JNCox55/PLED/Documentation/Poster/GUI_EX.PNG

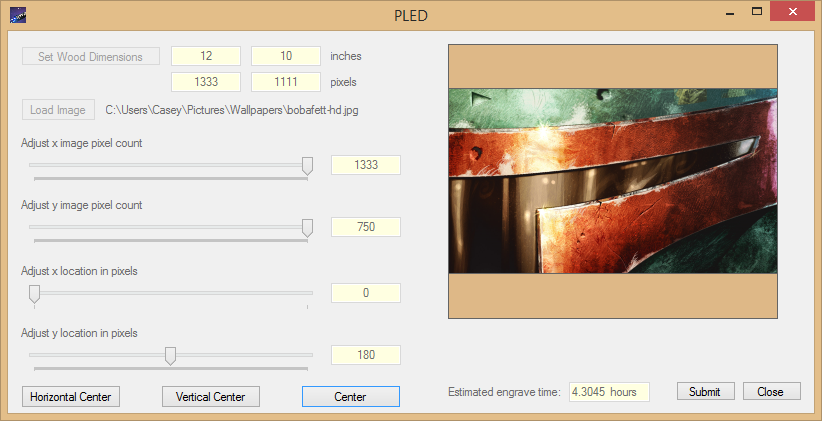
Documentation/Poster/GUI_EX.PNG
