JNCox55/PLED/Microcontroller Files./examples/boards/dk-tm4c123g/interrupts/readme.txt

Interrupts

This example application demonstrates the interrupt preemption and
tail-chaining capabilities of Cortex-M4 microprocessor and NVIC.  Nested
interrupts are synthesized when the interrupts have the same priority,
increasing priorities, and decreasing priorities.  With increasing
priorities, preemption will occur; in the other two cases tail-chaining
will occur.  The currently pending interrupts and the currently executing
interrupt will be displayed on the display; GPIO pins D0, D1 and D2 will
be asserted upon interrupt handler entry and de-asserted before interrupt
handler exit so that the off-to-on time can be observed with a scope or
logic analyzer to see the speed of tail-chaining (for the two cases where
tail-chaining is occurring).

-------------------------------------------------------------------------------

Copyright (c) 2011-2015 Texas Instruments Incorporated.  All rights reserved.
Software License Agreement

Texas Instruments (TI) is supplying this software for use solely and
exclusively on TI's microcontroller products. The software is owned by
TI and/or its suppliers, and is protected under applicable copyright
laws. You may not combine this software with "viral" open-source
software in order to form a larger program.

THIS SOFTWARE IS PROVIDED "AS IS" AND WITH ALL FAULTS.
NO WARRANTIES, WHETHER EXPRESS, IMPLIED OR STATUTORY, INCLUDING, BUT
NOT LIMITED TO, IMPLIED WARRANTIES OF MERCHANTABILITY AND FITNESS FOR
A PARTICULAR PURPOSE APPLY TO THIS SOFTWARE. TI SHALL NOT, UNDER ANY
CIRCUMSTANCES, BE LIABLE FOR SPECIAL, INCIDENTAL, OR CONSEQUENTIAL
DAMAGES, FOR ANY REASON WHATSOEVER.

This is part of revision 2.1.1.71 of the DK-TM4C123G Firmware Package.
