JNCox55/PLED/Microcontroller Files./examples/boards/dk-tm4c129x-boostxl-senshub/light_isl29023/readme.txt

Light Measurement with the ISL29023

This example demonstrates the basic use of the Sensor Library, DK-TM4C129X
and the SensHub BoosterPack to obtain ambient and infrared light
measurements with the ISL29023 sensor.

Note that the jumper on J36 for PQ7 must be disconnect to GREEN led as PQ7
is also used as INT signal by ISL29023.

The raw sensor measurements are printed to LCD and terminal. Connect a
serial terminal program to the DK-TM4C129X's ICDI virtual serial port at
115,200 baud.  Use eight bits per byte, no parity and one stop bit.  The
blue LED blinks to indicate the code is running.

-------------------------------------------------------------------------------

Copyright (c) 2013-2015 Texas Instruments Incorporated.  All rights reserved.
Software License Agreement

Texas Instruments (TI) is supplying this software for use solely and
exclusively on TI's microcontroller products. The software is owned by
TI and/or its suppliers, and is protected under applicable copyright
laws. You may not combine this software with "viral" open-source
software in order to form a larger program.

THIS SOFTWARE IS PROVIDED "AS IS" AND WITH ALL FAULTS.
NO WARRANTIES, WHETHER EXPRESS, IMPLIED OR STATUTORY, INCLUDING, BUT
NOT LIMITED TO, IMPLIED WARRANTIES OF MERCHANTABILITY AND FITNESS FOR
A PARTICULAR PURPOSE APPLY TO THIS SOFTWARE. TI SHALL NOT, UNDER ANY
CIRCUMSTANCES, BE LIABLE FOR SPECIAL, INCIDENTAL, OR CONSEQUENTIAL
DAMAGES, FOR ANY REASON WHATSOEVER.

This is part of revision 2.1.1.71 of the DK-TM4C129X Firmware Package.
