JNCox55/PLED/Microcontroller Files./examples/boards/dk-tm4c129x-em-trf7970atb/nfc_p2p_demo/readme.txt

NFC P2P Demo

This example application demonstrates the operation of the Tiva C Series
evaluation kit with the
TRF7970ATB Evaluation Module
as a NFC P2P device.

The application supports reading and writing Text, URI, and SmartPoster Tags.
The application gets a raw message buffer from the TRF79x0 stack, decodes
the information to recognized tag types, then re-encodes the data to a
buffer to be sent back out. The received tag information is displayed on the
lcd in both a summary screen and a detailed header information screen.
There is also a pulldown screen with buttons to echo the tag back and to
send a webpage link for the evaluation kit. In addition full debug
information is given across the UART0 channel to aid in NFC P2P development.

Please make sure to set the jumpers for the DK-TM4C129x board correctly.
J12, J13 set to EM_UART,
J16, J17 set to SPI

For more information on NFC please see the full NFC specification list at
http://www.nfc-forum.org/specs/spec_list/ .

-------------------------------------------------------------------------------

Copyright (c) 2014-2015 Texas Instruments Incorporated.  All rights reserved.
Software License Agreement

Texas Instruments (TI) is supplying this software for use solely and
exclusively on TI's microcontroller products. The software is owned by
TI and/or its suppliers, and is protected under applicable copyright
laws. You may not combine this software with "viral" open-source
software in order to form a larger program.

THIS SOFTWARE IS PROVIDED "AS IS" AND WITH ALL FAULTS.
NO WARRANTIES, WHETHER EXPRESS, IMPLIED OR STATUTORY, INCLUDING, BUT
NOT LIMITED TO, IMPLIED WARRANTIES OF MERCHANTABILITY AND FITNESS FOR
A PARTICULAR PURPOSE APPLY TO THIS SOFTWARE. TI SHALL NOT, UNDER ANY
CIRCUMSTANCES, BE LIABLE FOR SPECIAL, INCIDENTAL, OR CONSEQUENTIAL
DAMAGES, FOR ANY REASON WHATSOEVER.

This is part of revision 2.1.1.71 of the DK-TM4C129X Firmware Package.
