JNCox55/PLED/Microcontroller Files./examples/boards/dk-tm4c129x/sd_card/readme.txt

SD card using FAT file system

This example application demonstrates reading a file system from
an SD card.  It makes use of FatFs, a FAT file system driver.  It
provides a simple widget-based console on the display and also a
UART-based command line for viewing and navigating the file system
on the SD card.

For additional details about FatFs, see the following site:
http://elm-chan.org/fsw/ff/00index_e.html

The application may also be operated via a serial terminal attached to
UART0. The RS232 communication parameters should be set to 115,200 bits
per second, and 8-n-1 mode.  When the program is started a message will
be printed to the terminal.  Type ``help'' for command help.

-------------------------------------------------------------------------------

Copyright (c) 2013-2015 Texas Instruments Incorporated.  All rights reserved.
Software License Agreement

Texas Instruments (TI) is supplying this software for use solely and
exclusively on TI's microcontroller products. The software is owned by
TI and/or its suppliers, and is protected under applicable copyright
laws. You may not combine this software with "viral" open-source
software in order to form a larger program.

THIS SOFTWARE IS PROVIDED "AS IS" AND WITH ALL FAULTS.
NO WARRANTIES, WHETHER EXPRESS, IMPLIED OR STATUTORY, INCLUDING, BUT
NOT LIMITED TO, IMPLIED WARRANTIES OF MERCHANTABILITY AND FITNESS FOR
A PARTICULAR PURPOSE APPLY TO THIS SOFTWARE. TI SHALL NOT, UNDER ANY
CIRCUMSTANCES, BE LIABLE FOR SPECIAL, INCIDENTAL, OR CONSEQUENTIAL
DAMAGES, FOR ANY REASON WHATSOEVER.

This is part of revision 2.1.1.71 of the DK-TM4C129X Firmware Package.
