JNCox55/PLED/Microcontroller Files./examples/boards/dk-tm4c129x/usb_dev_gamepad/readme.txt

USB HID Gamepad Device

This example application turns the evaluation board into USB game pad
device using the Human Interface Device gamepad class.  The buttons on the
board are reported as buttons 1, 2, and 3.  The X and Y coordinates are
reported using the touch screen input.  This example also demonstrates how
to use a custom HID report descriptor which is specified in the
usb_game_structs.c in the g_pui8GameReportDescriptor structure.

-------------------------------------------------------------------------------

Copyright (c) 2013-2015 Texas Instruments Incorporated.  All rights reserved.
Software License Agreement

Texas Instruments (TI) is supplying this software for use solely and
exclusively on TI's microcontroller products. The software is owned by
TI and/or its suppliers, and is protected under applicable copyright
laws. You may not combine this software with "viral" open-source
software in order to form a larger program.

THIS SOFTWARE IS PROVIDED "AS IS" AND WITH ALL FAULTS.
NO WARRANTIES, WHETHER EXPRESS, IMPLIED OR STATUTORY, INCLUDING, BUT
NOT LIMITED TO, IMPLIED WARRANTIES OF MERCHANTABILITY AND FITNESS FOR
A PARTICULAR PURPOSE APPLY TO THIS SOFTWARE. TI SHALL NOT, UNDER ANY
CIRCUMSTANCES, BE LIABLE FOR SPECIAL, INCIDENTAL, OR CONSEQUENTIAL
DAMAGES, FOR ANY REASON WHATSOEVER.

This is part of revision 2.1.1.71 of the DK-TM4C129X Firmware Package.
