JNCox55/PLED/Documentation/Schematic/Senior Project Schematic.pptx

UART
TO
PC

LEVEL SHIFTER

HV1
+5V
GND

LV1
+3.3V

TB6560 DRIVER

CLK+
DIR+
+24V
GND

A
Ā
B
Ḇ

24V

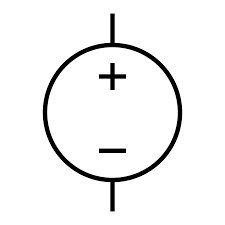
[picture p18: figure]
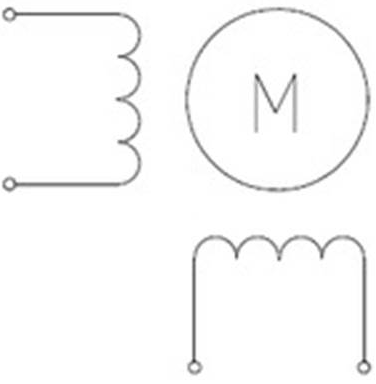
[picture p19: figure]

ROT. ENCODER

PhaA
PhaB
+5V
GND

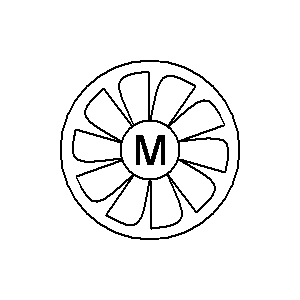
[picture p20: figure]

+12V
GND

TM4C123GXL

UART1 CTS (PF1)
UART1 RTS (PC4)
UART1 RX (PB0)
UART1 TX (PB1)
QEI0 PhaA (PD6)
QEI0 PhaB (PD7)
QEI1 PhaA (PC5)
QEI1 PhaB (PC6)

PWM0 (PB6)
GPIO0 (PE1)
GPIO1 (PD1)
GPIO2 (PD2)
GPIO3 (PD3)
+5V
+3.3V
GND

LDA+
LDK-
INT

FLEXMOD P3

MOD+
GND
+12V

ROT. ENCODER

PhaA
PhaB
+5V
GND

TB6560 DRIVER

CLK+
DIR+
+24V
GND

A
Ā
B
Ḇ

12V

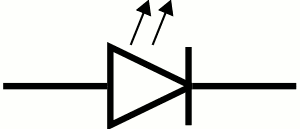
[picture p21: figure]

2W M140 445 NM

2A
