JNCox55/PLED/Documentation/Poster/PLED Poster.pdf

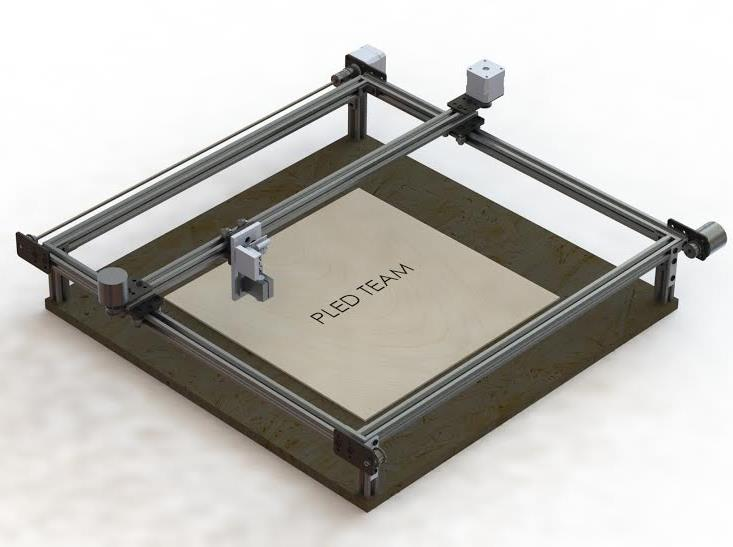
[picture p22: figure]
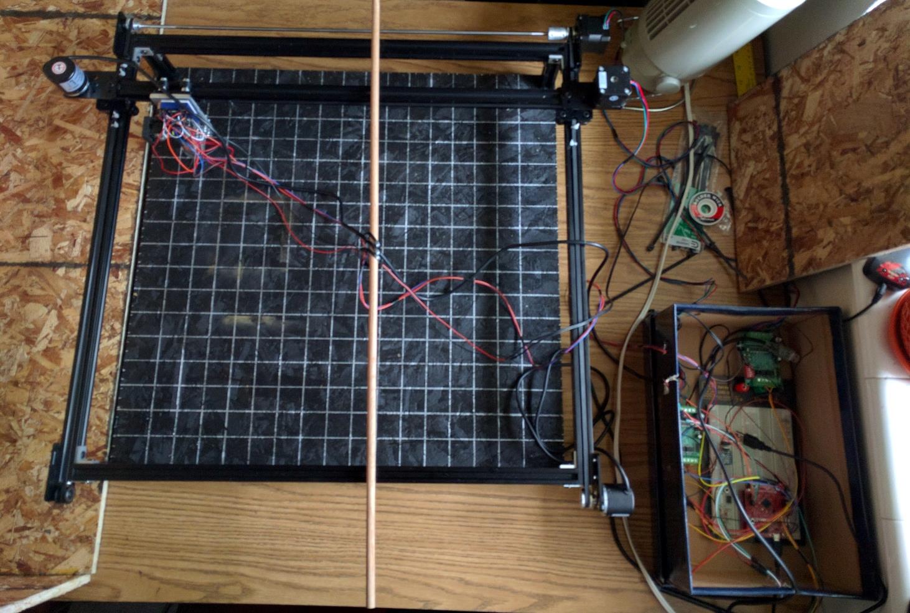
[picture p23: figure]
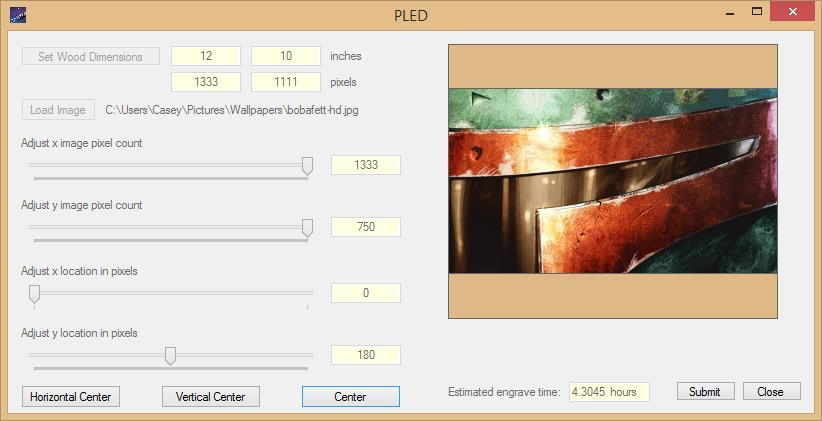
[picture p24: figure]
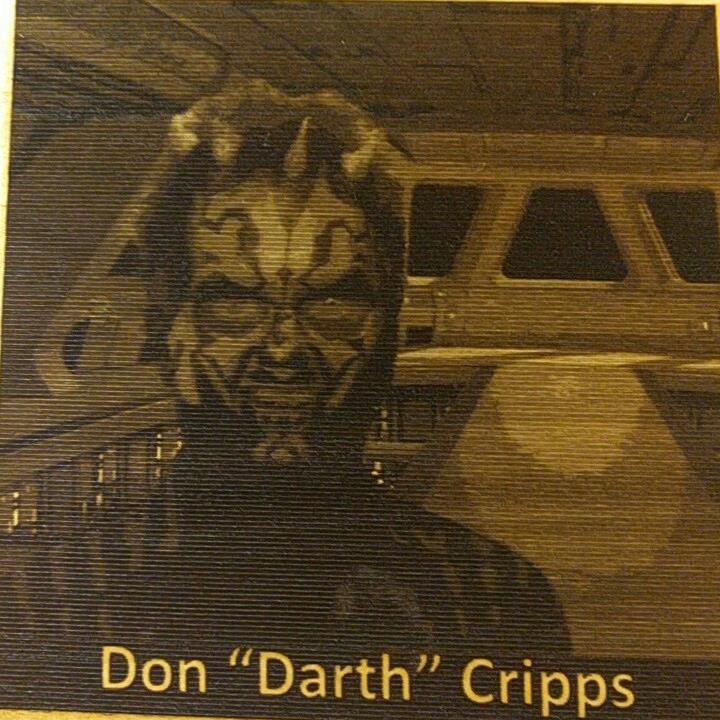
[picture p25: figure]
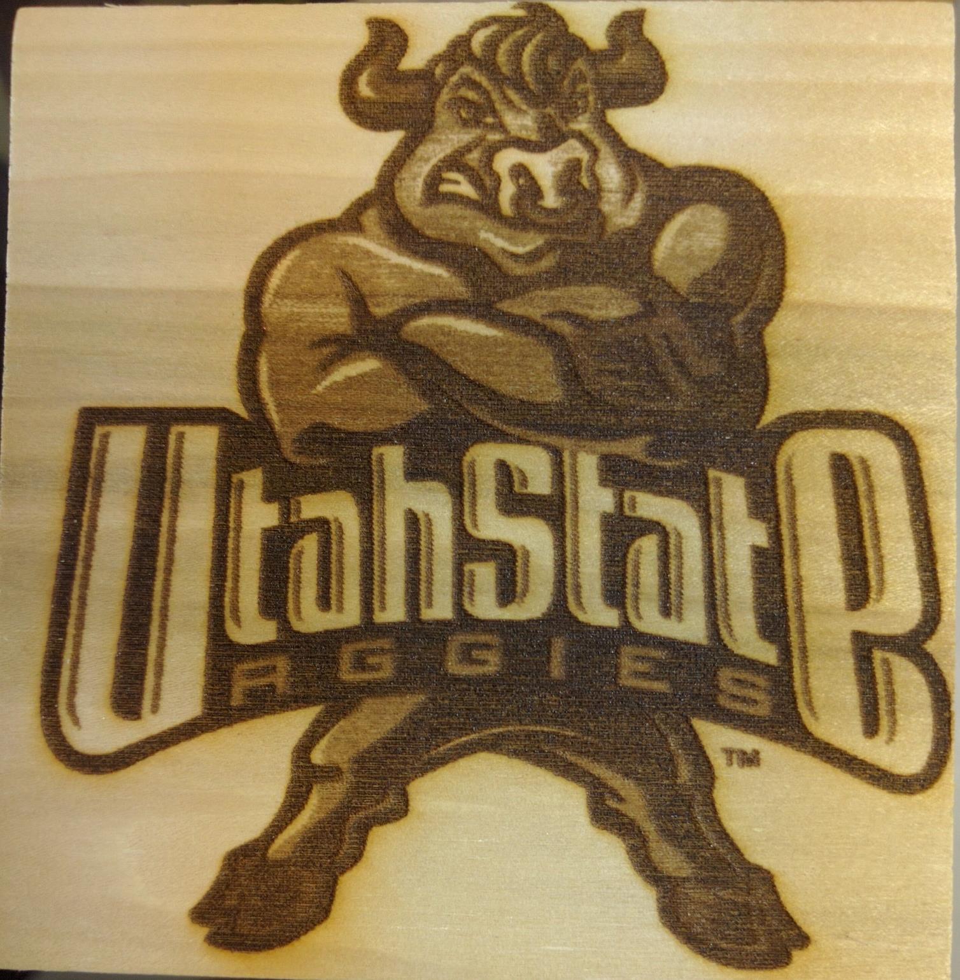
[picture p26: figure]
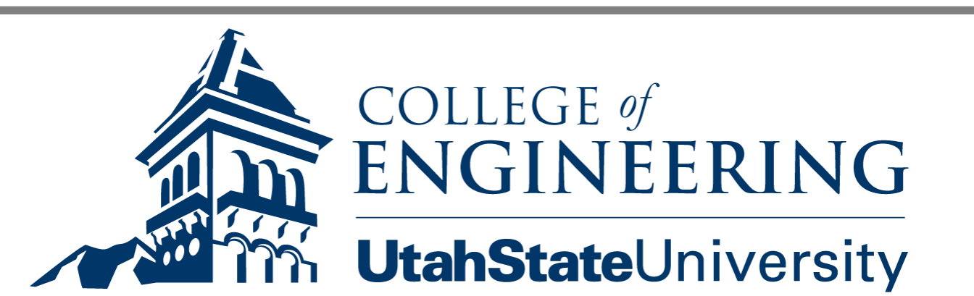
[picture p27: figure]

Team: Casey Wood, Justin Cox, | Special Thanks: Don Cripps
Tate Shorthill, Zachary Garrard | Jolynne Berrett, Doran Baker

# PLED

## Plaque Laser Engraving Device

### Introduction

### User Interface

### Results

### Machine Structure

The Plaque Laser Engraver Device (PLED) is a multidisciplinary project. It was designed with the following purposes and goals in mind:

- control laser head using CNC standards
- engrave 8 shade grayscale images
- provide an affordable hobbyist design
- generate a competent and user friendly software package
- provide engineering, design, and management experience to our team

Our mechanical structure utilized mostly affordable and commercially available components. We tried to avoid necessity for custom machined parts. It is also designed to be very structurally sound and reliable, while being lightweight and easy to work with. Any machining that occurred was done using university resources by the PLED team.

Laser shield

The user interface, written in C#, performs a number of key functions:

- laser head location specification
- image sizing on plaque
- image pixel conversion into 8 shades of grayscale
- host software on PC to control and communicate with PLED
- time estimation for engraving
