JNCox55/PLED/Documentation/Final Report/TableofContents_Wood-Garrard-Cox.pdf

## P.L.E.D

PLAQUE LASER ENGRAVER DEVICE

CASEY WOOD
ZACHARY GARRARD
JUSTIN COX
TATE SHORTHILL
INCASEYWOOD@GMAIL.COM
DDCBANZ@GMAIL.COM
JUSTIN.N.COX@GMAIL.COM
SHORTHILLT@GMAIL.COM

03/29/2016

1

TABLE OF CONTENTS

1. EXECUTIVE SUMMARY | 2
2. INTRODUCTION | 3
3. METHODS | 3
4. RESULTS | 3
5. DISCUSSION | 4
6. CONCLUSION | 4
7. APPENDICES | 5
7.1. APPENDIX 1 – BUDGET | 5
7.2. APPENDIX 2 – SCHEMATICS | 5
7.3. APPENDIX 3 – CODE | 5

2

### 1. EXECUTIVE SUMMARY

The executive summary provides an overview of the content contained in the report. Many people write this section after the rest of the document is completed. This section is important in that it provides a high-level summary of the detail contained within the rest of the document.
