JNCox55/PLED/reciepts/Casey/2016-05-04_PosterBoard (Michaels).pdf

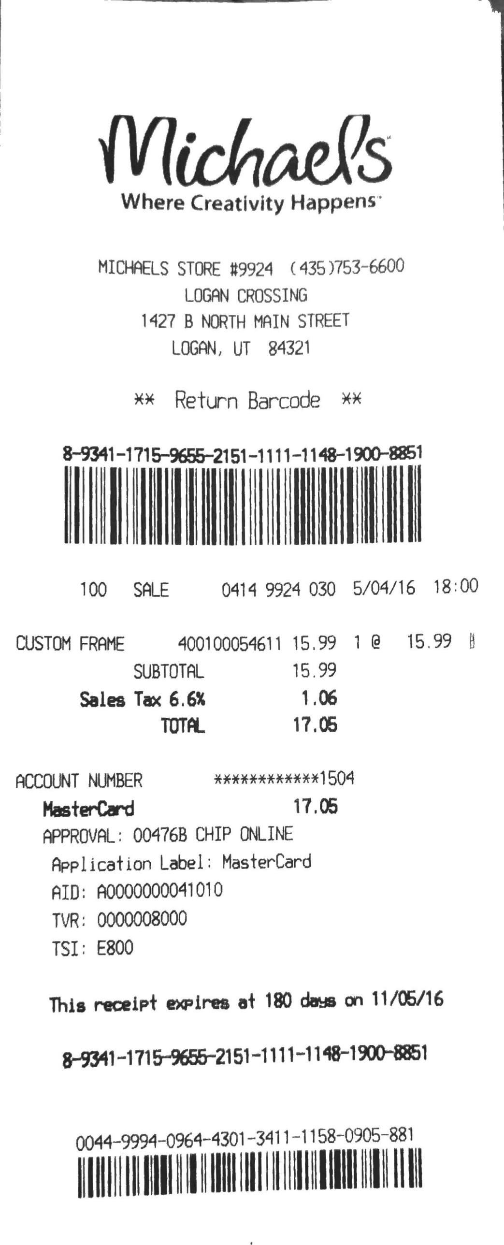
[picture p78: page 1]
