JNCox55/PLED/Documentation/Other/Images/Aggies.jpg

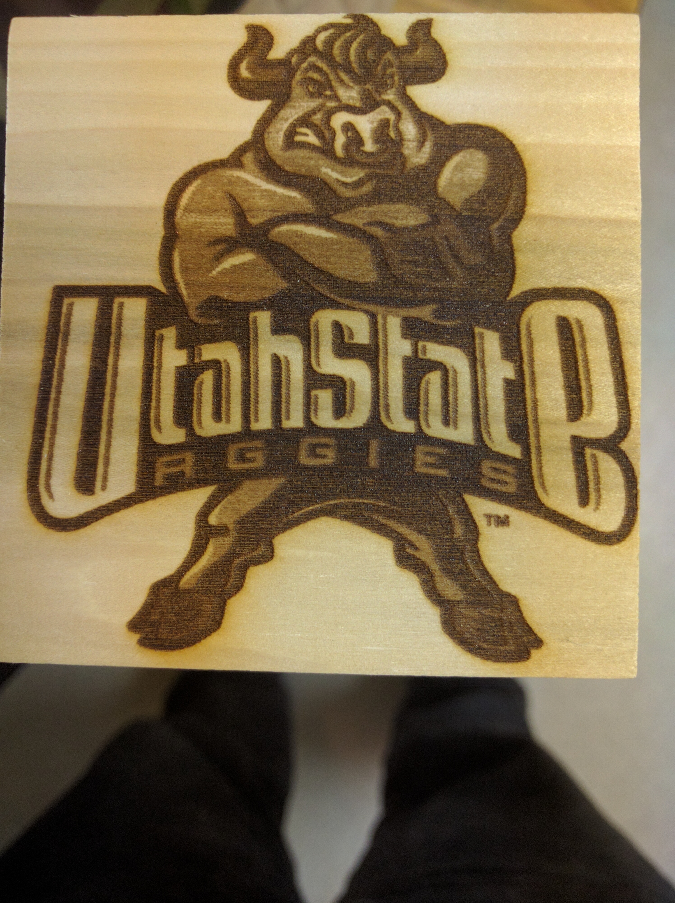
Documentation/Other/Images/Aggies.jpg
