JNCox55/PLED/Documentation/Other/Images/Cripps.jpg

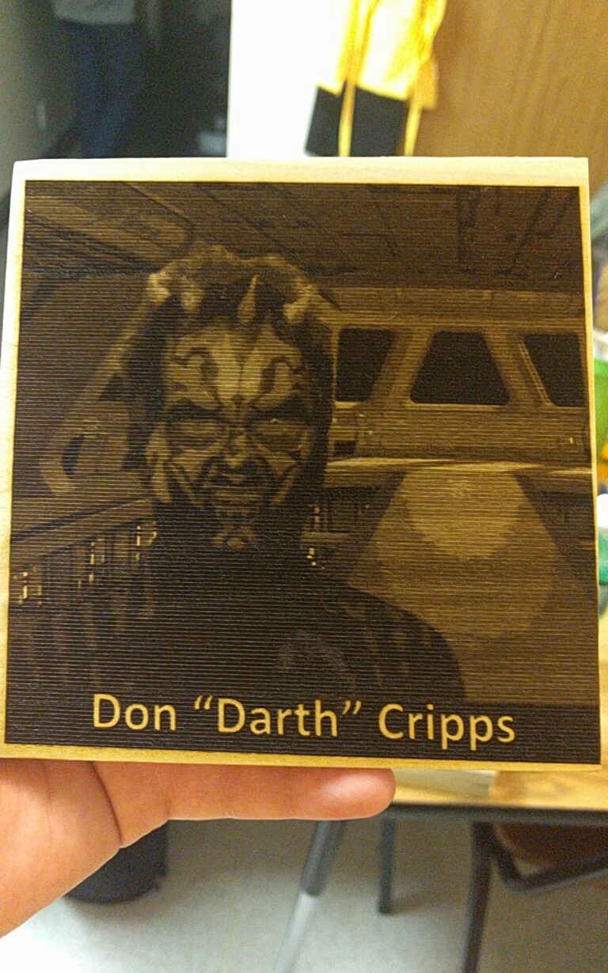
Documentation/Other/Images/Cripps.jpg
