JNCox55/PLED/Documentation/Other/Images/hackUSU.jpg

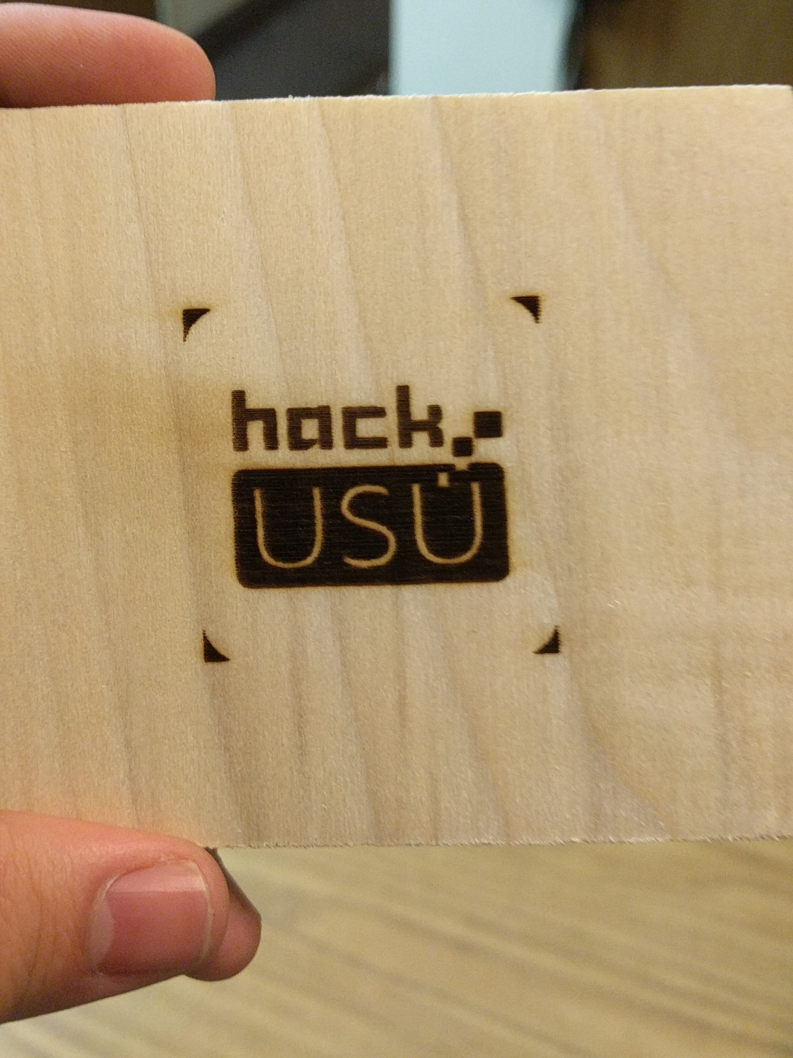
Documentation/Other/Images/hackUSU.jpg
