JNCox55/PLED/Documentation/Other/Images/LaserShield.jpg

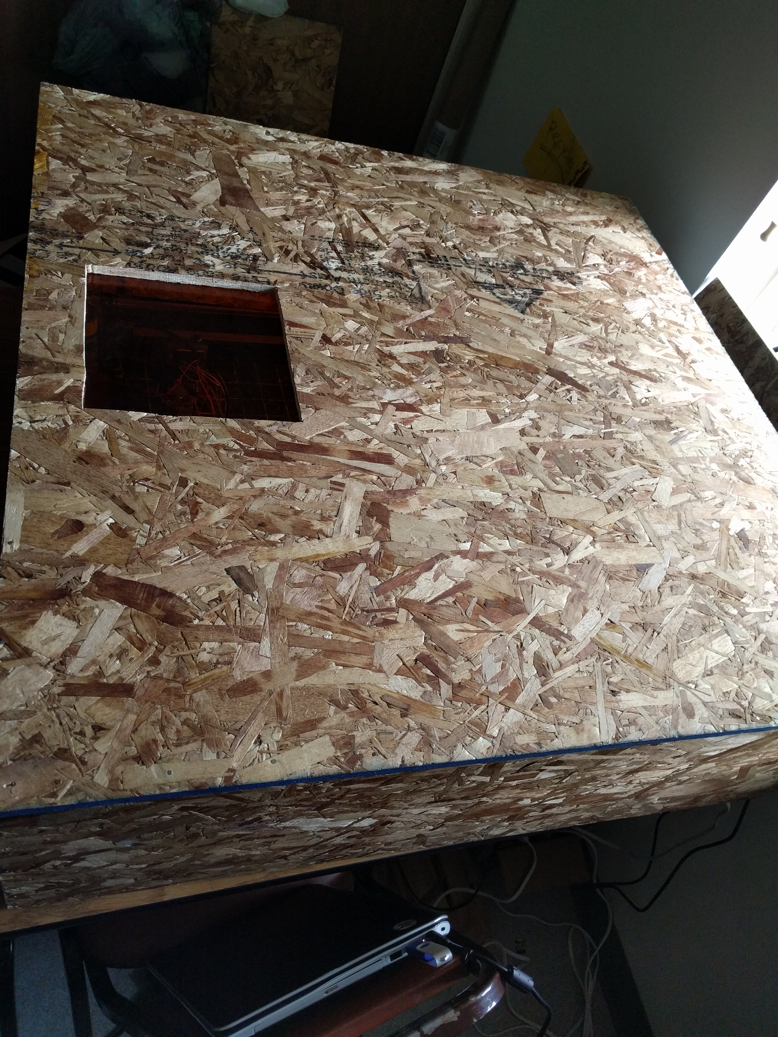
Documentation/Other/Images/LaserShield.jpg
