JNCox55/PLED/Documentation/Other/Images/LoganTemple.jpg

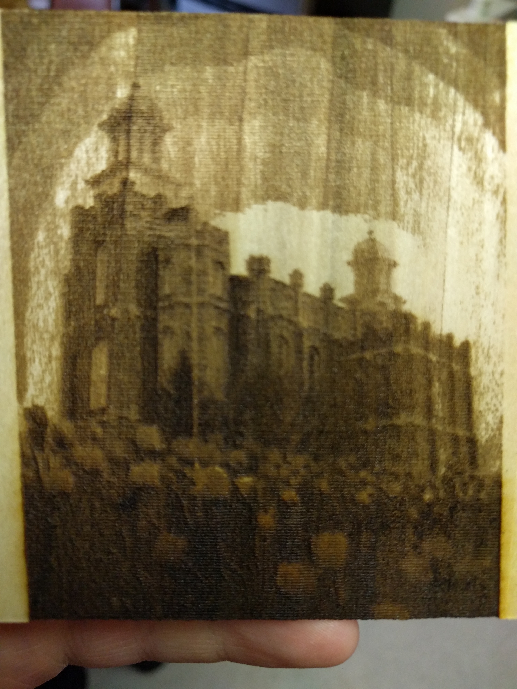
Documentation/Other/Images/LoganTemple.jpg
