JNCox55/PLED/Documentation/Other/Images/PLED Machine.jpg

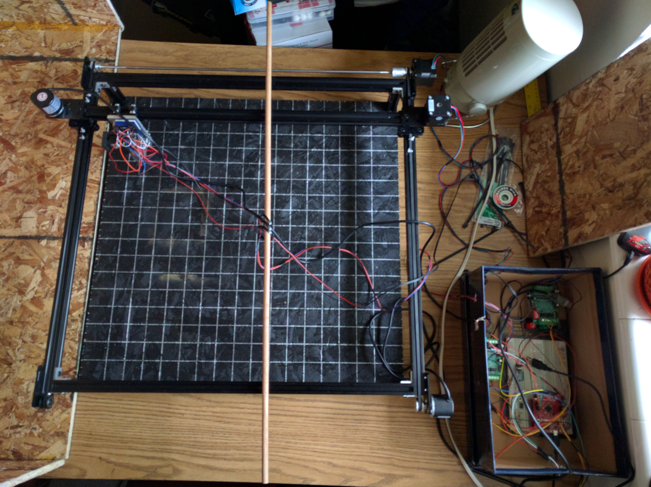
Documentation/Other/Images/PLED Machine.jpg
