JNCox55/PLED/Documentation/Other/Images/U-State.jpg

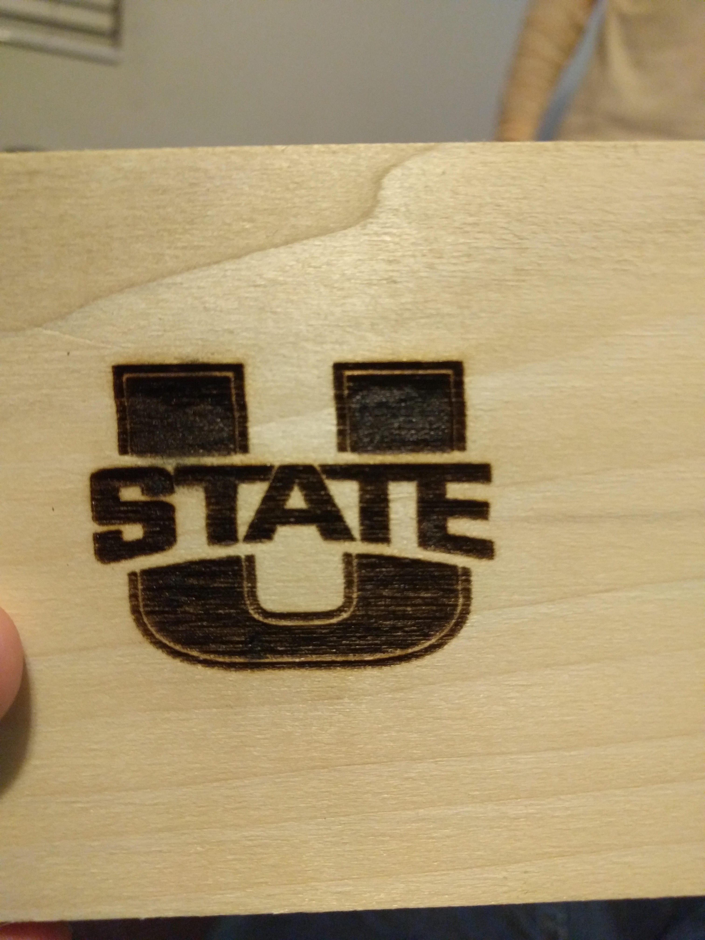
Documentation/Other/Images/U-State.jpg
