JNCox55/PLED/Mechanical/PLED_TEAM-4-28/PLED_TEAM-4-28/BRAINSTROMING_PROCESS_IDEAS/2.PNG

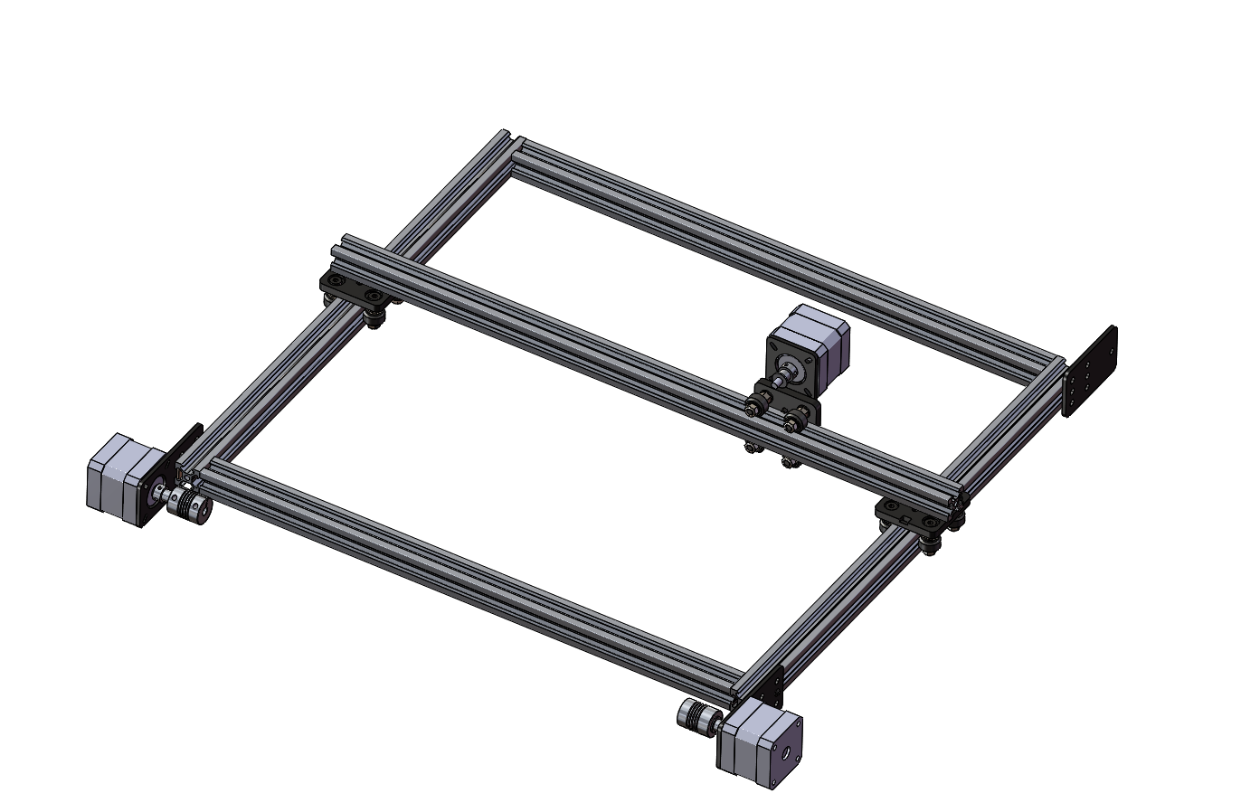
Mechanical/PLED_TEAM-4-28/PLED_TEAM-4-28/BRAINSTROMING_PROCESS_IDEAS/2.PNG
