JNCox55/PLED/Mechanical/PLED_TEAM-4-28/PLED_TEAM-4-28/BRAINSTROMING_PROCESS_IDEAS/gantry.PNG

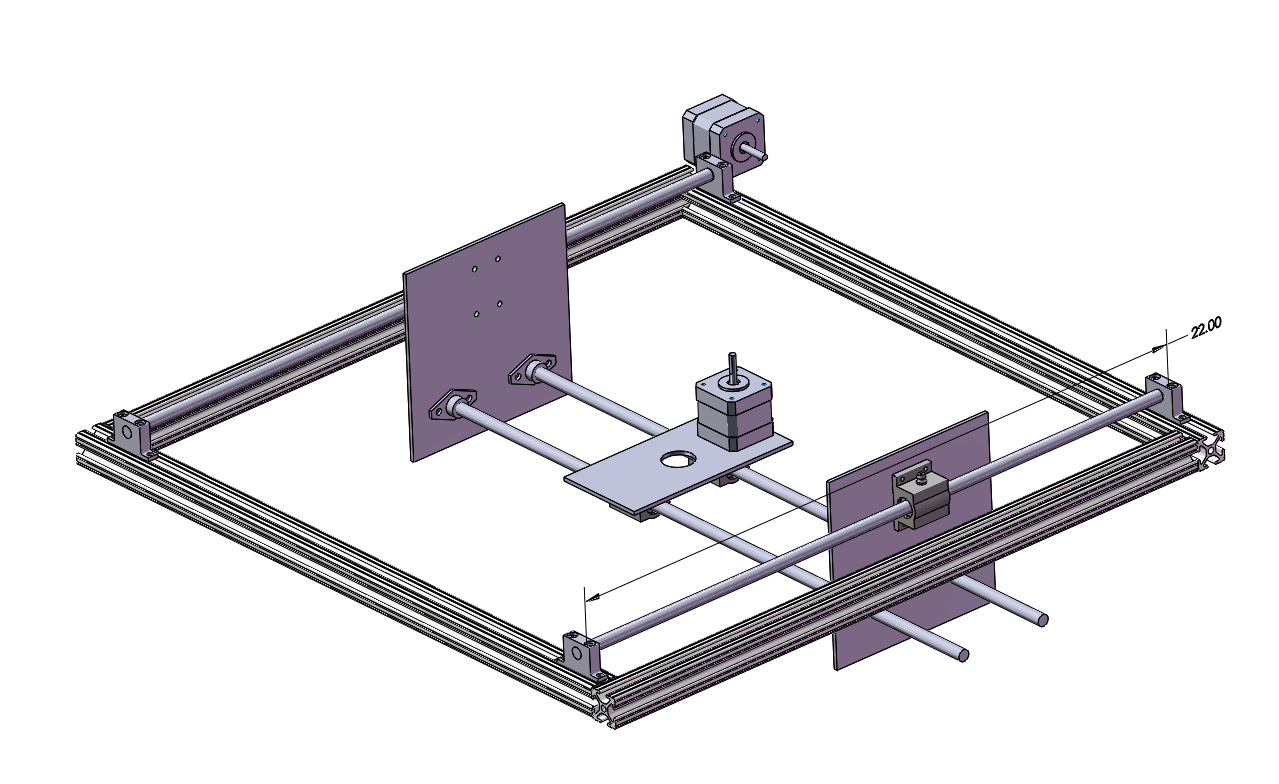
Mechanical/PLED_TEAM-4-28/PLED_TEAM-4-28/BRAINSTROMING_PROCESS_IDEAS/gantry.PNG
