JNCox55/PLED/Mechanical/PLED_TEAM-4-28/PLED_TEAM-4-28/BRAINSTROMING_PROCESS_IDEAS/newest pictures/VSLOT_Plates_32_FINAL_Motor17__18177.1388462172.1280.1280.jpg

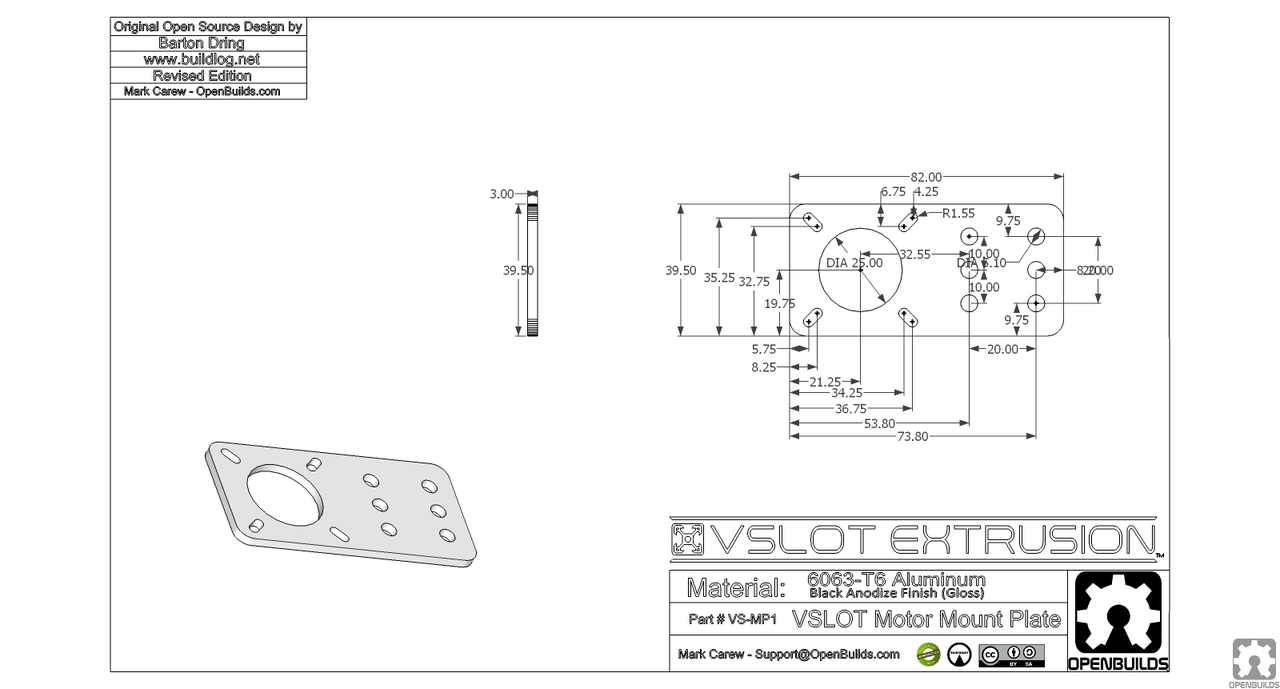
Mechanical/PLED_TEAM-4-28/PLED_TEAM-4-28/BRAINSTROMING_PROCESS_IDEAS/newest pictures/VSLOT_Plates_32_FINAL_Motor17__18177.1388462172.1280.1280.jpg
