JNCox55/PLED/Mechanical/PLED_TEAM-4-28/PLED_TEAM-4-28/PLED_FINAL_MECHANICAL_FILES/FINAL PICS/PLED_TEAM_GANTRY.JPG

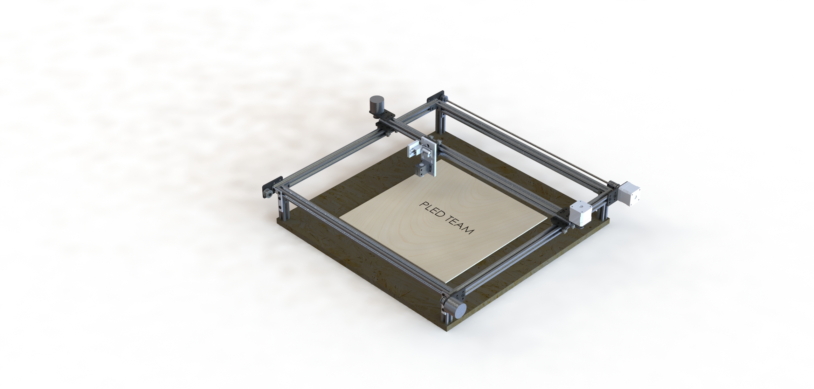
Mechanical/PLED_TEAM-4-28/PLED_TEAM-4-28/PLED_FINAL_MECHANICAL_FILES/FINAL PICS/PLED_TEAM_GANTRY.JPG
