JNCox55/PLED/Mechanical/PLED_TEAM-4-28/PLED_TEAM-4-28/PLED_FINAL_MECHANICAL_FILES/FINAL PICS/snip2.PNG

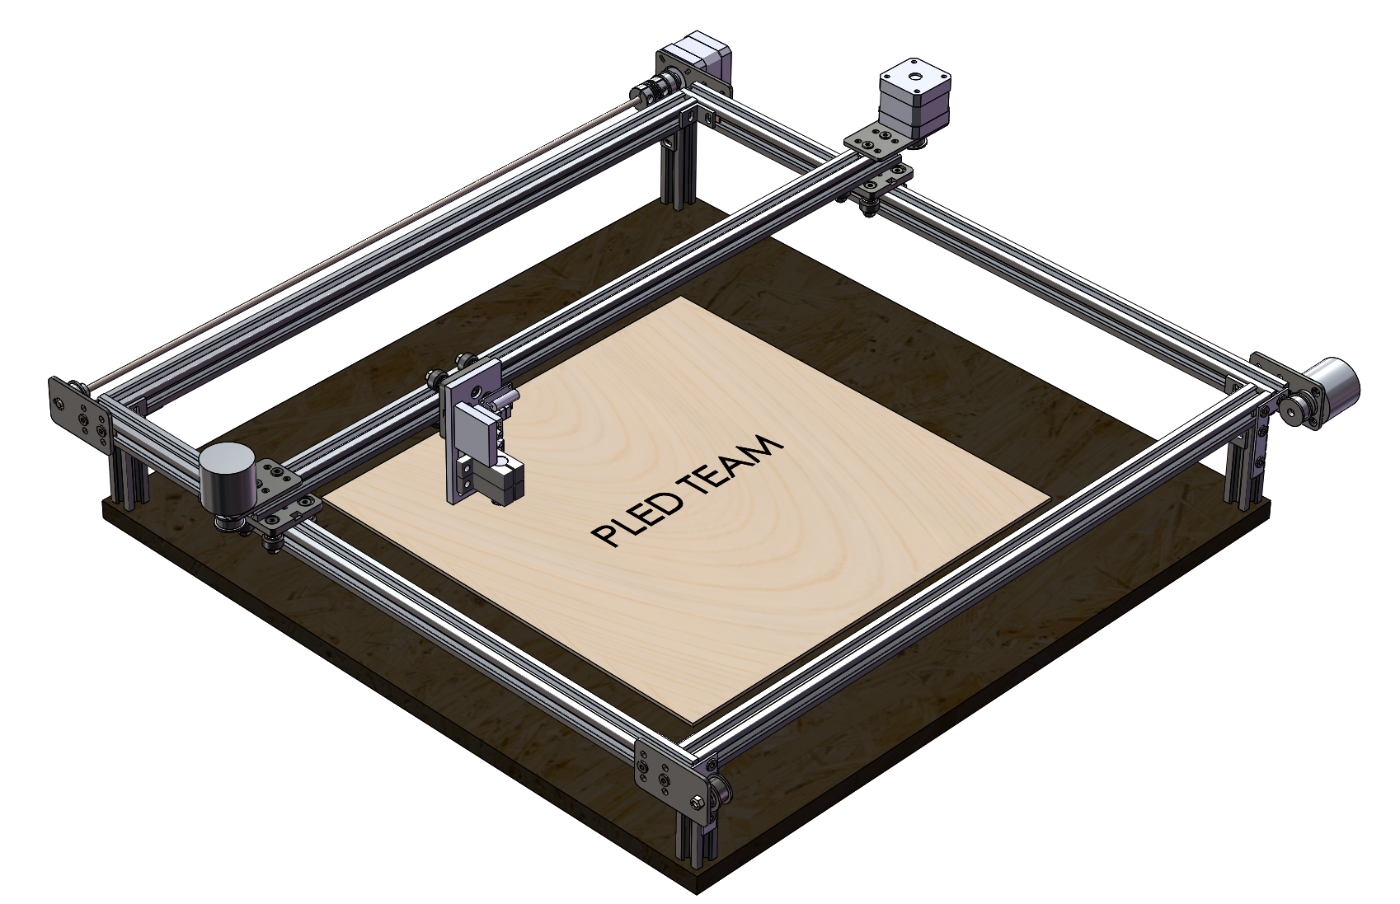
Mechanical/PLED_TEAM-4-28/PLED_TEAM-4-28/PLED_FINAL_MECHANICAL_FILES/FINAL PICS/snip2.PNG
