JNCox55/PLED/PLED_GUI/PLED_GUI/Dimension.png

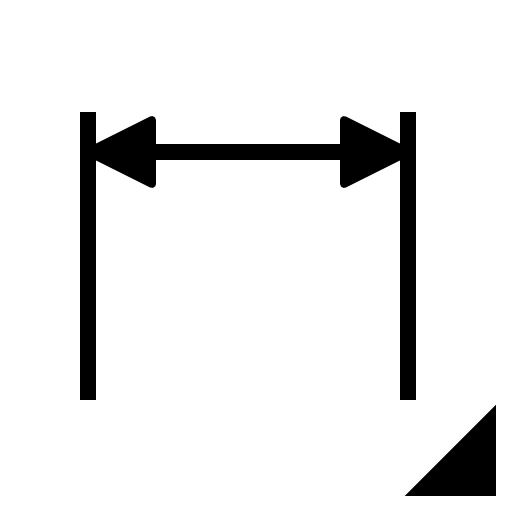
PLED_GUI/PLED_GUI/Dimension.png
