JNCox55/PLED/Mechanical/PLED_TEAM-4-28/PLED_TEAM-4-28/BRAINSTROMING_PROCESS_IDEAS/newest pictures/Amazon parts to buy.docx

Amazon parts to buy:

Option 1 5mm rod long

http://www.amazon.com/Polished-Finish-Precision-Annealed-Diameter/dp/B00CNM6RFA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

5mm X 5mm coupler

http://www.amazon.com/uxcell-Motor-Coupler-Flexible-Coupling/dp/B00DCAISM2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

option 2

http://www.amazon.com/Helicopter-100mm-Ground-Shaft-Round/dp/B00NQ9NBWQ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

Machining:

1. Encoder plate (2x)
2. Bearing plate (1x)
3. Pulley ID enlarged to 6mm (2x)
4. Pulley enlarged to 8mm (maybe if we chose to do that)
