JNCox55/PLED/Mechanical/PLED_TEAM-4-28/PLED_TEAM-4-28/PLED_FINAL_MECHANICAL_FILES/MANUFACTURE/ASSEMBLY_FILES/PARTS_LIST_FINAL.pdf

ITEM NO. | PART NUMBER | Q T Y
1 | V-SLOT_600 | 4
2 | Motor Mount Plate Nema 17 | 1
3 | Double Tee Nut | 8
4 | Flexible Coupling 5mm x 6mm | 1
5 | GT2 Timing Pulley 30 Tooth | 3
6 | MOD_NEMA_17_MOUNT_PLATE | 1
7 | NEMA_17_MOTOR | 2
8 | V-SLOT_670 | 1
9 | PRINT_AREA | 1
10 | Idler Pulley Plate | 1
11 | Slot Washer 15 x 5 x 2 | 2
12 | Ball Bearing 5 x 16 x 5 | 3
13 | Smooth Idler Pulley Wheel | 1
14 | Nylon Spacer 0.125in | 1
15 | Precision Shim 8 x 5 x 1 | 25
16 | Nylon Insert Lock Nut M5 | 13
17 | M5 x 8 | 24
18 | BEARING_PLATE | 1
19 | Encoder_Plate | 2
20 | ENCODER | 2
21 | PULLEY_6MM | 2
22 | M5 x 10 | 8
23 | SHAFT_5mm | 1
24 | V-SLOT_LEGS | 4
25 | L Bracket Single | 8
26 | Tee Nut | 28
27 | M5 x 25 | 13
28 | Delrin Mini V Wheel | 12
29 | Ball Bearing 5 x 10 x 4.2 | 24
30 | Mini Eccentric Spacer 6mm | 6
31 | Aluminum Spacer 6mm | 6
32 | MOD_MINI_V_PLATE | 2
33 | ZINC PLATED STEEL 2.5 INCH L- BRACKET | 4
34 | Self Tapping Screw | 4
35 | BASE | 1
36 | LASER_PLATE | 1
37 | LASER_MOUNT | 2
38 | FREAKIN_LASER | 1
39 | LASER_DRIVER_APPROXIMATE_MODEL | 1
40 | 6-32_2IN_FH_SCREW | 2
41 | Mini V Wheel Plate | 1
42 | M3 FLAT HEAD SCREWS (ENCODERS) | 6
43 | M3 SHC SCREW (MOTORS) | 8
44 | 10-32 SCREWS (LASER MOUNT) | 4
45 | 10-32 NUTS/ WASHERS | 4
46 | 10-32 SELF TAPPING SCREWS 1 INCH LONG | 4

THIS SHEET INCLUDES THE TOTAL PARTS LIST. (PARTS ORDERED INCLUDE SUB-PARTS WHICH ARE ALSO INCLUDED IN THIS LIST. EXAMPLE: WE ORDERED A WHEEL BUT EACH WHEEL INCLUDED BEARINGS, SHIMS AND WASHERS.)
