JNCox55/PLED/Mechanical/PLED_TEAM-4-28/PLED_TEAM-4-28/PLED_FINAL_MECHANICAL_FILES/MANUFACTURE/ASSEMBLY_FILES/PARTS_LIST_FINAL_2.pdf

ITEM NO. | PART NAME | QTY
1 V-SLOT_600 | 4
2 MOTOR_MOUNT | 1
MOD_NEMA_17_MOUNT_PLATE | 1
Double Tee Nut | 1
Flexible Coupling 5mm x 6mm | 1
GT2 Timing Pulley 30 Tooth | 1
M5 x 8 | 2
NEMA_17_MOTOR | 1
3 V-SLOT_670 | 1
4 PRINT_AREA | 1
5 FREE_IDLER_PULLEY | 1
Idler Pulley Plate | 1
Double Tee Nut | 1
Slot Washer 15 x 5 x 2 | 2
Ball Bearing 5 x 16 x 5 | 2
Smooth Idler Pulley Wheel | 1
Nylon Spacer 0.125in | 1
Precision Shim 8 x 5 x 1 | 1
Nylon Insert Lock Nut M5 | 1
M5 x 25 | 1
M5 x 8 | 2
6 MOTOR_MOUNT_2 | 1
Motor Mount Plate Nema 17 | 1
Double Tee Nut | 1
GT2 Timing Pulley 30 Tooth | 1
M5 x 8 | 2
NEMA_17_MOTOR | 1
7 BEARING_MOUNT | 1
BEARING_PLATE | 1
Double Tee Nut | 1
Ball Bearing 5 x 16 x 5 | 1
M5 x 8 | 2
8 ENCODER_MOUNT | 2
Encoder_Plate | 1
ENCODER | 1
Double Tee Nut | 1
PULLEY_6MM | 1
M5 x 8 | 2
9 SHAFT_5mm | 1
10 GT2 Timing Pulley 30 Tooth | 1
11 V-SLOT_LEGS | 4
12 CORNER_BRACKETS | 8
L Bracket Single | 1
Tee Nut | 2
13 MOD_MINI_V_GANTRY_ASSEMBLY | 2
MOD_MINI_V_GANTRY | 1
M5 x 25 | 4
Delrin Mini V Wheel | 2
Delrin Mini V Wheel | 1
Ball Bearing 5 x 10 x 4.2 | 2
Precision Shim 8 x 5 x 1 | 2

THIS SHEET SHOWS ALL THE PARTS WITHIN EACH ITEM OR SUB-ASSEMBLY

Nylon Insert Lock Nut M5

1
Aluminum Spacer 6mm

1
Delrin Mini V Wheel

2
Delrin Mini V Wheel

1
Ball Bearing 5 x 10 x 4.2

2
Precision Shim 8 x 5 x 1

2
Nylon Insert Lock Nut M5

1
Mini Eccentric Spacer 6mm

1
MOD_MINI_V_PLATE

1
Double Tee Nut

1
M5 x 10

2
14 L_BRACKET_ASSEMBLY

2
ZINC PLATED STEEL 2.5 INCH L- BRACKET

1
Self Tapping Screw

1
Tee Nut

3
M5 x 8

3
15 L_BRACKET_ASSEMBLY_REVERSE

2
ZINC PLATED STEEL 2.5 INCH L- BRACKET

1
Self Tapping Screw

1
Tee Nut

3
M5 x 8

3
16 BASE

1
17 LASER_ASSEMBLY

1
LASER_PLATE

1
FREAKIN_LASER_MOUNT

1
LASER_MOUNT

2
FREAKIN_LASER

1
LASER_DRIVER_APPROXIMATE_MODEL

1
6-32_2IN_FH_SCREW

2
MINI_V_GANTRY

1
M5 x 25

4
Mini V Wheel Plate

1
Delrin Mini V Wheel

2
Delrin Mini V Wheel

1
Ball Bearing 5 x 10 x 4.2

2
Precision Shim 8 x 5 x 1

2
Nylon Insert Lock Nut M5

1
Aluminum Spacer 6mm

1
Delrin Mini V Wheel

2
Delrin Mini V Wheel

1
Ball Bearing 5 x 10 x 4.2

2
Precision Shim 8 x 5 x 1

2
Nylon Insert Lock Nut M5

1
Mini Eccentric Spacer 6mm

1
M5 x 10

4
