JNCox55/PLED/reciepts/Casey/Casey Costs.xlsx

 | P/N | Description | Vendor | $ Item | QTY | $ Subtotal | $ Shipping
 | 1185 | Mini V Gantry Set | OpenBuilds.org | $28.95 | 3 | $86.85 | $24.68
 | 470 | GT2 Timing Belt | OpenBuilds.org | $2.50 | 14 | $35.00
 | 200 | GT2 30-Tooth Pulley | OpenBuilds.org | $6.95 | 5 | $34.75
 | 230-LP | V-Slot Linear Rail (1500 mm) | OpenBuilds.org | $16.50 | 2 | $33.00
 | 570 | Idler pulley Plate | OpenBuilds.org | $6.95 | 4 | $27.80
 | 575 | Motor mount Plate | OpenBuilds.org | $6.95 | 2 | $13.90
 | 170-LP | V-Slot Linear Rail (1000 mm) | OpenBuilds.org | $11.00 | 1 | $11.00
 | 60 | Double Tee Nut | OpenBuilds.org | $0.85 | 10 | $8.50
 | 545 | L Bracket | OpenBuilds.org | $1.00 | 8 | $8.00
 | 550 | Smooth Idler Pulley | OpenBuilds.org | $5.45 | 1 | $5.45
 | 115 | Low Profile M5 Screws | OpenBuilds.org | $0.15 | 36 | $5.40
 | 50 | Tee Nuts (25 Pack) | OpenBuilds.org | $4.95 | 1 | $4.95
 | 730 | Belt Clamp | OpenBuilds.org | $0.60 | 6 | $3.60
 | 30 | Ball Bearing | OpenBuilds.org | $1.00 | 1 | $1.00
 | DC5-24V | 600P/R Rotary Encoder | Amazon.com | $17.45 | 2 | $34.90 | $0.00
 | TB6560 | Motor Driver | Amazon.com | $14.99 | 2 | $29.98 | $0.00
 | Nema 17 | Stepper Motors | Amazon.com | $13.99 | 2 | $27.98
 | S1933X - 3 | Safety Eyewear (3 Pack) | Amazon.com | $26.99 | 1 | $26.99 | $0.00
 | RibbonCable | 10 Wire, 15ft Ribbon Cable | Amazon.com | $10.95 | 1 | $10.95 | $0.00
 | O1 rod | 36", 5mm Rod | Amazon.com | $10.78 | 1 | $10.78 | $0.00
 | Coupler | 5x5mm Coupler | Amazon.com | $5.09 | 1 | $5.09
 | S1933X | Safety Eyewear | Amazon.com | $7.92 | 1 | $7.92 | $0.00
 | WYPH IIC I2C | Level Converter 3.3 to TTL | Amazon.com | $5.87 | 1 | $5.87 | $0.00
 | Amber Plexi | 12" x 12" x 0.118" Amber PG | Amazon.com | $5.25 | 1 | $5.25 | $7.48
 | Wood | Wood for Testing | Home Depot | $21.66 | 1 | $21.66 | $0.00
 | Wood | Wood for Testing | Home Depot | $19.63 | 1 | $19.63 | $0.00
 | Wood | Wood for Enclosure | Home Depot | $11.04 | 1 | $11.04 | $0.00
 | Wood/Ties | Test wood and cable ties | Home Depot | $7.46 | 1 | $7.46 | $0.00
 | Spacers | Washers and spacers | Home Depot | $7.35 | 1 | $7.35 | $0.00
 | Box Materials | ZipTies, nails, dowell, rings | Home Depot | $6.90 | 1 | $6.90 | $0.00
 | m3-wash | Motor/Encoder Spacers | Home Depot | $0.48 | 6 | $2.88 | $0.00
 | Corner Brace | L-Beam for Frame | Home Depot | $2.84 | 1 | $2.84 | $0.00
 | m3-0.5x10mm | Motor Fasteners | Home Depot | $0.48 | 3 | $1.44 | $0.00
 | Wood Glue | To build enclosure | Lowes | $4.25 | 1 | $4.25 | $0.00
 | Yard Stick | Straight edge for grid | Lowes | $3.18 | 1 | $3.18 | $0.00
 | Sharpie | Silver sharpie for grid | Lowes | $1.58 | 1 | $1.58 | $0.00
 | Spray Paint | Black Paint for Base | Lowes | $1.05 | 1 | $1.05 | $0.00
 | Frame mat | Frame mat for poster | Michael's | $17.06 | 1 | $17.06 | $0.00
 | Subtotal |  |  |  |  | $553.23
Shipping |  |  |  |  |  | $32.16
Total |  |  |  |  |  | $585.39
