JNCox55/PLED/reciepts/Zach/Zach Costs.xlsx

 | P/N | Description | Vendor | $ Item | QTY | $ Subtotal | $ Shipping
 | 445 M140 Module | Laser Module #1 | DTR's Laser Shop | $72.00 | 1 | $72.00 | $0.00
 | 445 M140 Module | Laser module #2 | DTR's Laser Shop | $72.00 | 1 | $72.00 | $0.00
 | Gdstime 3007 | Cooling Fan | Amazon.com | $8.59 | 1 | $8.59 | $0.00
 | VIO 1.5G | Thermal Grease | Amazon.com | $4.95 | 1 | $4.95
 | FlexMod P3 | Laser Driver | Innolasers | $35.99 | 1 | $35.99 | $7.54
 | TO-220/TO-202 | Heat Sink | Amazon.com | $5.00 | 1 | $5.00 | $0.00
 | 381531274978 | LASORB | eBay.com | $11.00 | 1 | $11.00 | $2.50
 | SK12 | Laser Heat Sink | Amazon.com | $5.15 | 1 | $5.15 | $0.00
 | TTL-232R-3V3 | USB UART Adapter | Amazon.com | $19.95 | 1 | $19.95
 | Fasteners | Fasteners/washers/bolts | Fastenal | $10.67 | 1 | $10.67 | $0.00
 | Poster Print | Final Poster Print | ENGR Computer Lab | $19.97 | 1 | $19.97 | $0.00
 | Transistor | Transistor laser driver | ECE Store | $4.64 | 1 | $4.64 | $0.00
 | Flexmod P3 | Backup Laser Driver | Innolasers | $35.99 | 1 | $35.99 | $35.30
 | Subtotal |  |  |  |  | $305.90
Shipping |  |  |  |  |  | $45.34
Total |  |  |  |  |  | $351.24
