JNCox55/PLED/reciepts/Reimbursement/Reimbursement request.xlsx

Sheet: Budget
PLED Budget
Subsystem | Price
Laser System | $150
Motors System | $60
Feedback System | $35
Microcontroller | $15
Mechanical Structure | $400
Cabling | $35
Safety | $35
Testing Materials | $40
Total | $770

Sheet: BOM
PLED Purchases
Date | P/N | Description | Vendor | $ Item | QTY | $ Subtotal | $ Shipping
2015-10-04 | S1933X | Safety Eyewear | Amazon.com | $7.92 | 1 | $7.92 | $0.00
2015-12-16 | 445 M140 Module | Laser Module #1 | DTR's Laser Shop | $72.00 | 1 | $72.00 | $0.00
2016-01-02 | TTL-232R-3V3 | USB UART Adapter | Amazon.com | $19.95 | 1 | $19.95 | $0.00
 | SK12 | Laser Heat Sink |  | $5.15 | 1 | $5.15
2016-01-02 | FlexMod P3 | Laser Driver | Innolasers | $35.99 | 1 | $35.99 | $7.54
2016-01-09 | TB6560 | Motor Driver | Amazon.com | $14.99 | 2 | $29.98 | $0.00
 | Nema 17 | Stepper Motors |  | $13.99 | 2 | $27.98
2016-01-15 | TO-220/TO-202 | Heat Sink | Amazon.com | $5.00 | 1 | $5.00 | $0.00
2016-01-16 | WYPH IIC I2C | Level Converter 3.3 to TTL | Amazon.com | $5.87 | 1 | $5.87 | $0.00
2016-01-21 | Gdstime 3007 | Cooling Fan | Amazon.com | $8.59 | 1 | $8.59 | $0.00
 | VIO 1.5G | Thermal Grease |  | $4.95 | 1 | $4.95
2016-01-26 | 445 M140 Module | Laser module #2 | DTR's Laser Shop | $72.00 | 1 | $72.00 | $0.00
2016-01-26 | 381531274978 | LASORB | eBay.com | $11.00 | 1 | $11.00 | $2.50
2016-01-31 | S1933X - 3 | Safety Eyewear (3 Pack) | Amazon.com | $26.99 | 1 | $26.99 | $0.00
2016-02-07 | DC5-24V | 600P/R Rotary Encoder | Amazon.com | $17.45 | 2 | $34.90 | $0.00
2016-02-16 | Wood | Wood for Testing | Home Depot | $19.63 | 1 | $19.63 | $0.00
2016-03-05 | 1185 | Mini V Gantry Set | OpenBuilds.org | $28.95 | 3 | $86.85 | $24.68
 | 470 | GT2 Timing Belt |  | $2.50 | 14 | $35.00
 | 200 | GT2 30-Tooth Pulley |  | $6.95 | 5 | $34.75
 | 230-LP | V-Slot Linear Rail (1500 mm) |  | $16.50 | 2 | $33.00
 | 570 | Idler pulley Plate |  | $6.95 | 4 | $27.80
 | 575 | Motor mount Plate |  | $6.95 | 2 | $13.90
 | 170-LP | V-Slot Linear Rail (1000 mm) |  | $11.00 | 1 | $11.00
 | 60 | Double Tee Nut |  | $0.85 | 10 | $8.50
 | 545 | L Bracket |  | $1.00 | 8 | $8.00
 | 550 | Smooth Idler Pulley |  | $5.45 | 1 | $5.45
 | 115 | Low Profile M5 Screws |  | $0.15 | 36 | $5.40
 | 50 | Tee Nuts (25 Pack) |  | $4.95 | 1 | $4.95
 | 730 | Belt Clamp |  | $0.60 | 6 | $3.60
 | 30 | Ball Bearing |  | $1.00 | 1 | $1.00
2016-03-07 | O1 rod | 36", 5mm Rod | Amazon.com | $10.78 | 1 | $10.78 | $0.00
 | Coupler | 5x5mm Coupler |  | $5.09 | 1 | $5.09
2016-03-14 | RibbonCable | 10 Wire, 15ft Ribbon Cable | Amazon.com | $10.95 | 1 | $10.95 | $0.00
2016-03-29 | Amber Plexi | 12" x 12" x 0.118" Amber PG | Amazon.com | $5.25 | 1 | $5.25 | $7.48
2016-03-29 | Wood and spacers | Wood for Enclosure and spacers | Home Depot | $18.20 | 1 | $18.20 | $0.00
2016-03-29 | Enclosure | Enclosure Materials | Lowes | $10.06 | 1 | $10.06 | $0.00
2016-04-04 | Fasteners | Fasteners/washers/bolts | Fastenal | $10.67 | 1 | $10.67 | $0.00
2016-04-06 | Spacers | Washers and spacers | Home Depot | $7.35 | 1 | $7.35 | $0.00
2016-04-08 | Box Materials | ZipTies, nails, dowell, rings | Home Depot | $6.90 | 1 | $6.90 | $0.00
2016-04-09 | Wood/Ties | Test wood and cable ties | Home Depot | $7.46 | 1 | $7.46 | $0.00
2016-04-22 | Wood | Wood for Testing | Home Depot | $21.66 | 1 | $21.66 | $0.00
2016-05-02 | Flexmod P3 | Backup Laser Driver | Innolasers | $35.99 | 1 | $35.99 | $35.30
2016-05-03 | Transistor | Transistor laser driver | ECE Store | $4.64 | 1 | $4.64 | $0.00
2016-05-03 | Poster Print | Card Stock Fee | ENGR Computer Lab | $17.94 | 1 | $17.94 | $0.00
 | Poster Print | Final Poster Print |  | $2.03 | 1 | $2.03
2016-05-04 | Frame mat | Frame mat for poster | Michael's | $17.06 | 1 | $17.06 | $0.00
Total |  |  |  |  |  |  | $936.63
