JNCox55/PLED/Mechanical/PLED_TEAM-4-28/PLED_TEAM-4-28/PLED_FINAL_MECHANICAL_FILES/SolidWorks_OpenBuilds2/Assemblies/Wheels/Delrin Mini V Wheel.SLDASM

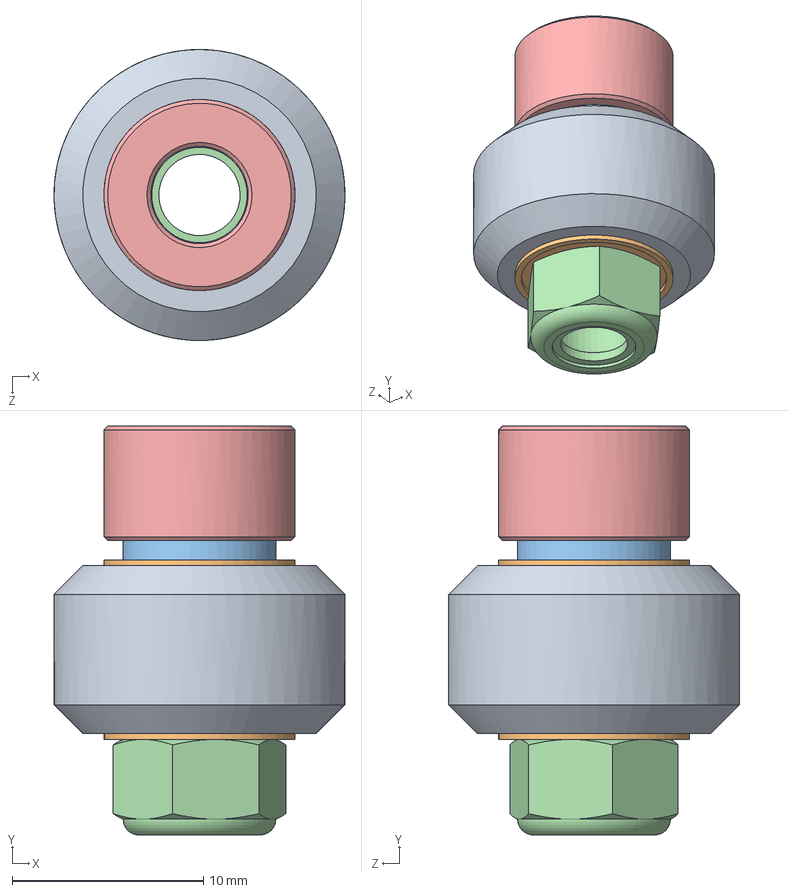
[picture p110: CAD file, 2016-05-03]
Mechanical/PLED_TEAM-4-28/PLED_TEAM-4-28/PLED_FINAL_MECHANICAL_FILES/SolidWorks_OpenBuilds2/Assemblies/Wheels/Delrin Mini V Wheel.SLDASM
15.2 x 21.4 x 15.2 mm
Delrin Mini V Wheel
Ball Bearing 5 x 10 x 4.2 x 2
Precision Shim 8 x 5 x 1 x 2
Nylon Insert Lock Nut M5
Aluminum Spacer 6mm
