JNCox55/PLED/Mechanical/PLED_TEAM-4-28/PLED_TEAM-4-28/PLED_FINAL_MECHANICAL_FILES/SolidWorks_OpenBuilds2/Assemblies/V Slot Belt and Pinion Actuator/V Slot Belt and Pinion Actuator 500mm.SLDASM

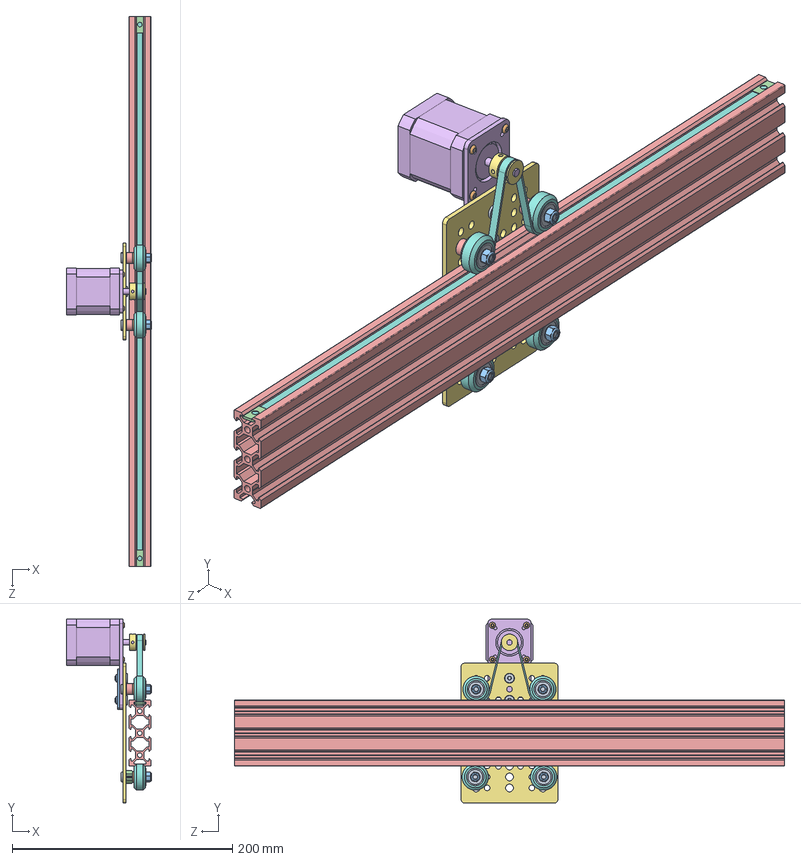
[picture p111: CAD file, 2016-03-03]
Mechanical/PLED_TEAM-4-28/PLED_TEAM-4-28/PLED_FINAL_MECHANICAL_FILES/SolidWorks_OpenBuilds2/Assemblies/V Slot Belt and Pinion Actuator/V Slot Belt and Pinion Actuator 500mm.SLDASM
77.0 x 167.2 x 500.0 mm
Low Profile Screw M5 x 6
Button Head Socket Cap Screw M3 x 4
Double Tee Nut
Tee Nut x 2
V-Slot 20x60x500 Linear Rail
Nema 17 Stepper Motor
V-Slot Gantry Plate 20-80mm
Solid V Wheel x 4
Ball Bearing 5 x 16 x 5 x 8
Precision Shim 10 x 5 x 1 x 8
Nylon Insert Lock Nut M5 x 4
Eccentric Spacer 6mm x 2
Aluminum Spacer 6mm x 2
Motor Mount Plate Nema 17
GT2 Timing Pulley 20 Tooth
GT2 Belt 585mm
