JNCox55/PLED/Mechanical/PLED_TEAM-4-28/PLED_TEAM-4-28/PLED_FINAL_MECHANICAL_FILES/SolidWorks_OpenBuilds2/Assemblies/Wheels/Smooth Idler.SLDASM

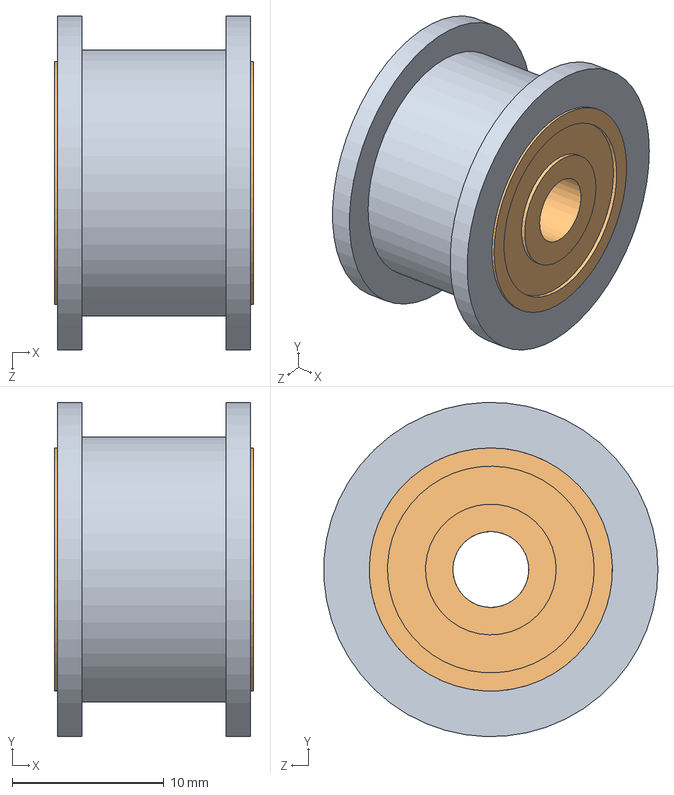
[picture p112: CAD file, 2016-03-03]
Mechanical/PLED_TEAM-4-28/PLED_TEAM-4-28/PLED_FINAL_MECHANICAL_FILES/SolidWorks_OpenBuilds2/Assemblies/Wheels/Smooth Idler.SLDASM
13.1 x 22.0 x 22.0 mm
Smooth Idler Pulley Wheel
Ball Bearing 5 x 16 x 5 x 2
Nylon Spacer 0.125in
