JNCox55/PLED/Mechanical/PLED_TEAM-4-28/PLED_TEAM-4-28/PLED_FINAL_MECHANICAL_FILES/PLED_TEAM_GANTRY_MODEL/MOD_MINI_V_GANTRY.SLDASM

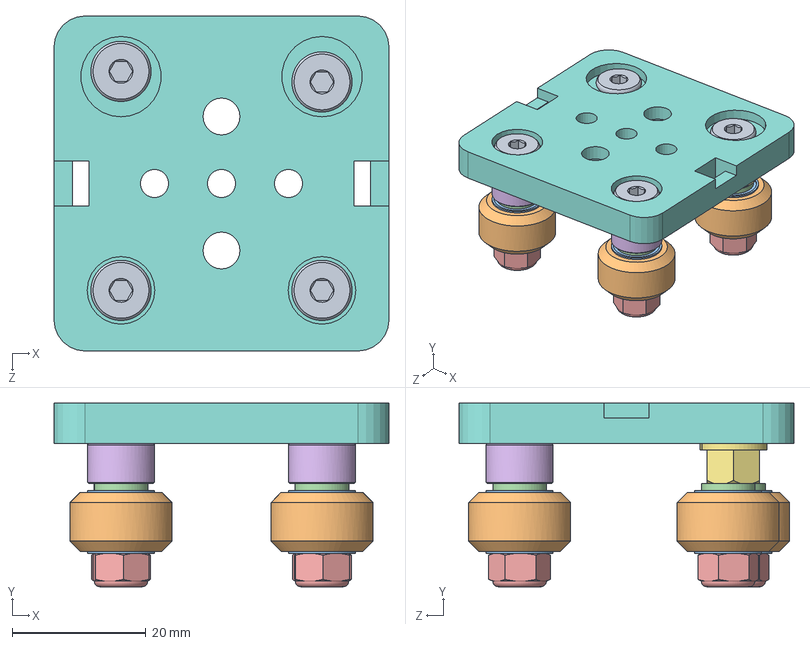
[picture p113: CAD file, 2016-05-03]
Mechanical/PLED_TEAM-4-28/PLED_TEAM-4-28/PLED_FINAL_MECHANICAL_FILES/PLED_TEAM_GANTRY_MODEL/MOD_MINI_V_GANTRY.SLDASM
50.0 x 27.4 x 50.0 mm
Low Profile Screw M5 x 4
Delrin Mini V Wheel x 4
Ball Bearing 5 x 10 x 4.2 x 8
Precision Shim 8 x 5 x 1 x 8
Nylon Insert Lock Nut M5 x 4
Aluminum Spacer 6mm x 2
Mini Eccentric Spacer 6mm x 2
MOD_MINI_V_PLATE
