JNCox55/PLED/Mechanical/PLED_TEAM-4-28/PLED_TEAM-4-28/PLED_FINAL_MECHANICAL_FILES/SolidWorks_OpenBuilds2/Assemblies/V Slot Belt and Pinion Actuator/Solid V Wheel assy.SLDASM

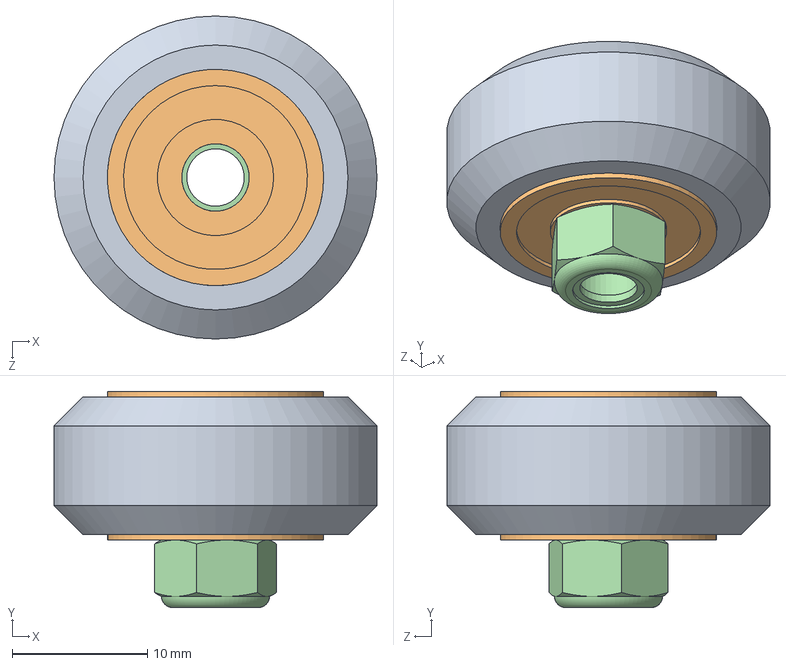
[picture p120: CAD file, 2016-03-03]
Mechanical/PLED_TEAM-4-28/PLED_TEAM-4-28/PLED_FINAL_MECHANICAL_FILES/SolidWorks_OpenBuilds2/Assemblies/V Slot Belt and Pinion Actuator/Solid V Wheel assy.SLDASM
23.9 x 16.0 x 23.9 mm
Solid V Wheel
Ball Bearing 5 x 16 x 5 x 2
Precision Shim 10 x 5 x 1
Nylon Insert Lock Nut M5
