JNCox55/PLED/Mechanical/PLED_TEAM-4-28/PLED_TEAM-4-28/PLED_FINAL_MECHANICAL_FILES/PLED_TEAM_GANTRY_MODEL/L_BRACKET_ASSEMBLY_REVERSE.SLDASM

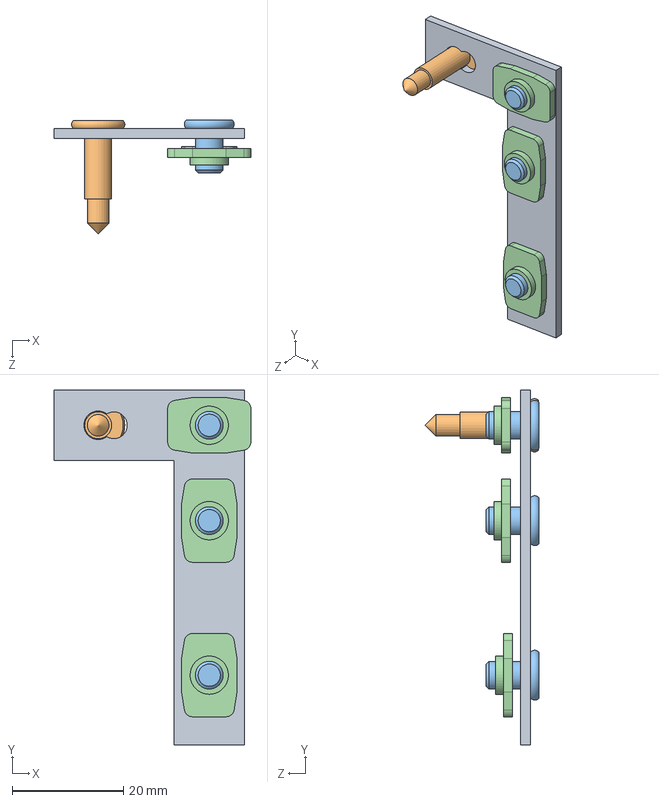
[picture p121: CAD file, 2016-05-03]
Mechanical/PLED_TEAM-4-28/PLED_TEAM-4-28/PLED_FINAL_MECHANICAL_FILES/PLED_TEAM_GANTRY_MODEL/L_BRACKET_ASSEMBLY_REVERSE.SLDASM
35.4 x 63.9 x 20.5 mm
L_BRACKET
Self Tapping Screw
LP_SH_SCREW_M5_8mm x 3
Tee Nut x 3
