JNCox55/PLED/Mechanical/PLED_TEAM-4-28/PLED_TEAM-4-28/PLED_FINAL_MECHANICAL_FILES/PLED_TEAM_GANTRY_MODEL/MOTOR_MOUNT_2.SLDASM

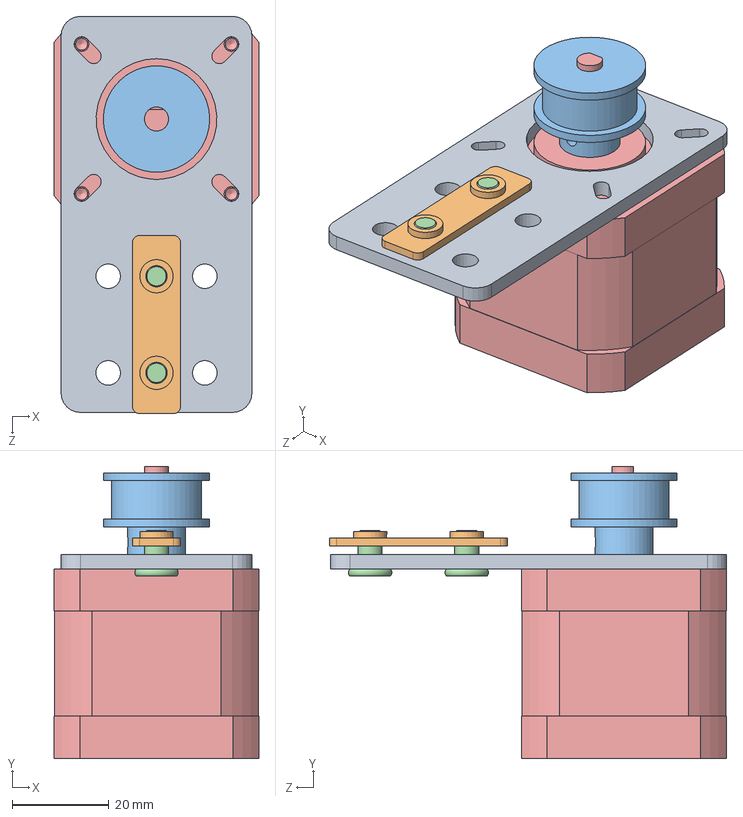
[picture p122: CAD file, 2016-05-03]
Mechanical/PLED_TEAM-4-28/PLED_TEAM-4-28/PLED_FINAL_MECHANICAL_FILES/PLED_TEAM_GANTRY_MODEL/MOTOR_MOUNT_2.SLDASM
42.4 x 60.4 x 82.2 mm
Motor Mount Plate Nema 17
Double Tee Nut
GT2 Timing Pulley 30 Tooth
LP_SH_SCREW_M5_8mm x 2
NEMA_17_MOTOR
