JNCox55/PLED/Mechanical/PLED_TEAM-4-28/PLED_TEAM-4-28/PLED_FINAL_MECHANICAL_FILES/PLED_TEAM_GANTRY_MODEL/ENCODER_MOUNT.SLDASM

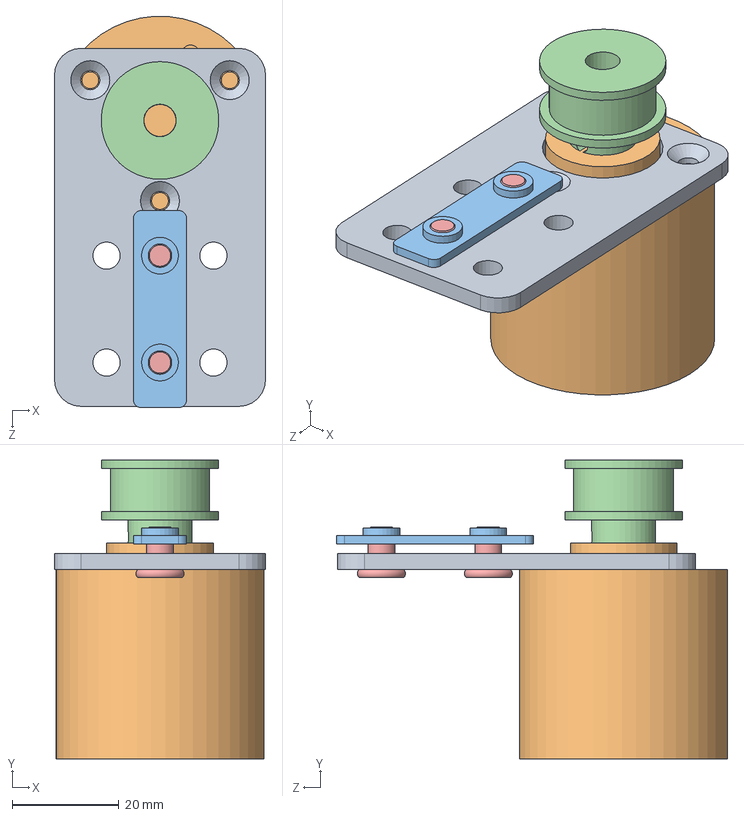
[picture p124: CAD file, 2016-05-03]
Mechanical/PLED_TEAM-4-28/PLED_TEAM-4-28/PLED_FINAL_MECHANICAL_FILES/PLED_TEAM_GANTRY_MODEL/ENCODER_MOUNT.SLDASM
39.5 x 55.9 x 73.2 mm
Encoder_Plate
ENCODER
Double Tee Nut
PULLEY_6MM
LP_SH_SCREW_M5_8mm x 2
