JNCox55/PLED/Mechanical/PLED_TEAM-4-28/PLED_TEAM-4-28/PLED_FINAL_MECHANICAL_FILES/PLED_TEAM_GANTRY_MODEL/PLED_TEAM_GANTRY.SLDASM

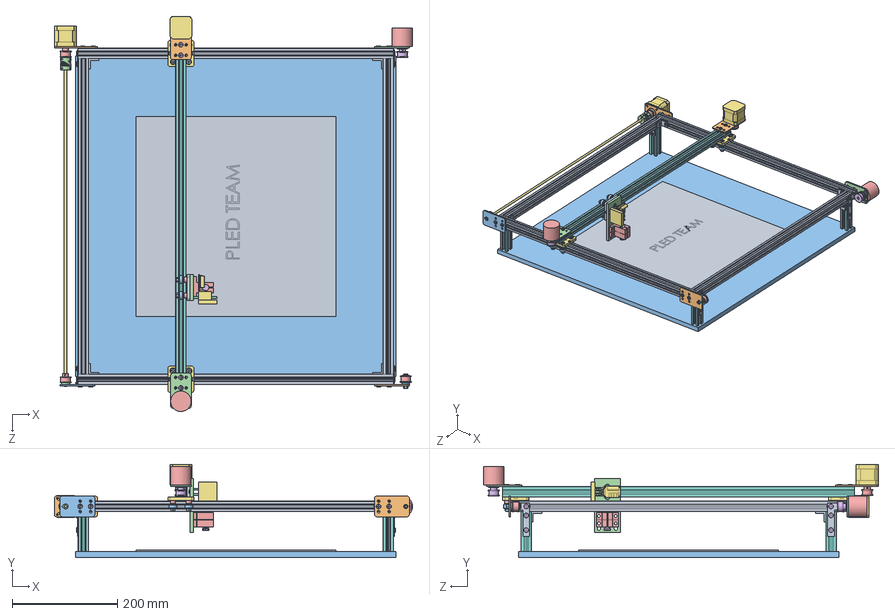
[picture p125: CAD file, 2016-05-03]
Mechanical/PLED_TEAM-4-28/PLED_TEAM-4-28/PLED_FINAL_MECHANICAL_FILES/PLED_TEAM_GANTRY_MODEL/PLED_TEAM_GANTRY.SLDASM
681.7 x 177.3 x 751.7 mm
V-SLOT_600 x 4
MOD_NEMA_17_MOUNT_PLATE
Double Tee Nut x 8
Flexible Coupling 5mm x 6mm
GT2 Timing Pulley 30 Tooth x 3
LP_SH_SCREW_M5_8mm x 24
NEMA_17_MOTOR x 2
V-SLOT_670
PRINT_AREA
Idler Pulley Plate
Slot Washer 15 x 5 x 2 x 2
Ball Bearing 5 x 16 x 5 x 3
Smooth Idler Pulley Wheel
Nylon Spacer 0.125in
Precision Shim 8 x 5 x 1 x 25
Nylon Insert Lock Nut M5 x 13
Low Profile Screw M5 x 13
Motor Mount Plate Nema 17
BEARING_PLATE
Encoder_Plate x 2
ENCODER x 2
PULLEY_6MM x 2
SHAFT_5mm
V-SLOT_LEGS x 4
L Bracket Single x 8
Tee Nut x 28
Delrin Mini V Wheel x 12
Ball Bearing 5 x 10 x 4.2 x 24
Aluminum Spacer 6mm x 6
Mini Eccentric Spacer 6mm x 6
MOD_MINI_V_PLATE x 2
LP_SH_SCREW_M5_10mm x 8
L_BRACKET x 4
Self Tapping Screw x 4
BASE
LASER_PLATE
LASER_MOUNT x 2
FREAKIN_LASER
LASER_DRIVER_APPROXIMATE_MODEL
6-32_2IN_FH_SCREW x 2
Mini V Wheel Plate
