JNCox55/PLED/Mechanical/PLED_TEAM-4-28/PLED_TEAM-4-28/PLED_FINAL_MECHANICAL_FILES/PLED_TEAM_GANTRY_MODEL/CORNER_BRACKETS.SLDASM

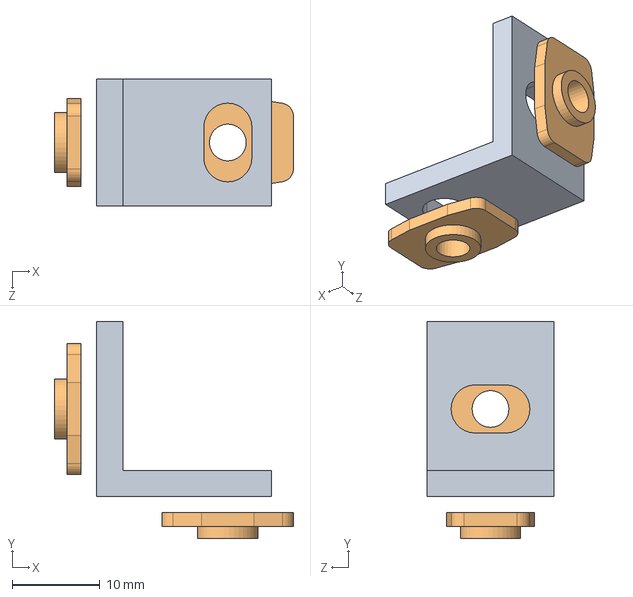
[picture p126: CAD file, 2016-05-03]
Mechanical/PLED_TEAM-4-28/PLED_TEAM-4-28/PLED_FINAL_MECHANICAL_FILES/PLED_TEAM_GANTRY_MODEL/CORNER_BRACKETS.SLDASM
27.3 x 24.8 x 14.5 mm
L Bracket Single
Tee Nut x 2
