JNCox55/PLED/Mechanical/PLED_TEAM-4-28/PLED_TEAM-4-28/PLED_FINAL_MECHANICAL_FILES/PLED_TEAM_GANTRY_MODEL/MOTOR_MOUNT.SLDASM

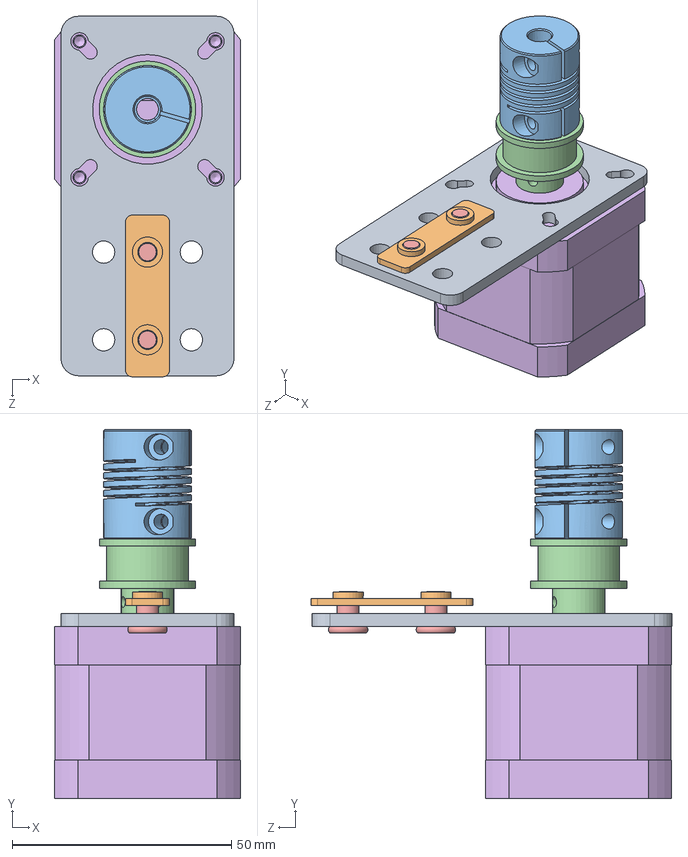
[picture p127: CAD file, 2016-05-03]
Mechanical/PLED_TEAM-4-28/PLED_TEAM-4-28/PLED_FINAL_MECHANICAL_FILES/PLED_TEAM_GANTRY_MODEL/MOTOR_MOUNT.SLDASM
42.4 x 84.1 x 82.2 mm
MOD_NEMA_17_MOUNT_PLATE
Double Tee Nut
Flexible Coupling 5mm x 6mm
GT2 Timing Pulley 30 Tooth
LP_SH_SCREW_M5_8mm x 2
NEMA_17_MOTOR
