JNCox55/PLED/Mechanical/PLED_TEAM-4-28/PLED_TEAM-4-28/PLED_FINAL_MECHANICAL_FILES/PLED_TEAM_GANTRY_MODEL/FREE_IDLER_PULLEY.SLDASM

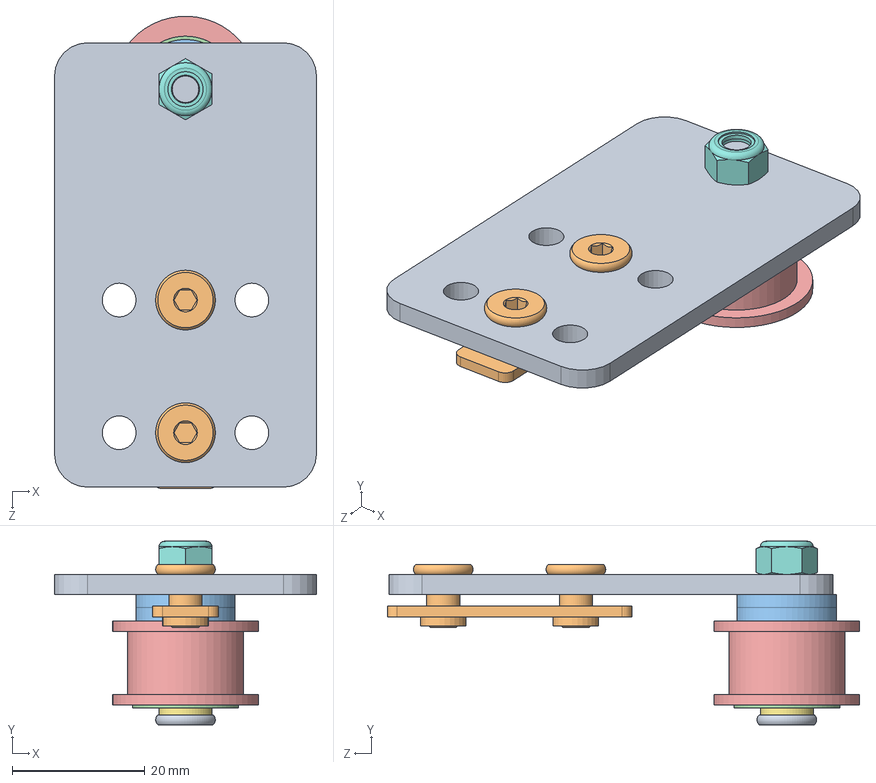
[picture p128: CAD file, 2016-05-03]
Mechanical/PLED_TEAM-4-28/PLED_TEAM-4-28/PLED_FINAL_MECHANICAL_FILES/PLED_TEAM_GANTRY_MODEL/FREE_IDLER_PULLEY.SLDASM
39.5 x 27.7 x 71.2 mm
Idler Pulley Plate
Double Tee Nut
Slot Washer 15 x 5 x 2 x 2
Ball Bearing 5 x 16 x 5 x 2
Smooth Idler Pulley Wheel
Nylon Spacer 0.125in
Precision Shim 8 x 5 x 1
Nylon Insert Lock Nut M5
Low Profile Screw M5
LP_SH_SCREW_M5_8mm x 2
