JNCox55/PLED/Mechanical/PLED_TEAM-4-28/PLED_TEAM-4-28/PLED_FINAL_MECHANICAL_FILES/PLED_TEAM_GANTRY_MODEL/FREAKIN_LASER_MOUNT.SLDASM

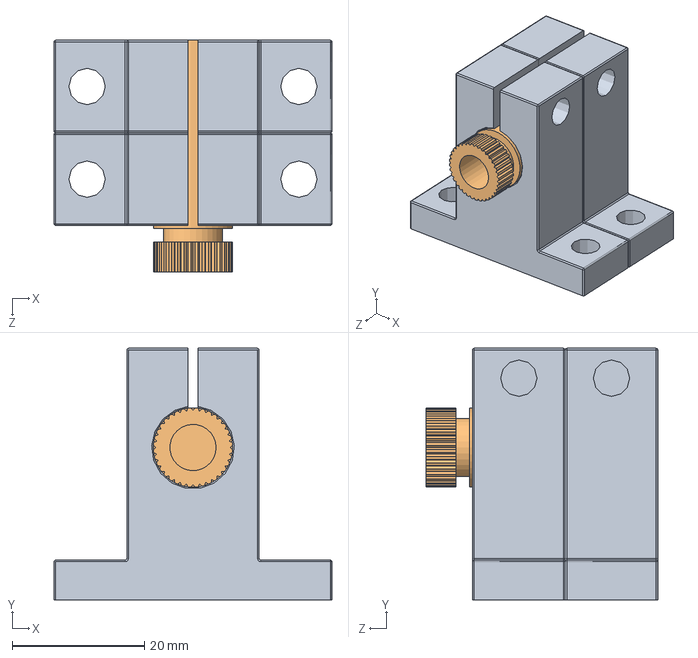
[picture p129: CAD file, 2016-05-03]
Mechanical/PLED_TEAM-4-28/PLED_TEAM-4-28/PLED_FINAL_MECHANICAL_FILES/PLED_TEAM_GANTRY_MODEL/FREAKIN_LASER_MOUNT.SLDASM
42.0 x 38.0 x 35.0 mm
LASER_MOUNT x 2
FREAKIN_LASER
