JNCox55/PLED/Mechanical/PLED_TEAM-4-28/PLED_TEAM-4-28/PLED_FINAL_MECHANICAL_FILES/PLED_TEAM_GANTRY_MODEL/BEARING_MOUNT.SLDASM

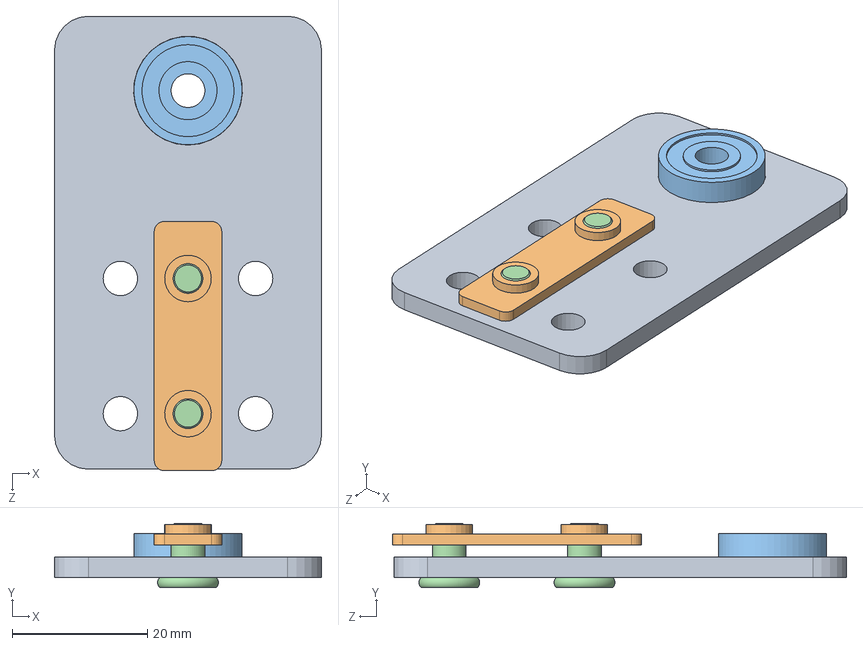
[picture p130: CAD file, 2016-05-03]
Mechanical/PLED_TEAM-4-28/PLED_TEAM-4-28/PLED_FINAL_MECHANICAL_FILES/PLED_TEAM_GANTRY_MODEL/BEARING_MOUNT.SLDASM
39.5 x 9.50 x 67.2 mm
BEARING_PLATE
Double Tee Nut
Ball Bearing 5 x 16 x 5
LP_SH_SCREW_M5_8mm x 2
