JNCox55/PLED/Mechanical/PLED_TEAM-4-28/PLED_TEAM-4-28/PLED_FINAL_MECHANICAL_FILES/PLED_TEAM_GANTRY_MODEL/LASER_ASSEMBLY.SLDASM

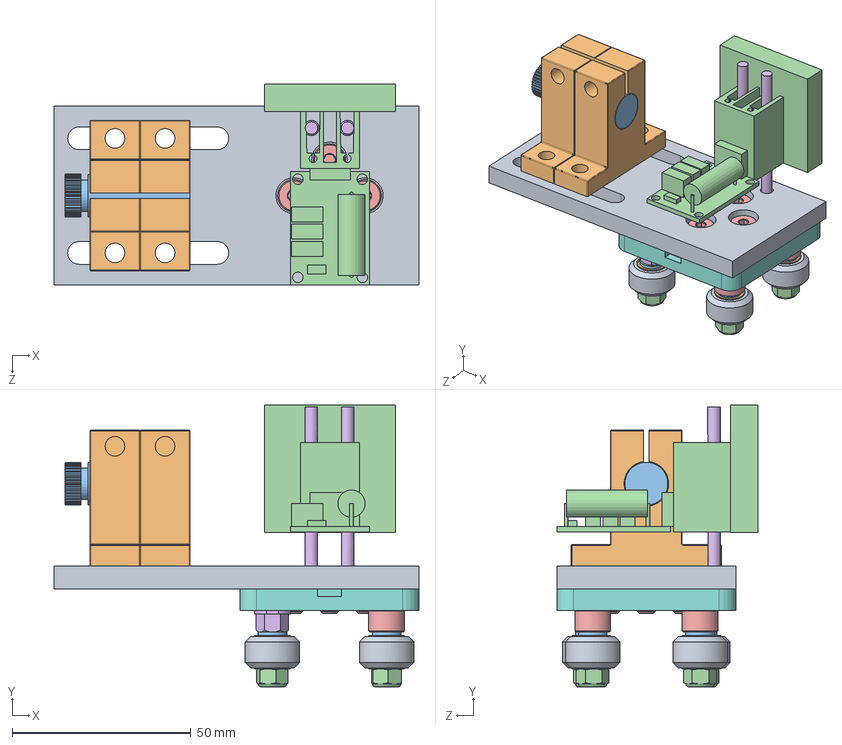
[picture p131: CAD file, 2016-05-03]
Mechanical/PLED_TEAM-4-28/PLED_TEAM-4-28/PLED_FINAL_MECHANICAL_FILES/PLED_TEAM_GANTRY_MODEL/LASER_ASSEMBLY.SLDASM
102.0 x 78.7 x 56.2 mm
LASER_PLATE
LASER_MOUNT x 2
FREAKIN_LASER
LASER_DRIVER_APPROXIMATE_MODEL
LP_SH_SCREW_M5_10mm x 4
6-32_2IN_FH_SCREW x 2
Low Profile Screw M5 x 4
Mini V Wheel Plate
Delrin Mini V Wheel x 4
Ball Bearing 5 x 10 x 4.2 x 8
Precision Shim 8 x 5 x 1 x 8
Nylon Insert Lock Nut M5 x 4
Aluminum Spacer 6mm x 2
Mini Eccentric Spacer 6mm x 2
