JNCox55/PLED/Mechanical/PLED_TEAM-4-28/PLED_TEAM-4-28/PLED_FINAL_MECHANICAL_FILES/MANUFACTURE/MANUFACTURED_PARTS_STEP_PARASOLIDS/V-SLOT_670.STEP

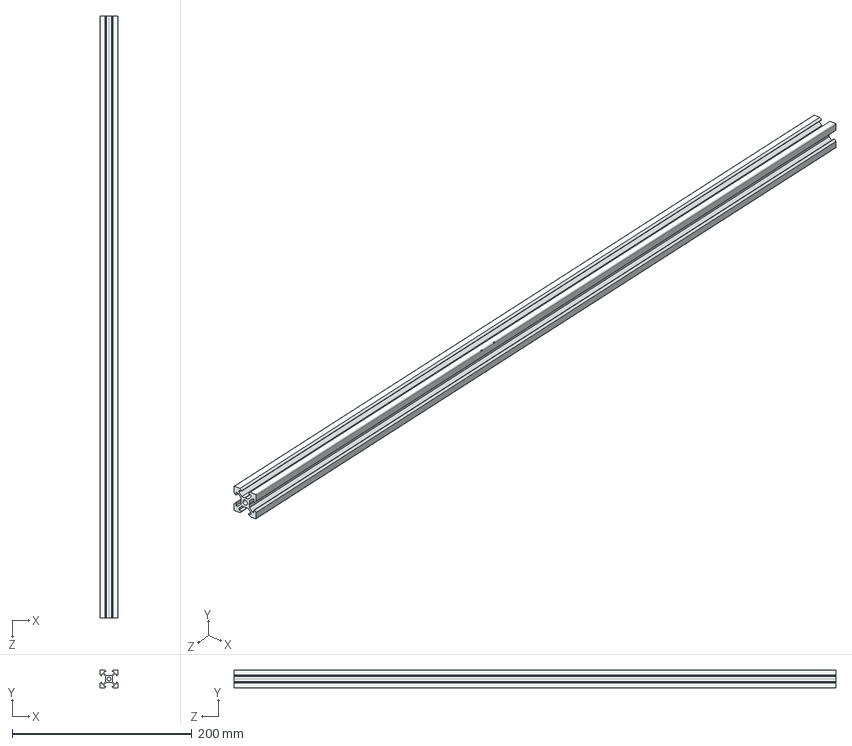
[picture p132: CAD file, 2016-05-03]
Mechanical/PLED_TEAM-4-28/PLED_TEAM-4-28/PLED_FINAL_MECHANICAL_FILES/MANUFACTURE/MANUFACTURED_PARTS_STEP_PARASOLIDS/V-SLOT_670.STEP
20.0 x 20.0 x 670.0 mm
