JNCox55/PLED/Mechanical/PLED_TEAM-4-28/PLED_TEAM-4-28/PLED_FINAL_MECHANICAL_FILES/SolidWorks_OpenBuilds2/1 - Linear Rail/V-Slot 20x80x1500 Linear Rail.SLDPRT

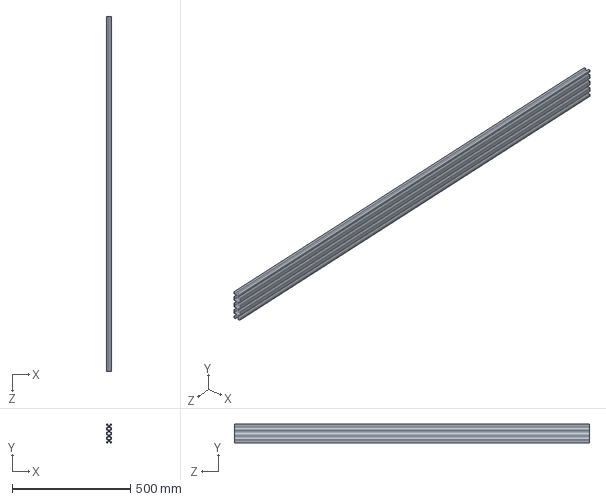
[picture p133: CAD file, 2016-03-03]
Mechanical/PLED_TEAM-4-28/PLED_TEAM-4-28/PLED_FINAL_MECHANICAL_FILES/SolidWorks_OpenBuilds2/1 - Linear Rail/V-Slot 20x80x1500 Linear Rail.SLDPRT
20.0 x 80.0 x 1500.0 mm
