JNCox55/PLED/Mechanical/PLED_TEAM-4-28/PLED_TEAM-4-28/PLED_FINAL_MECHANICAL_FILES/SolidWorks_OpenBuilds2/10 - Shims and Spacers/Aluminum Spacer 40mm.SLDPRT

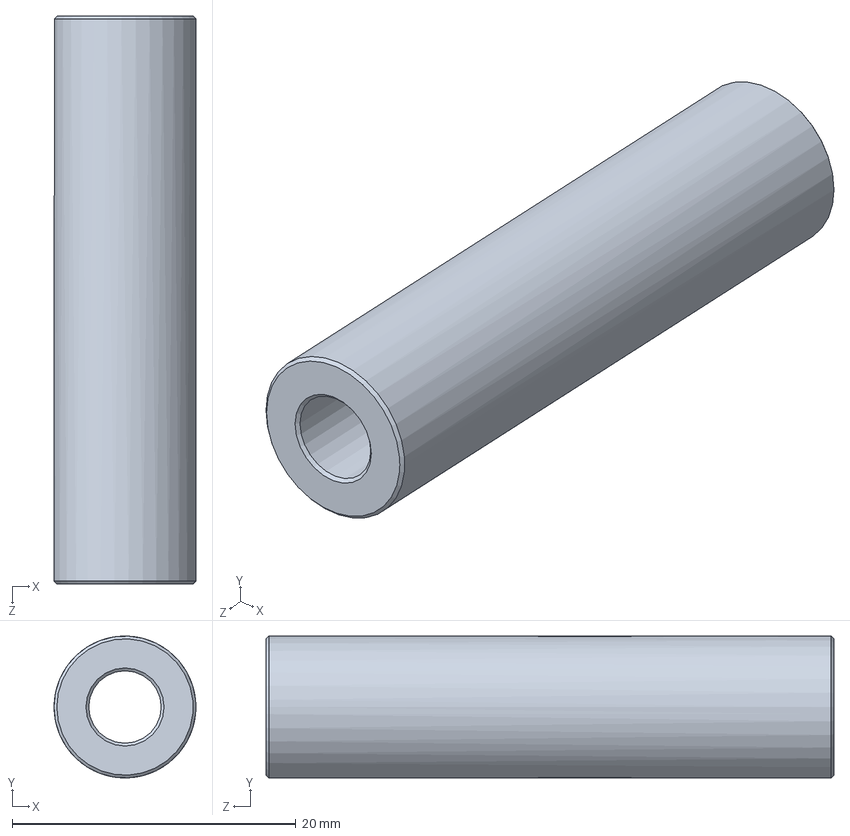
[picture p134: CAD file, 2016-03-03]
Mechanical/PLED_TEAM-4-28/PLED_TEAM-4-28/PLED_FINAL_MECHANICAL_FILES/SolidWorks_OpenBuilds2/10 - Shims and Spacers/Aluminum Spacer 40mm.SLDPRT
10.0 x 9.99 x 40.0 mm
