JNCox55/PLED/Mechanical/PLED_TEAM-4-28/PLED_TEAM-4-28/PLED_FINAL_MECHANICAL_FILES/SolidWorks_OpenBuilds2/3 - Bearings/Ball Bearing 0.25 x 0.625 x 0.196.SLDPRT

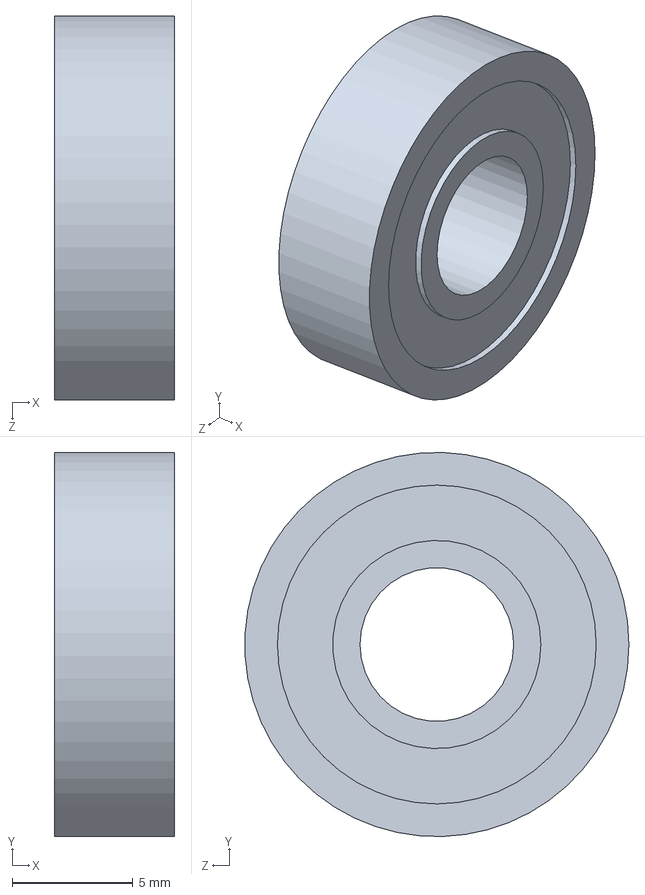
[picture p136: CAD file, 2016-03-03]
Mechanical/PLED_TEAM-4-28/PLED_TEAM-4-28/PLED_FINAL_MECHANICAL_FILES/SolidWorks_OpenBuilds2/3 - Bearings/Ball Bearing 0.25 x 0.625 x 0.196.SLDPRT
4.98 x 15.9 x 15.9 mm
