JNCox55/PLED/Mechanical/PLED_TEAM-4-28/PLED_TEAM-4-28/PLED_FINAL_MECHANICAL_FILES/SolidWorks_OpenBuilds2/4 - Pulleys/GT2 Timing Pulley 30 Tooth.SLDPRT

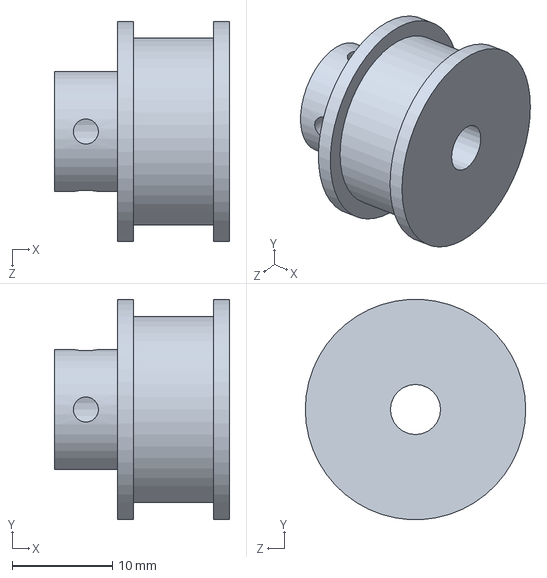
[picture p137: CAD file, 2016-03-03]
Mechanical/PLED_TEAM-4-28/PLED_TEAM-4-28/PLED_FINAL_MECHANICAL_FILES/SolidWorks_OpenBuilds2/4 - Pulleys/GT2 Timing Pulley 30 Tooth.SLDPRT
17.5 x 22.0 x 22.0 mm
