JNCox55/PLED/Mechanical/PLED_TEAM-4-28/PLED_TEAM-4-28/PLED_FINAL_MECHANICAL_FILES/SolidWorks_OpenBuilds2/5 - Brackets/L Bracket Single.SLDPRT

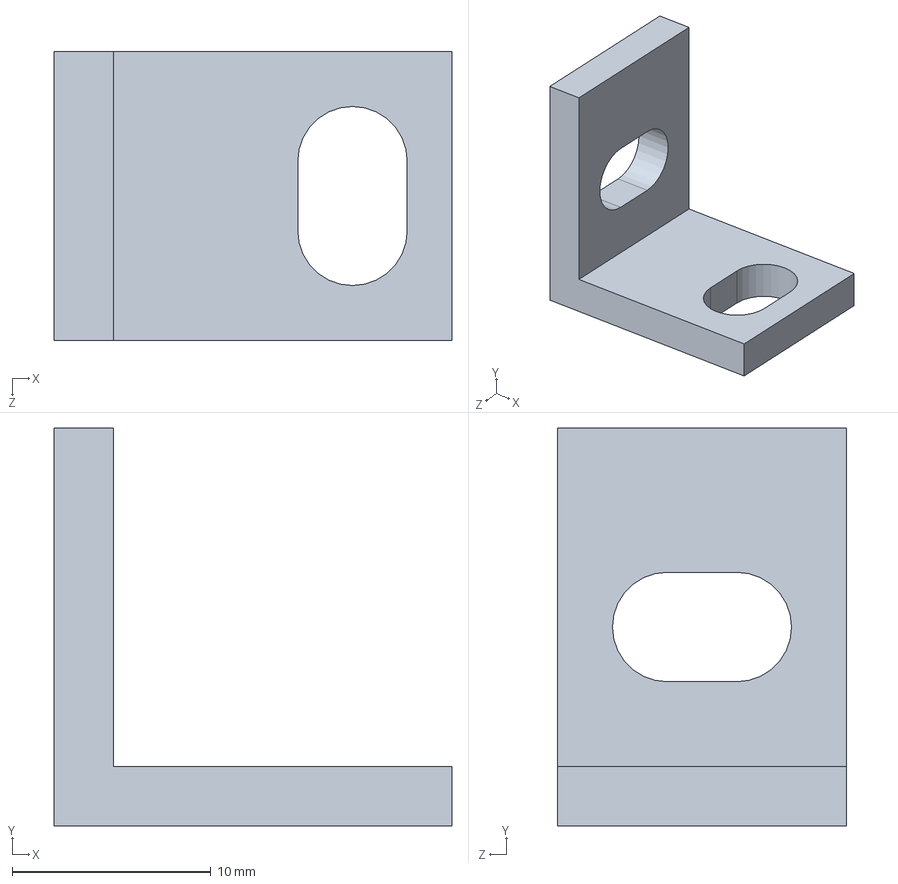
[picture p138: CAD file, 2016-05-03]
Mechanical/PLED_TEAM-4-28/PLED_TEAM-4-28/PLED_FINAL_MECHANICAL_FILES/SolidWorks_OpenBuilds2/5 - Brackets/L Bracket Single.SLDPRT
20.0 x 20.0 x 14.5 mm
