JNCox55/PLED/Mechanical/PLED_TEAM-4-28/PLED_TEAM-4-28/PLED_FINAL_MECHANICAL_FILES/SolidWorks_OpenBuilds2/6 - Electronics/Nema 23 Stepper Motor.SLDPRT

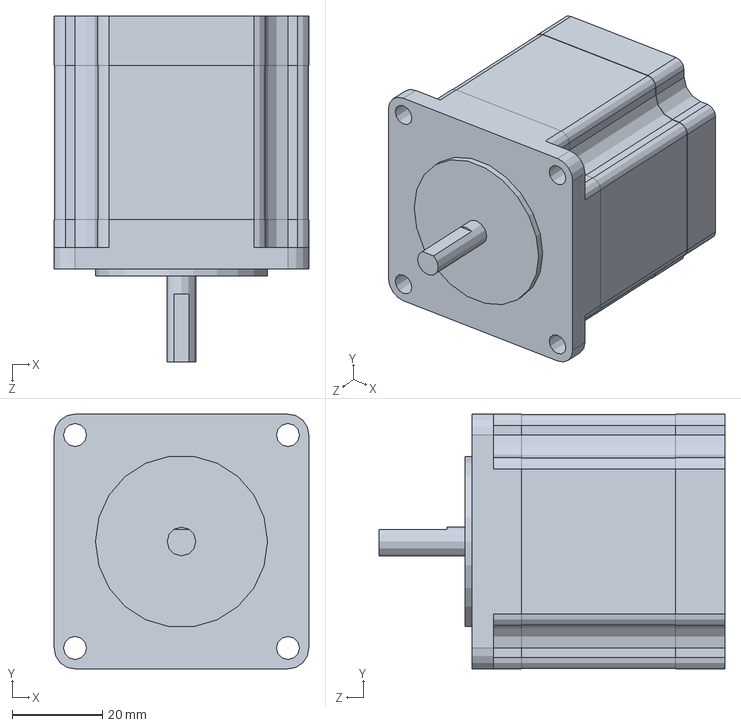
[picture p139: CAD file, 2016-03-03]
Mechanical/PLED_TEAM-4-28/PLED_TEAM-4-28/PLED_FINAL_MECHANICAL_FILES/SolidWorks_OpenBuilds2/6 - Electronics/Nema 23 Stepper Motor.SLDPRT
56.4 x 56.4 x 76.6 mm
