JNCox55/PLED/Mechanical/PLED_TEAM-4-28/PLED_TEAM-4-28/PLED_FINAL_MECHANICAL_FILES/SolidWorks_OpenBuilds2/8 - Plates/Open Rail Gantry Plate 40mm.SLDPRT

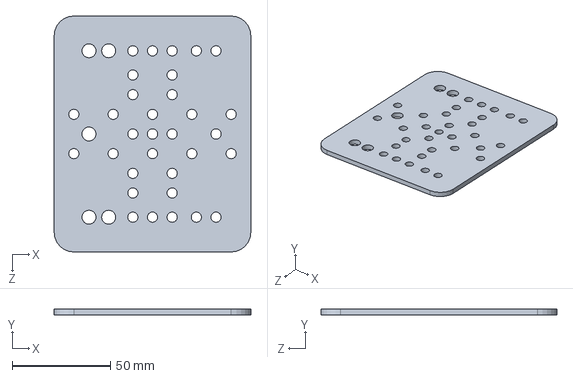
[picture p140: CAD file, 2016-03-03]
Mechanical/PLED_TEAM-4-28/PLED_TEAM-4-28/PLED_FINAL_MECHANICAL_FILES/SolidWorks_OpenBuilds2/8 - Plates/Open Rail Gantry Plate 40mm.SLDPRT
100.0 x 3.00 x 120.0 mm
