JNCox55/PLED/Mechanical/PLED_TEAM-4-28/PLED_TEAM-4-28/PLED_FINAL_MECHANICAL_FILES/SolidWorks_OpenBuilds2/Assemblies/V Slot Belt and Pinion Actuator/GT2 Belt 530mm.SLDPRT

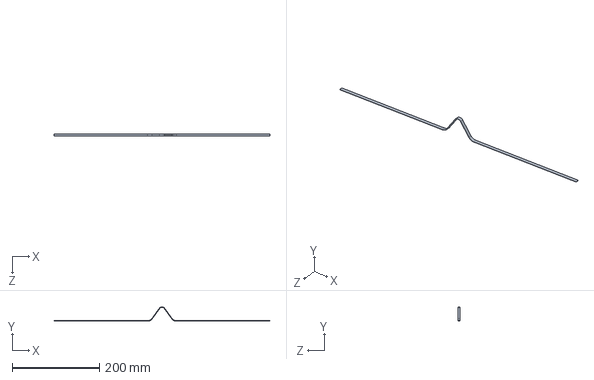
[picture p141: CAD file, 2016-03-03]
Mechanical/PLED_TEAM-4-28/PLED_TEAM-4-28/PLED_FINAL_MECHANICAL_FILES/SolidWorks_OpenBuilds2/Assemblies/V Slot Belt and Pinion Actuator/GT2 Belt 530mm.SLDPRT
496.0 x 33.2 x 5.00 mm
