JNCox55/PLED/Mechanical/PLED_TEAM-4-28/PLED_TEAM-4-28/PLED_FINAL_MECHANICAL_FILES/MANUFACTURE/MANUFACTURED_PARTS_STEP_PARASOLIDS/ENCODER.STEP

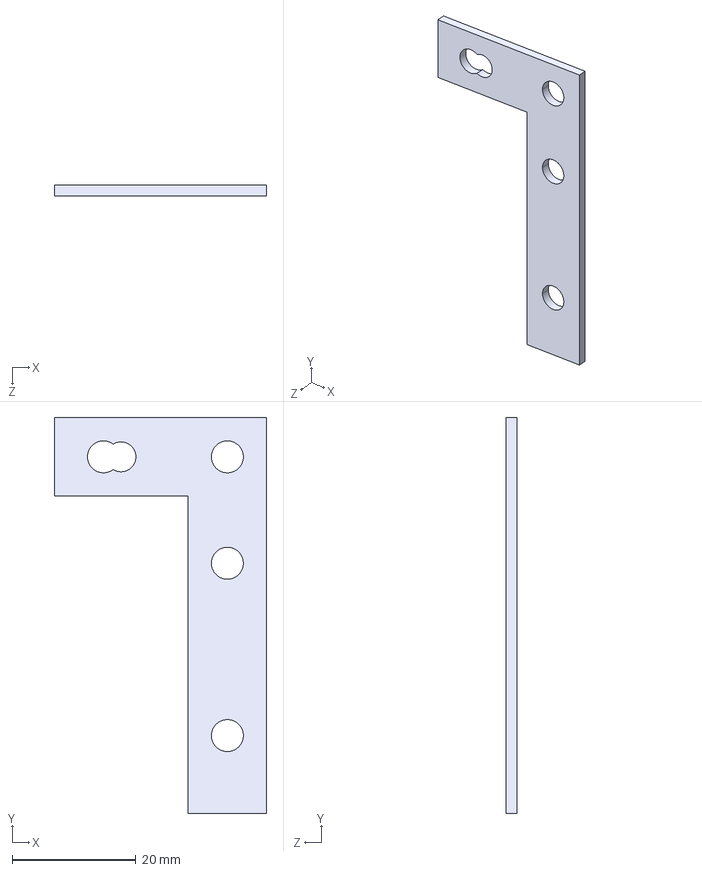
[picture p143: CAD file, 2016-05-03]
Mechanical/PLED_TEAM-4-28/PLED_TEAM-4-28/PLED_FINAL_MECHANICAL_FILES/MANUFACTURE/MANUFACTURED_PARTS_STEP_PARASOLIDS/ENCODER.STEP
34.3 x 63.9 x 1.80 mm
