JNCox55/PLED/Mechanical/PLED_TEAM-4-28/PLED_TEAM-4-28/PLED_FINAL_MECHANICAL_FILES/SolidWorks_OpenBuilds2/1 - Linear Rail/C-Beam 40x80x250 Linear Rail.SLDPRT

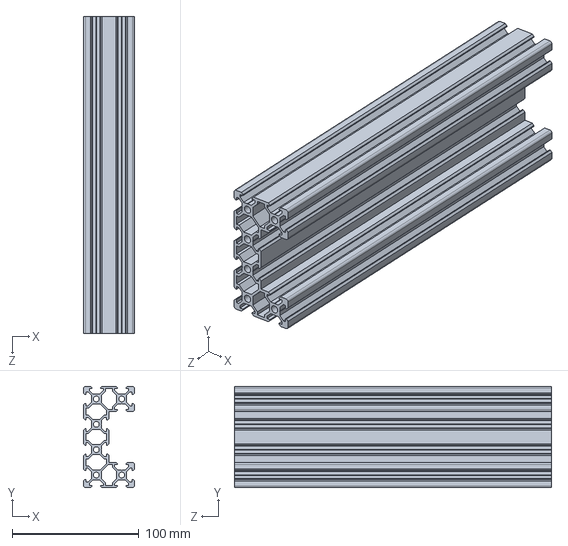
[picture p145: CAD file, 2016-03-03]
Mechanical/PLED_TEAM-4-28/PLED_TEAM-4-28/PLED_FINAL_MECHANICAL_FILES/SolidWorks_OpenBuilds2/1 - Linear Rail/C-Beam 40x80x250 Linear Rail.SLDPRT
40.0 x 80.0 x 250.0 mm
