JNCox55/PLED/Mechanical/PLED_TEAM-4-28/PLED_TEAM-4-28/PLED_FINAL_MECHANICAL_FILES/SolidWorks_OpenBuilds2/2 - Wheels/Xtreme Solid V Wheel.SLDPRT

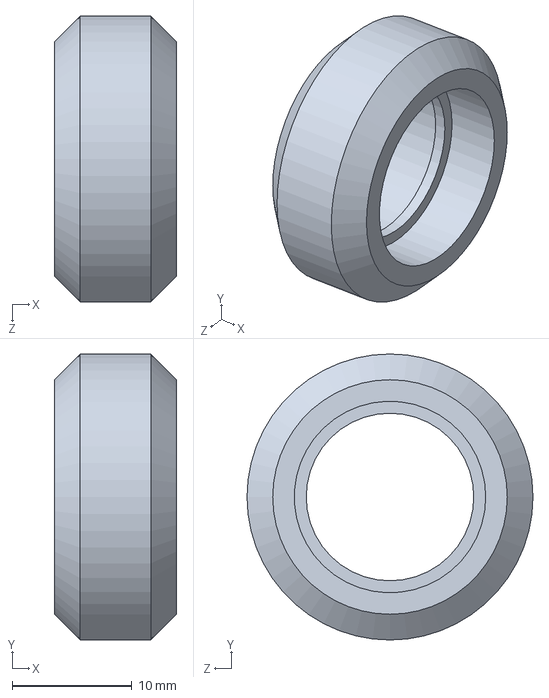
[picture p146: CAD file, 2016-03-03]
Mechanical/PLED_TEAM-4-28/PLED_TEAM-4-28/PLED_FINAL_MECHANICAL_FILES/SolidWorks_OpenBuilds2/2 - Wheels/Xtreme Solid V Wheel.SLDPRT
10.2 x 23.9 x 23.9 mm
