JNCox55/PLED/Mechanical/PLED_TEAM-4-28/PLED_TEAM-4-28/PLED_FINAL_MECHANICAL_FILES/SolidWorks_OpenBuilds2/3 - Bearings/Ball Bearing 5 x 16 x 5.SLDPRT

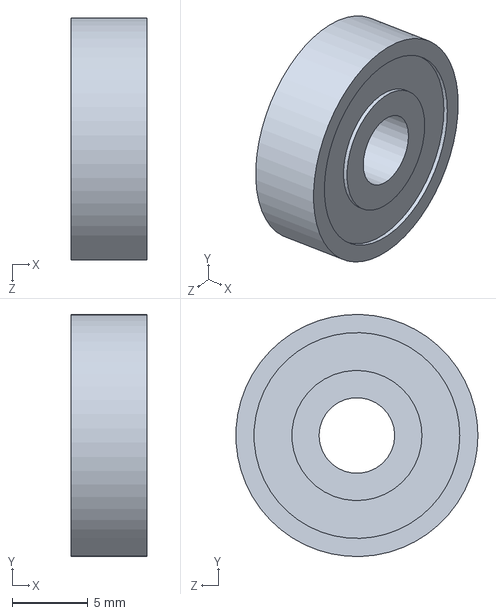
[picture p147: CAD file, 2016-03-03]
Mechanical/PLED_TEAM-4-28/PLED_TEAM-4-28/PLED_FINAL_MECHANICAL_FILES/SolidWorks_OpenBuilds2/3 - Bearings/Ball Bearing 5 x 16 x 5.SLDPRT
5.00 x 16.0 x 16.0 mm
