JNCox55/PLED/Mechanical/PLED_TEAM-4-28/PLED_TEAM-4-28/PLED_FINAL_MECHANICAL_FILES/SolidWorks_OpenBuilds2/4 - Pulleys/GT3 Timing Pulley 20 Tooth.SLDPRT

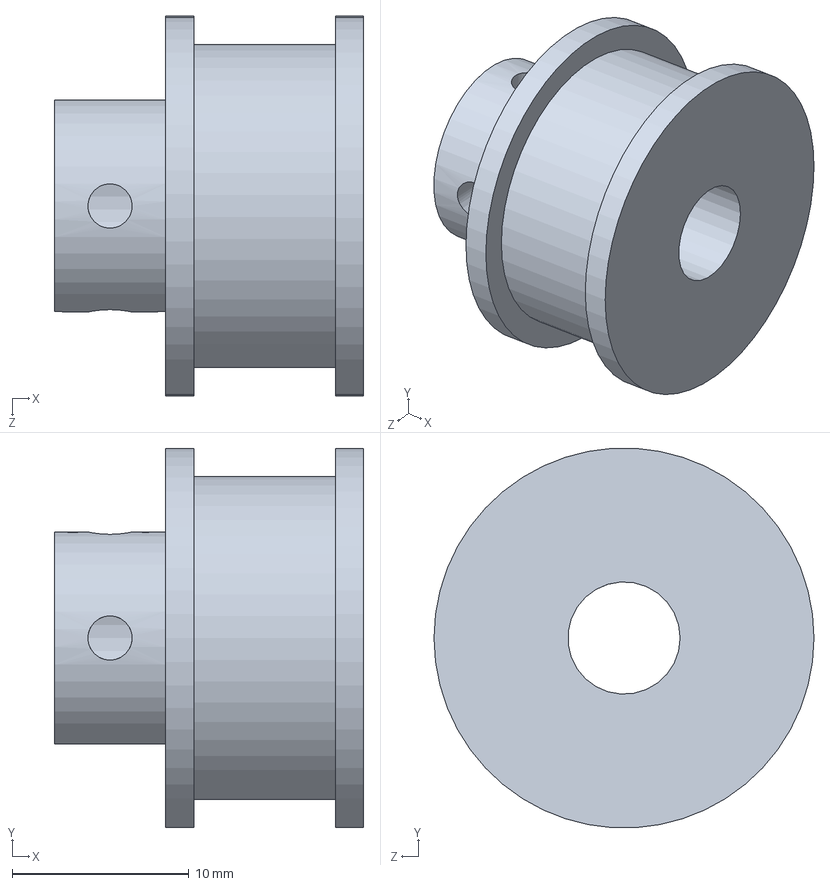
[picture p148: CAD file, 2016-03-03]
Mechanical/PLED_TEAM-4-28/PLED_TEAM-4-28/PLED_FINAL_MECHANICAL_FILES/SolidWorks_OpenBuilds2/4 - Pulleys/GT3 Timing Pulley 20 Tooth.SLDPRT
17.5 x 21.5 x 21.5 mm
