JNCox55/PLED/Mechanical/PLED_TEAM-4-28/PLED_TEAM-4-28/PLED_FINAL_MECHANICAL_FILES/SolidWorks_OpenBuilds2/5 - Brackets/V-Slot Door Handle.SLDPRT

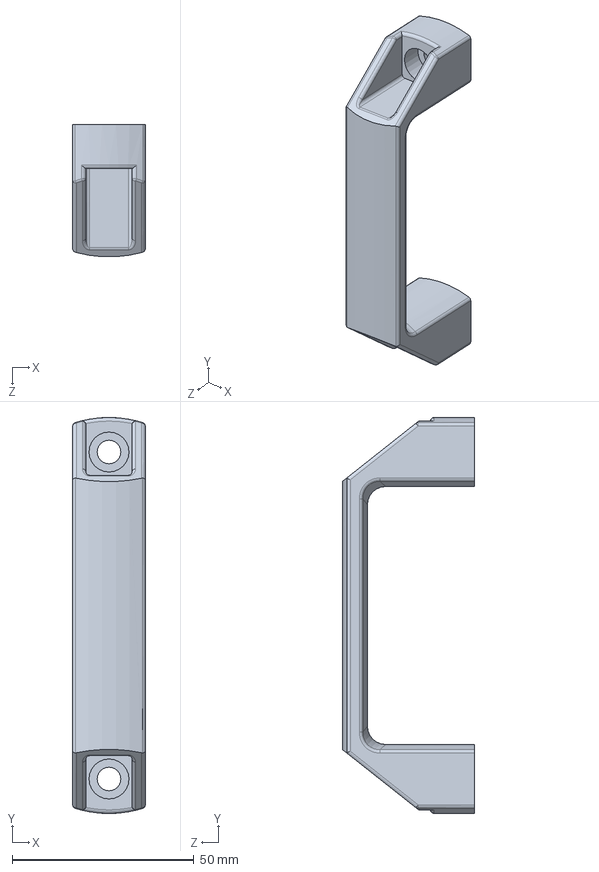
[picture p149: CAD file, 2016-03-03]
Mechanical/PLED_TEAM-4-28/PLED_TEAM-4-28/PLED_FINAL_MECHANICAL_FILES/SolidWorks_OpenBuilds2/5 - Brackets/V-Slot Door Handle.SLDPRT
20.0 x 109.0 x 36.4 mm
