JNCox55/PLED/Mechanical/PLED_TEAM-4-28/PLED_TEAM-4-28/PLED_FINAL_MECHANICAL_FILES/SolidWorks_OpenBuilds2/6 - Electronics/Nema 17 Stepper Motor.SLDPRT

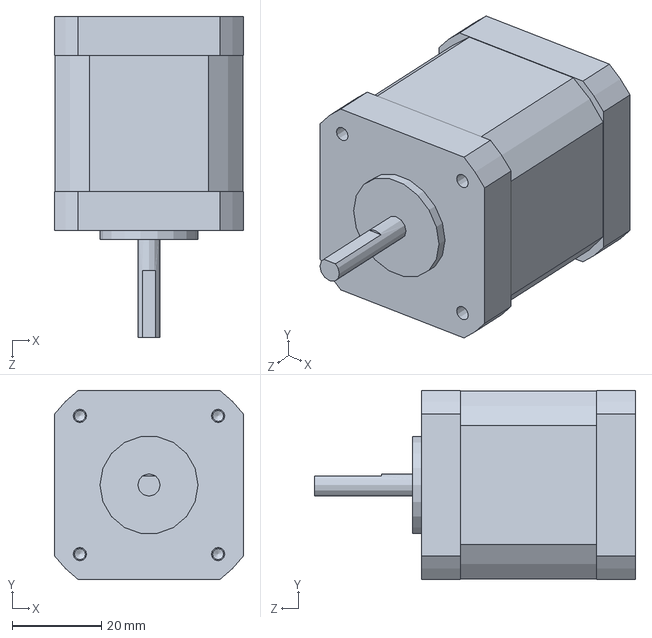
[picture p150: CAD file, 2016-03-03]
Mechanical/PLED_TEAM-4-28/PLED_TEAM-4-28/PLED_FINAL_MECHANICAL_FILES/SolidWorks_OpenBuilds2/6 - Electronics/Nema 17 Stepper Motor.SLDPRT
42.4 x 42.4 x 72.0 mm
