JNCox55/PLED/Mechanical/PLED_TEAM-4-28/PLED_TEAM-4-28/PLED_FINAL_MECHANICAL_FILES/SolidWorks_OpenBuilds2/7 - Hardware/Lock Collar 8mm.SLDPRT

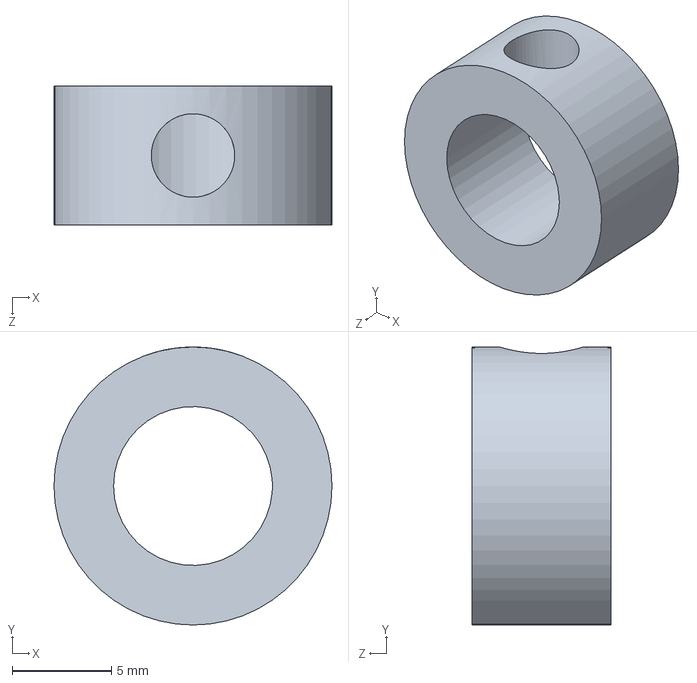
[picture p151: CAD file, 2016-03-03]
Mechanical/PLED_TEAM-4-28/PLED_TEAM-4-28/PLED_FINAL_MECHANICAL_FILES/SolidWorks_OpenBuilds2/7 - Hardware/Lock Collar 8mm.SLDPRT
14.0 x 14.0 x 7.00 mm
