JNCox55/PLED/Mechanical/PLED_TEAM-4-28/PLED_TEAM-4-28/PLED_FINAL_MECHANICAL_FILES/SolidWorks_OpenBuilds2/8 - Plates/C-Beam End Mount.SLDPRT

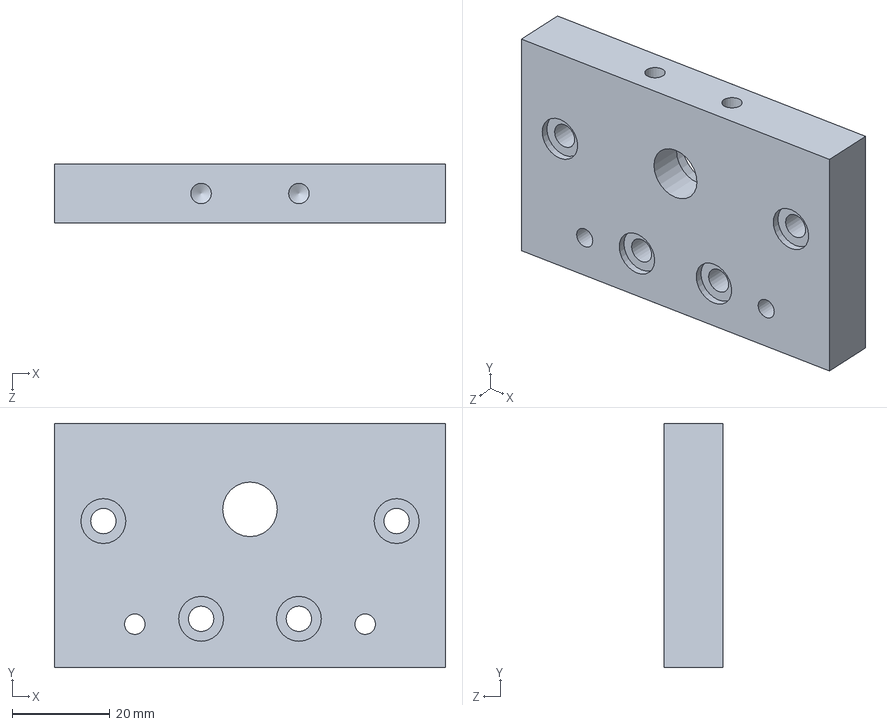
[picture p152: CAD file, 2016-03-03]
Mechanical/PLED_TEAM-4-28/PLED_TEAM-4-28/PLED_FINAL_MECHANICAL_FILES/SolidWorks_OpenBuilds2/8 - Plates/C-Beam End Mount.SLDPRT
80.0 x 50.0 x 12.0 mm
