JNCox55/PLED/Mechanical/PLED_TEAM-4-28/PLED_TEAM-4-28/PLED_FINAL_MECHANICAL_FILES/SolidWorks_OpenBuilds2/Assemblies/Mini V Linear Actuator/GT2 Belt 1140mm.SLDPRT

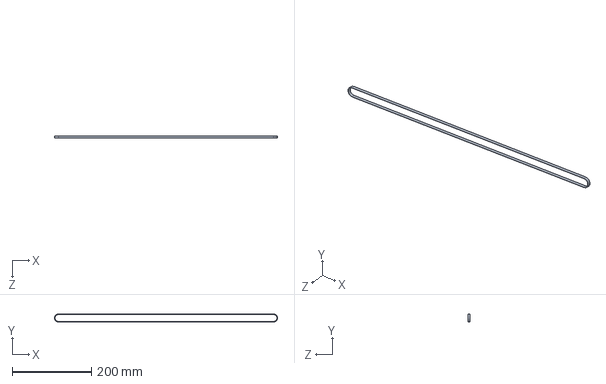
[picture p153: CAD file, 2016-03-03]
Mechanical/PLED_TEAM-4-28/PLED_TEAM-4-28/PLED_FINAL_MECHANICAL_FILES/SolidWorks_OpenBuilds2/Assemblies/Mini V Linear Actuator/GT2 Belt 1140mm.SLDPRT
561.3 x 20.3 x 5.00 mm
