JNCox55/PLED/Mechanical/PLED_TEAM-4-28/PLED_TEAM-4-28/PLED_FINAL_MECHANICAL_FILES/SolidWorks_OpenBuilds2/3 - Bearings/Ball Bearing 5 x 10 x 4.2.SLDPRT

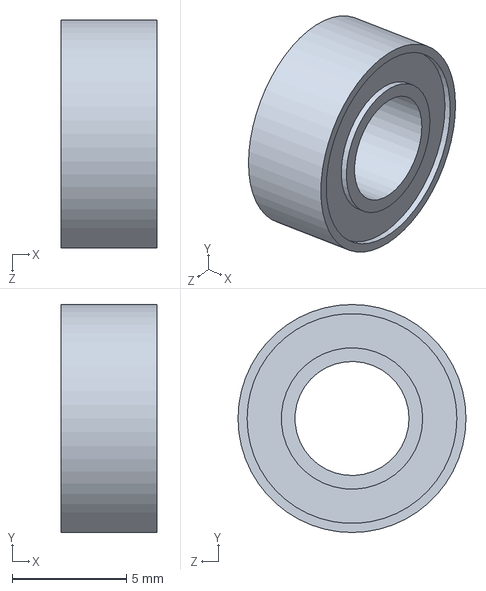
[picture p156: CAD file, 2016-03-03]
Mechanical/PLED_TEAM-4-28/PLED_TEAM-4-28/PLED_FINAL_MECHANICAL_FILES/SolidWorks_OpenBuilds2/3 - Bearings/Ball Bearing 5 x 10 x 4.2.SLDPRT
4.20 x 10.0 x 10.0 mm
