JNCox55/PLED/Mechanical/PLED_TEAM-4-28/PLED_TEAM-4-28/PLED_FINAL_MECHANICAL_FILES/SolidWorks_OpenBuilds2/4 - Pulleys/Smooth Idler Pulley Wheel.SLDPRT

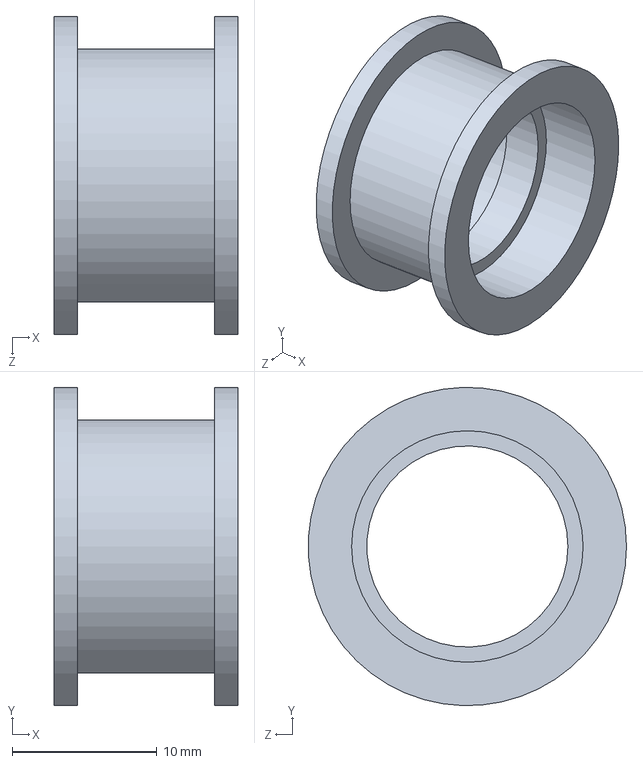
[picture p157: CAD file, 2016-03-03]
Mechanical/PLED_TEAM-4-28/PLED_TEAM-4-28/PLED_FINAL_MECHANICAL_FILES/SolidWorks_OpenBuilds2/4 - Pulleys/Smooth Idler Pulley Wheel.SLDPRT
12.7 x 22.0 x 22.0 mm
