JNCox55/PLED/Mechanical/PLED_TEAM-4-28/PLED_TEAM-4-28/PLED_FINAL_MECHANICAL_FILES/SolidWorks_OpenBuilds2/5 - Brackets/L Bracket Double.SLDPRT

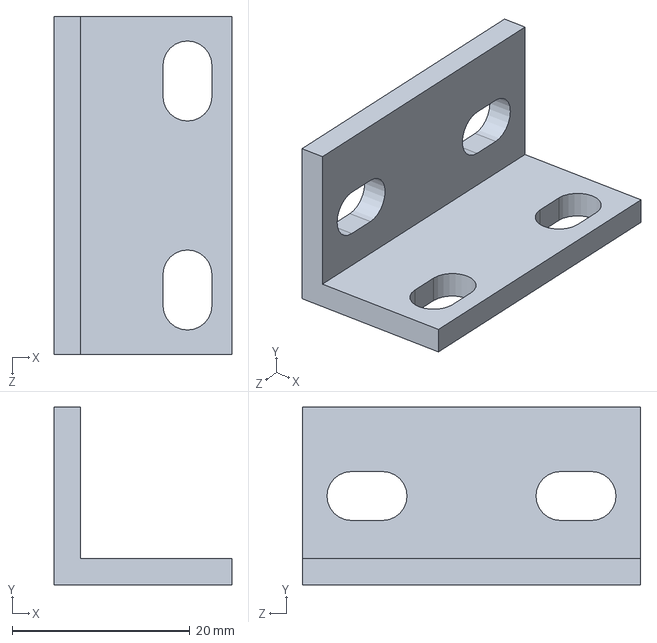
[picture p158: CAD file, 2016-03-03]
Mechanical/PLED_TEAM-4-28/PLED_TEAM-4-28/PLED_FINAL_MECHANICAL_FILES/SolidWorks_OpenBuilds2/5 - Brackets/L Bracket Double.SLDPRT
20.0 x 20.0 x 38.0 mm
