JNCox55/PLED/Mechanical/PLED_TEAM-4-28/PLED_TEAM-4-28/PLED_FINAL_MECHANICAL_FILES/SolidWorks_OpenBuilds2/6 - Electronics/Micro Limit Switch.SLDPRT

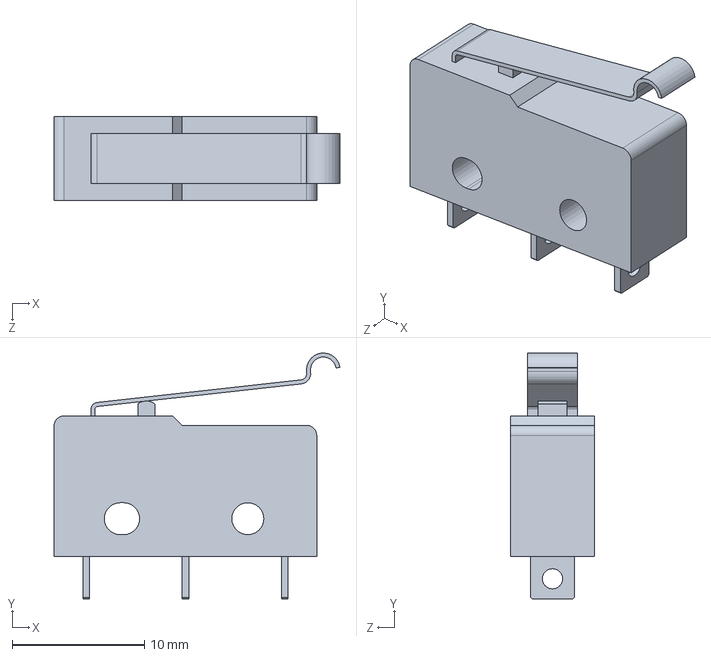
[picture p159: CAD file, 2016-03-03]
Mechanical/PLED_TEAM-4-28/PLED_TEAM-4-28/PLED_FINAL_MECHANICAL_FILES/SolidWorks_OpenBuilds2/6 - Electronics/Micro Limit Switch.SLDPRT
21.6 x 18.6 x 6.35 mm
