JNCox55/PLED/Mechanical/PLED_TEAM-4-28/PLED_TEAM-4-28/PLED_FINAL_MECHANICAL_FILES/SolidWorks_OpenBuilds2/8 - Plates/Open Rail Gantry Plate 20mm.SLDPRT

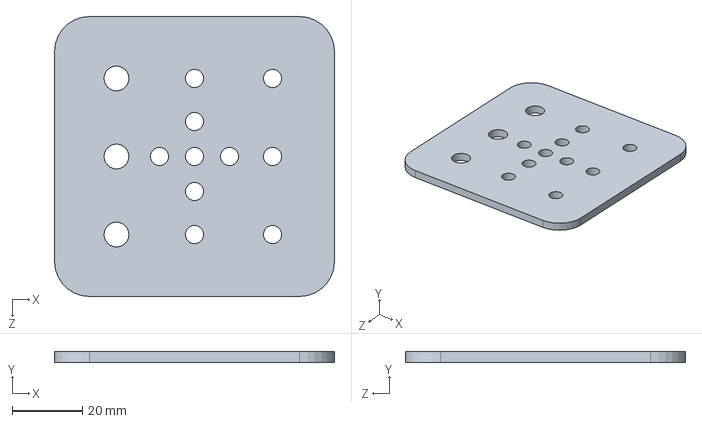
[picture p160: CAD file, 2016-03-03]
Mechanical/PLED_TEAM-4-28/PLED_TEAM-4-28/PLED_FINAL_MECHANICAL_FILES/SolidWorks_OpenBuilds2/8 - Plates/Open Rail Gantry Plate 20mm.SLDPRT
80.0 x 3.00 x 80.0 mm
