JNCox55/PLED/Mechanical/PLED_TEAM-4-28/PLED_TEAM-4-28/PLED_FINAL_MECHANICAL_FILES/SolidWorks_OpenBuilds2/Assemblies/V Slot Belt and Pinion Actuator/V-Slot 20x40x80 Linear Rail.SLDPRT

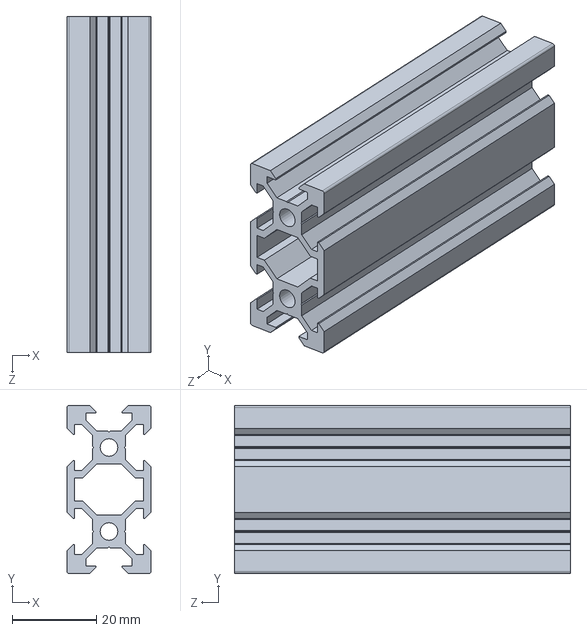
[picture p161: CAD file, 2016-03-03]
Mechanical/PLED_TEAM-4-28/PLED_TEAM-4-28/PLED_FINAL_MECHANICAL_FILES/SolidWorks_OpenBuilds2/Assemblies/V Slot Belt and Pinion Actuator/V-Slot 20x40x80 Linear Rail.SLDPRT
20.0 x 40.0 x 80.0 mm
