JNCox55/PLED/Mechanical/PLED_TEAM-4-28/PLED_TEAM-4-28/PLED_FINAL_MECHANICAL_FILES/MANUFACTURE/MANUFACTURED_PARTS_STEP_PARASOLIDS/V-SLOT_LEGS.STEP

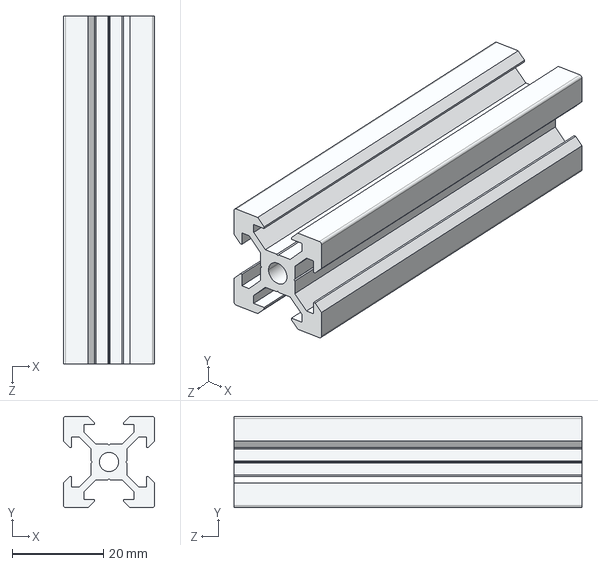
[picture p162: CAD file, 2016-05-03]
Mechanical/PLED_TEAM-4-28/PLED_TEAM-4-28/PLED_FINAL_MECHANICAL_FILES/MANUFACTURE/MANUFACTURED_PARTS_STEP_PARASOLIDS/V-SLOT_LEGS.STEP
20.0 x 20.0 x 76.2 mm
