JNCox55/PLED/Mechanical/PLED_TEAM-4-28/PLED_TEAM-4-28/PLED_FINAL_MECHANICAL_FILES/SolidWorks_OpenBuilds2/1 - Linear Rail/V-Slot 20x20x1000 Linear Rail.SLDPRT

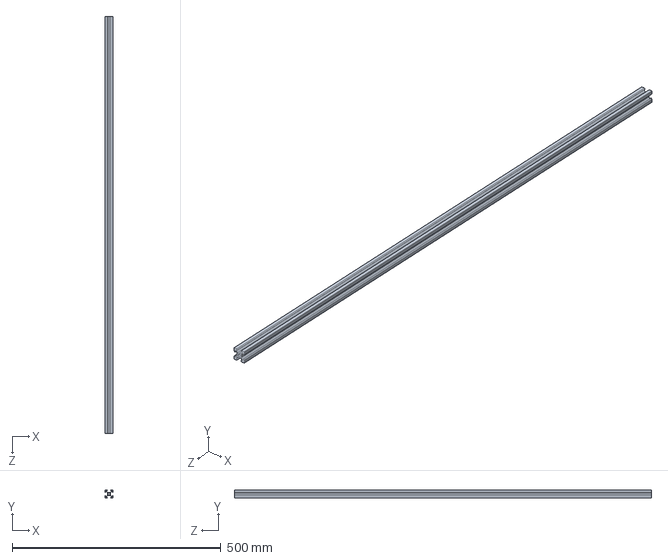
[picture p164: CAD file, 2016-03-03]
Mechanical/PLED_TEAM-4-28/PLED_TEAM-4-28/PLED_FINAL_MECHANICAL_FILES/SolidWorks_OpenBuilds2/1 - Linear Rail/V-Slot 20x20x1000 Linear Rail.SLDPRT
20.0 x 20.0 x 1000.0 mm
