JNCox55/PLED/Mechanical/PLED_TEAM-4-28/PLED_TEAM-4-28/PLED_FINAL_MECHANICAL_FILES/SolidWorks_OpenBuilds2/10 - Shims and Spacers/Nylon Spacer 0.25in.SLDPRT

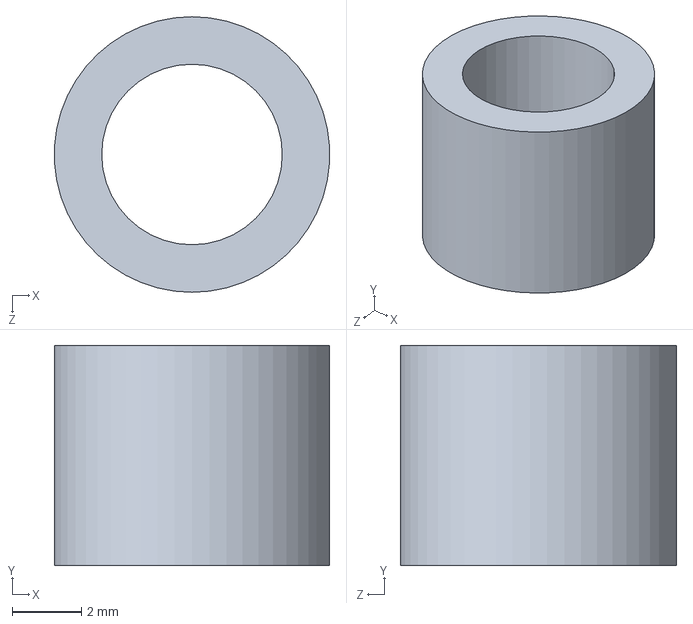
[picture p165: CAD file, 2016-03-03]
Mechanical/PLED_TEAM-4-28/PLED_TEAM-4-28/PLED_FINAL_MECHANICAL_FILES/SolidWorks_OpenBuilds2/10 - Shims and Spacers/Nylon Spacer 0.25in.SLDPRT
7.92 x 6.35 x 7.94 mm
