JNCox55/PLED/Mechanical/PLED_TEAM-4-28/PLED_TEAM-4-28/PLED_FINAL_MECHANICAL_FILES/SolidWorks_OpenBuilds2/2 - Wheels/Delrin Mini V Wheel.SLDPRT

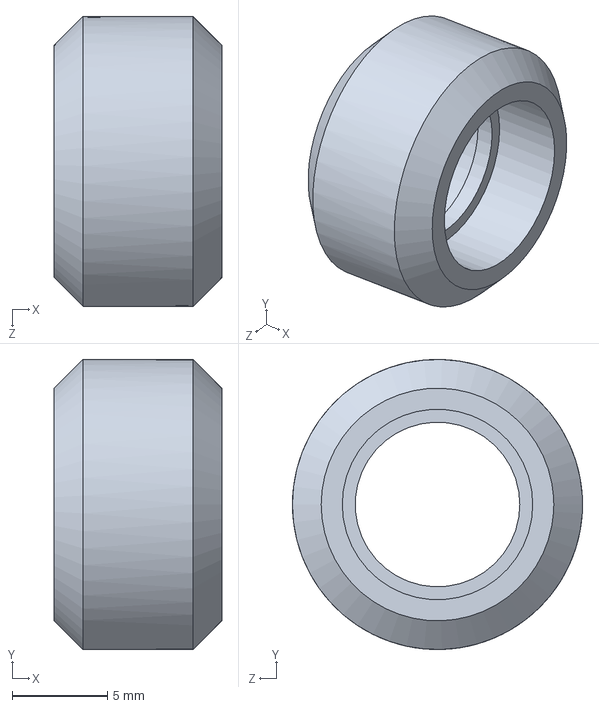
[picture p166: CAD file, 2016-03-03]
Mechanical/PLED_TEAM-4-28/PLED_TEAM-4-28/PLED_FINAL_MECHANICAL_FILES/SolidWorks_OpenBuilds2/2 - Wheels/Delrin Mini V Wheel.SLDPRT
8.80 x 15.2 x 15.2 mm
