JNCox55/PLED/Mechanical/PLED_TEAM-4-28/PLED_TEAM-4-28/PLED_FINAL_MECHANICAL_FILES/SolidWorks_OpenBuilds2/5 - Brackets/Linear Actuator End Mount.SLDPRT

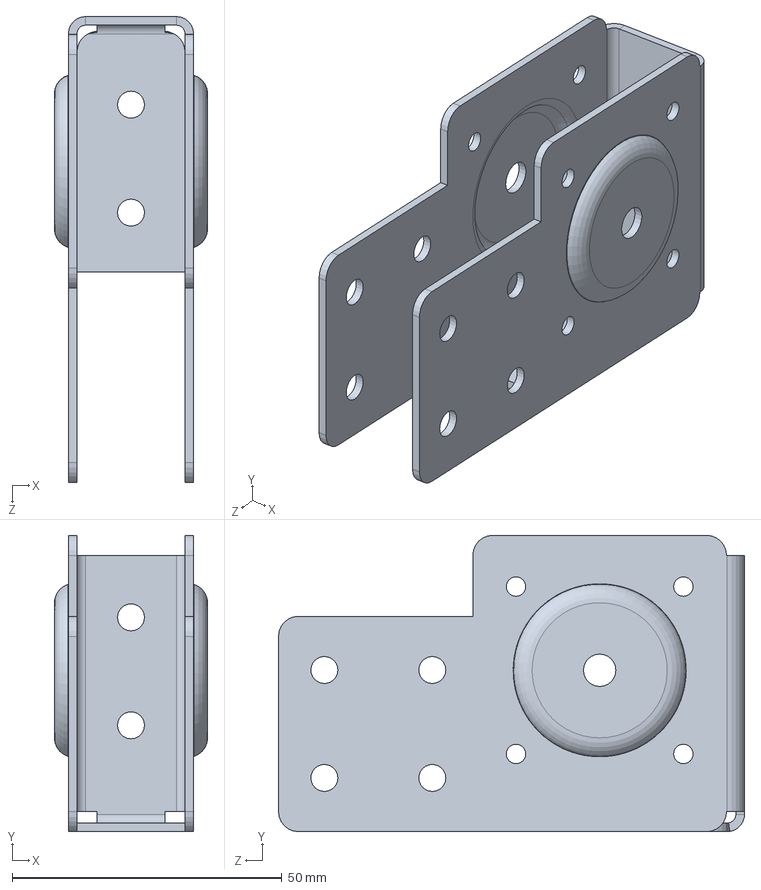
[picture p168: CAD file, 2016-03-03]
Mechanical/PLED_TEAM-4-28/PLED_TEAM-4-28/PLED_FINAL_MECHANICAL_FILES/SolidWorks_OpenBuilds2/5 - Brackets/Linear Actuator End Mount.SLDPRT
28.4 x 54.9 x 86.3 mm
