JNCox55/PLED/Mechanical/PLED_TEAM-4-28/PLED_TEAM-4-28/PLED_FINAL_MECHANICAL_FILES/SolidWorks_OpenBuilds2/7 - Hardware/Mounting Hub 5mm.SLDPRT

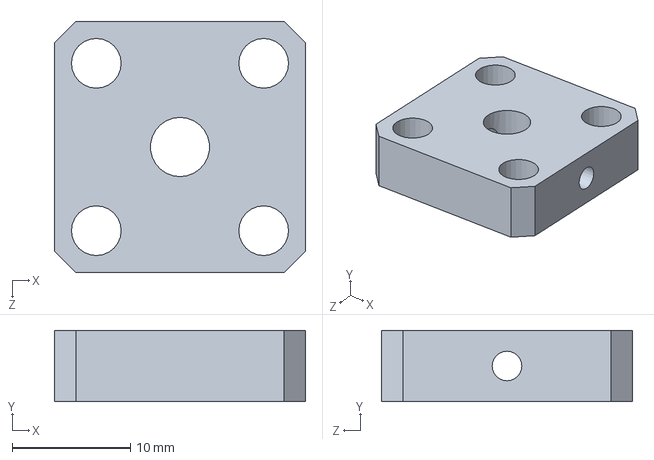
[picture p169: CAD file, 2016-03-03]
Mechanical/PLED_TEAM-4-28/PLED_TEAM-4-28/PLED_FINAL_MECHANICAL_FILES/SolidWorks_OpenBuilds2/7 - Hardware/Mounting Hub 5mm.SLDPRT
21.2 x 6.00 x 21.2 mm
