JNCox55/PLED/Mechanical/PLED_TEAM-4-28/PLED_TEAM-4-28/PLED_FINAL_MECHANICAL_FILES/SolidWorks_OpenBuilds2/8 - Plates/Mini V Wheel Plate.SLDPRT

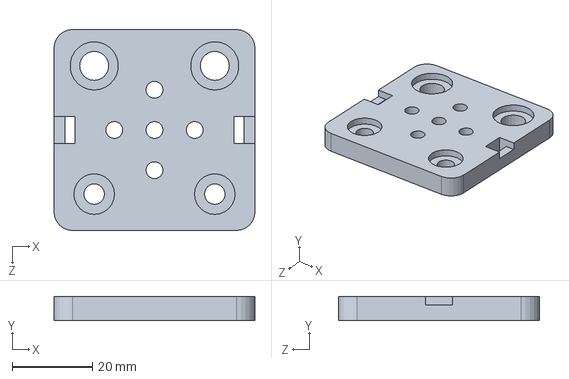
[picture p170: CAD file, 2016-03-03]
Mechanical/PLED_TEAM-4-28/PLED_TEAM-4-28/PLED_FINAL_MECHANICAL_FILES/SolidWorks_OpenBuilds2/8 - Plates/Mini V Wheel Plate.SLDPRT
50.0 x 6.00 x 50.0 mm
