JNCox55/PLED/Mechanical/PLED_TEAM-4-28/PLED_TEAM-4-28/PLED_FINAL_MECHANICAL_FILES/SolidWorks_OpenBuilds2/1 - Linear Rail/V-Slot 40x40x500 Linear Rail.SLDPRT

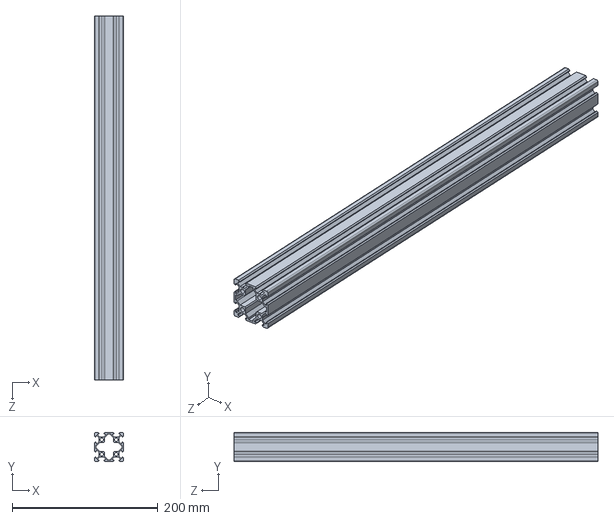
[picture p171: CAD file, 2016-03-03]
Mechanical/PLED_TEAM-4-28/PLED_TEAM-4-28/PLED_FINAL_MECHANICAL_FILES/SolidWorks_OpenBuilds2/1 - Linear Rail/V-Slot 40x40x500 Linear Rail.SLDPRT
40.0 x 40.0 x 500.0 mm
