JNCox55/PLED/Mechanical/PLED_TEAM-4-28/PLED_TEAM-4-28/PLED_FINAL_MECHANICAL_FILES/SolidWorks_OpenBuilds2/10 - Shims and Spacers/Aluminum Spacer 35mm.SLDPRT

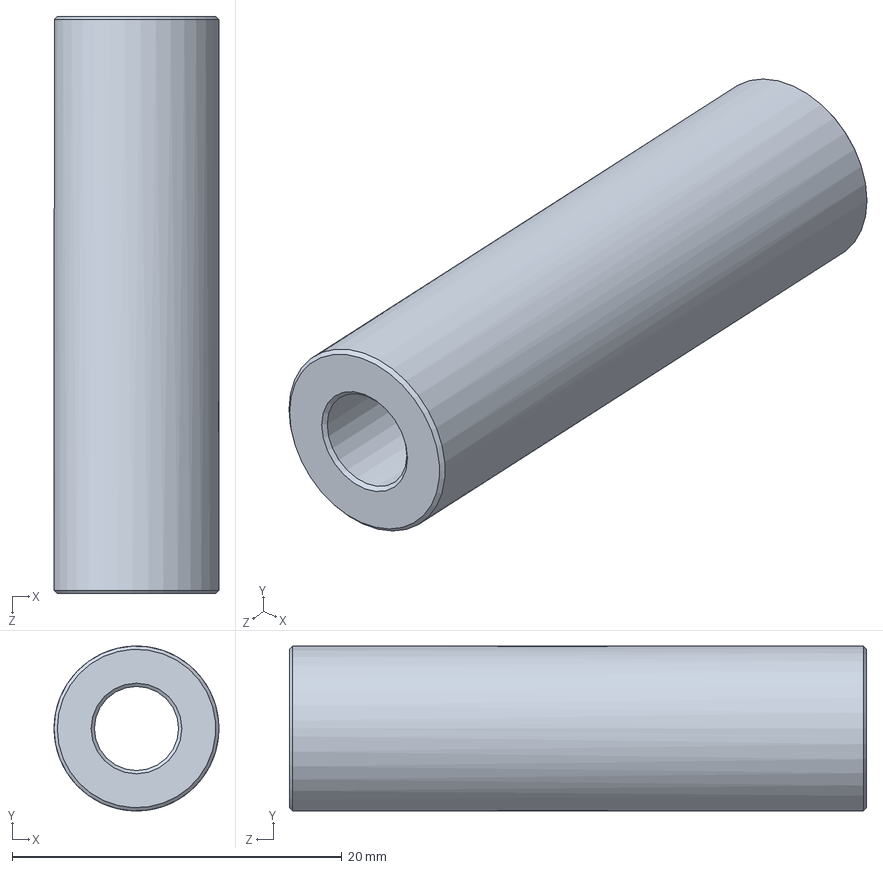
[picture p172: CAD file, 2016-03-03]
Mechanical/PLED_TEAM-4-28/PLED_TEAM-4-28/PLED_FINAL_MECHANICAL_FILES/SolidWorks_OpenBuilds2/10 - Shims and Spacers/Aluminum Spacer 35mm.SLDPRT
10.0 x 9.99 x 35.0 mm
