JNCox55/PLED/Mechanical/PLED_TEAM-4-28/PLED_TEAM-4-28/PLED_FINAL_MECHANICAL_FILES/SolidWorks_OpenBuilds2/4 - Pulleys/GT2 Timing Pulley 14 Tooth.SLDPRT

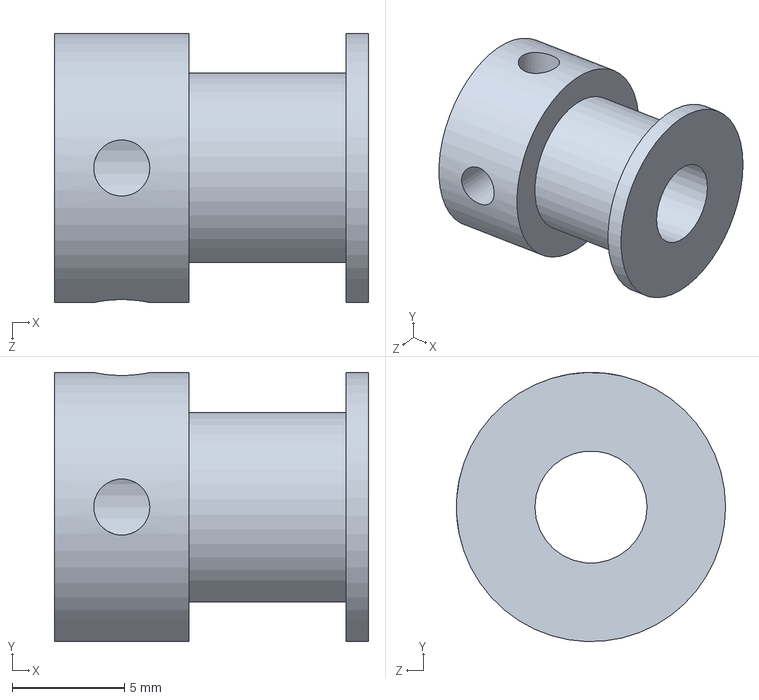
[picture p173: CAD file, 2016-03-03]
Mechanical/PLED_TEAM-4-28/PLED_TEAM-4-28/PLED_FINAL_MECHANICAL_FILES/SolidWorks_OpenBuilds2/4 - Pulleys/GT2 Timing Pulley 14 Tooth.SLDPRT
14.0 x 12.0 x 12.0 mm
