JNCox55/PLED/Mechanical/PLED_TEAM-4-28/PLED_TEAM-4-28/PLED_FINAL_MECHANICAL_FILES/SolidWorks_OpenBuilds2/5 - Brackets/Inside Hidden Corner Bracket.SLDPRT

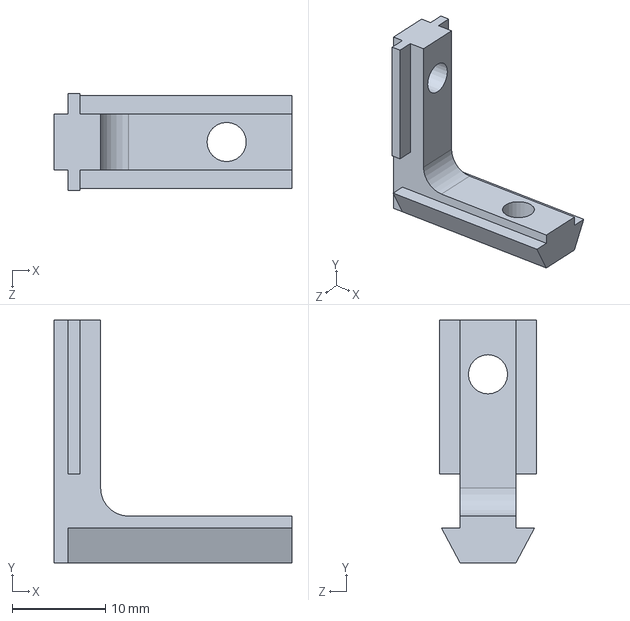
[picture p174: CAD file, 2016-03-03]
Mechanical/PLED_TEAM-4-28/PLED_TEAM-4-28/PLED_FINAL_MECHANICAL_FILES/SolidWorks_OpenBuilds2/5 - Brackets/Inside Hidden Corner Bracket.SLDPRT
25.5 x 26.0 x 10.4 mm
