JNCox55/PLED/Mechanical/PLED_TEAM-4-28/PLED_TEAM-4-28/PLED_FINAL_MECHANICAL_FILES/SolidWorks_OpenBuilds2/8 - Plates/Universal Build Plate.SLDPRT

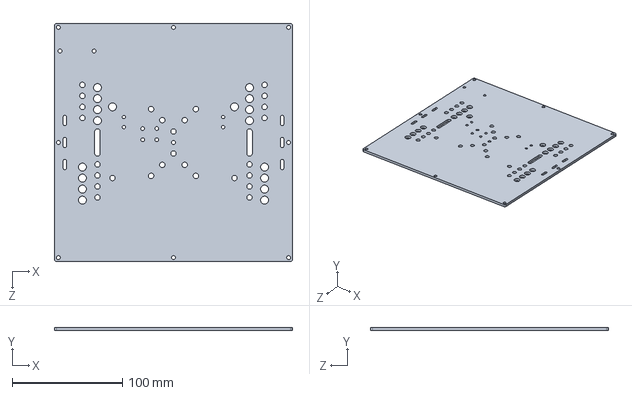
[picture p175: CAD file, 2016-03-03]
Mechanical/PLED_TEAM-4-28/PLED_TEAM-4-28/PLED_FINAL_MECHANICAL_FILES/SolidWorks_OpenBuilds2/8 - Plates/Universal Build Plate.SLDPRT
216.0 x 3.00 x 216.0 mm
