JNCox55/PLED/Mechanical/PLED_TEAM-4-28/PLED_TEAM-4-28/PLED_FINAL_MECHANICAL_FILES/MANUFACTURE/MANUFACTURED_PARTS_STEP_PARASOLIDS/ENCODER_PLATE.STEP

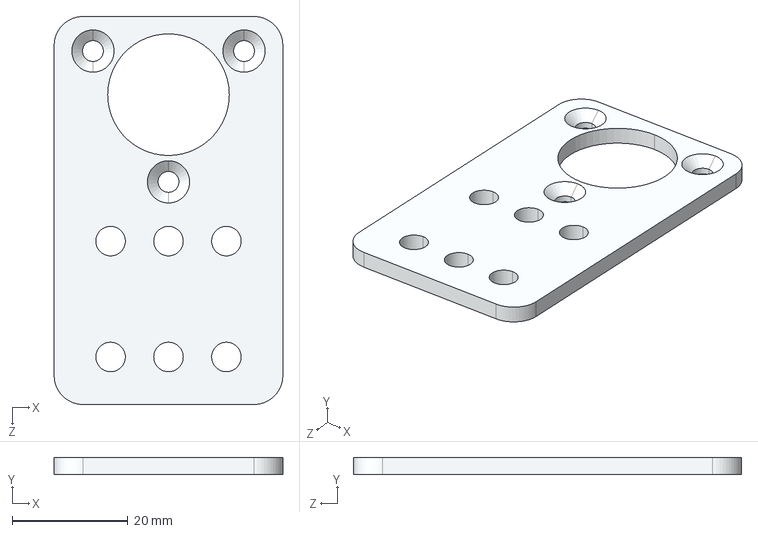
[picture p177: CAD file, 2016-05-03]
Mechanical/PLED_TEAM-4-28/PLED_TEAM-4-28/PLED_FINAL_MECHANICAL_FILES/MANUFACTURE/MANUFACTURED_PARTS_STEP_PARASOLIDS/ENCODER_PLATE.STEP
39.5 x 3.00 x 67.0 mm
