JNCox55/PLED/Mechanical/PLED_TEAM-4-28/PLED_TEAM-4-28/PLED_FINAL_MECHANICAL_FILES/SolidWorks_OpenBuilds2/10 - Shims and Spacers/Mini Eccentric Spacer 0.25in.SLDPRT

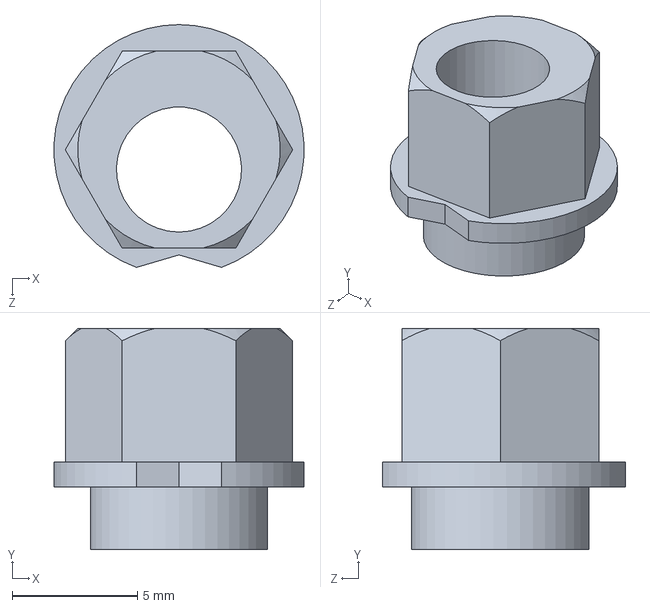
[picture p180: CAD file, 2016-03-03]
Mechanical/PLED_TEAM-4-28/PLED_TEAM-4-28/PLED_FINAL_MECHANICAL_FILES/SolidWorks_OpenBuilds2/10 - Shims and Spacers/Mini Eccentric Spacer 0.25in.SLDPRT
9.99 x 8.85 x 9.70 mm
