JNCox55/PLED/Mechanical/PLED_TEAM-4-28/PLED_TEAM-4-28/PLED_FINAL_MECHANICAL_FILES/MANUFACTURE/MANUFACTURED_PARTS_STEP_PARASOLIDS/MOD_MINI_V_PLATE.STEP

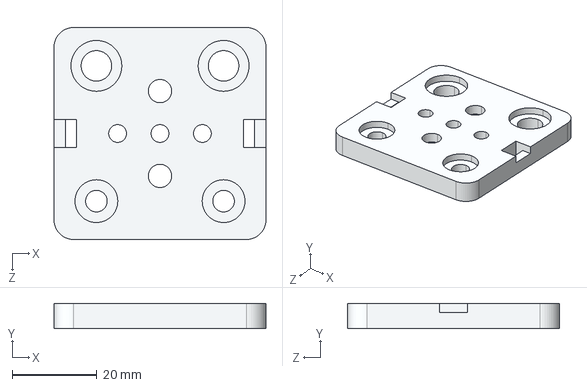
[picture p183: CAD file, 2016-05-03]
Mechanical/PLED_TEAM-4-28/PLED_TEAM-4-28/PLED_FINAL_MECHANICAL_FILES/MANUFACTURE/MANUFACTURED_PARTS_STEP_PARASOLIDS/MOD_MINI_V_PLATE.STEP
50.0 x 6.00 x 50.0 mm
