JNCox55/PLED/Mechanical/PLED_TEAM-4-28/PLED_TEAM-4-28/PLED_FINAL_MECHANICAL_FILES/SolidWorks_OpenBuilds2/10 - Shims and Spacers/Aluminum Spacer .25in.SLDPRT

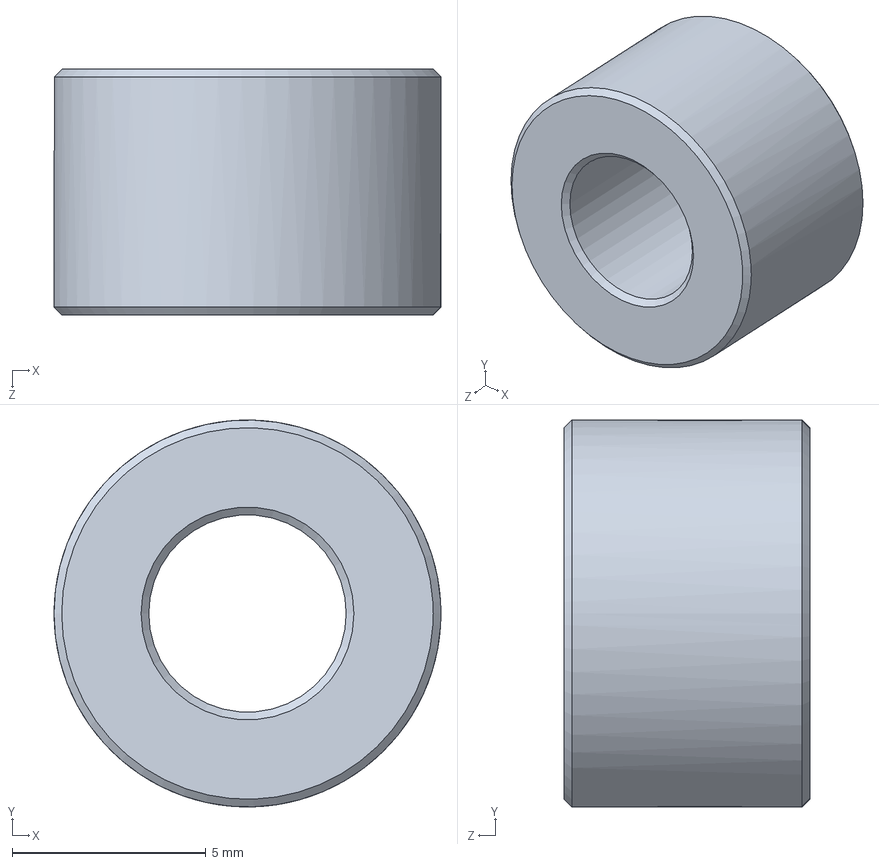
[picture p186: CAD file, 2016-03-03]
Mechanical/PLED_TEAM-4-28/PLED_TEAM-4-28/PLED_FINAL_MECHANICAL_FILES/SolidWorks_OpenBuilds2/10 - Shims and Spacers/Aluminum Spacer .25in.SLDPRT
10.0 x 10.00 x 6.35 mm
