JNCox55/PLED/Mechanical/PLED_TEAM-4-28/PLED_TEAM-4-28/PLED_FINAL_MECHANICAL_FILES/SolidWorks_OpenBuilds2/7 - Hardware/Flexible Coupling 5mm x 0.25in.SLDPRT

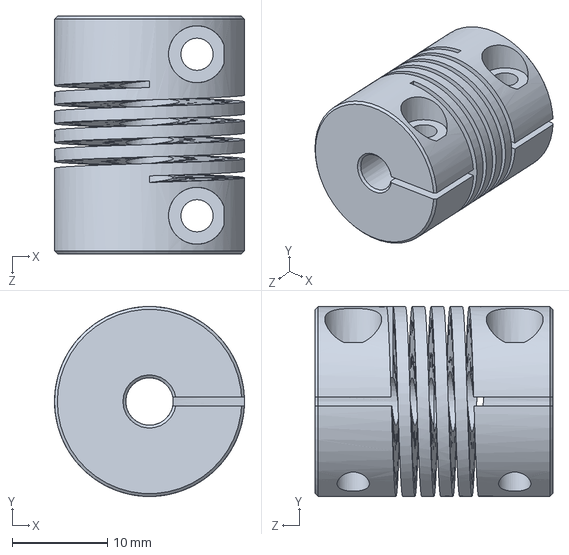
[picture p199: CAD file, 2016-03-03]
Mechanical/PLED_TEAM-4-28/PLED_TEAM-4-28/PLED_FINAL_MECHANICAL_FILES/SolidWorks_OpenBuilds2/7 - Hardware/Flexible Coupling 5mm x 0.25in.SLDPRT
20.0 x 20.0 x 25.0 mm
