JNCox55/PLED/Mechanical/PLED_TEAM-4-28/PLED_TEAM-4-28/PLED_FINAL_MECHANICAL_FILES/SolidWorks_OpenBuilds2/8 - Plates/V-Slot Gantry Plate 20-80mm.SLDPRT

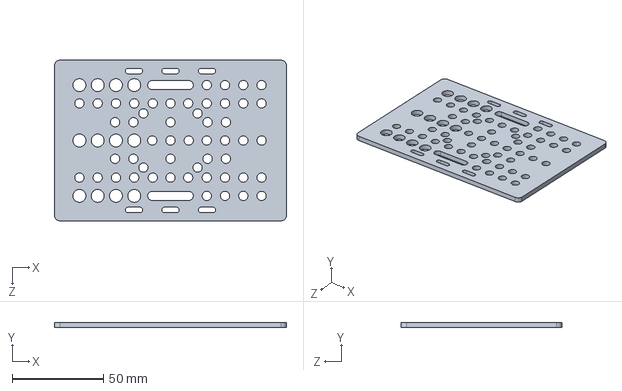
[picture p218: CAD file, 2016-03-03]
Mechanical/PLED_TEAM-4-28/PLED_TEAM-4-28/PLED_FINAL_MECHANICAL_FILES/SolidWorks_OpenBuilds2/8 - Plates/V-Slot Gantry Plate 20-80mm.SLDPRT
127.0 x 3.00 x 88.0 mm
