JNCox55/PLED/Mechanical/PLED_TEAM-4-28/PLED_TEAM-4-28/PLED_FINAL_MECHANICAL_FILES/PLED_TEAM_GANTRY_MODEL/LASER_DRIVER_APPROXIMATE_MODEL.SLDPRT

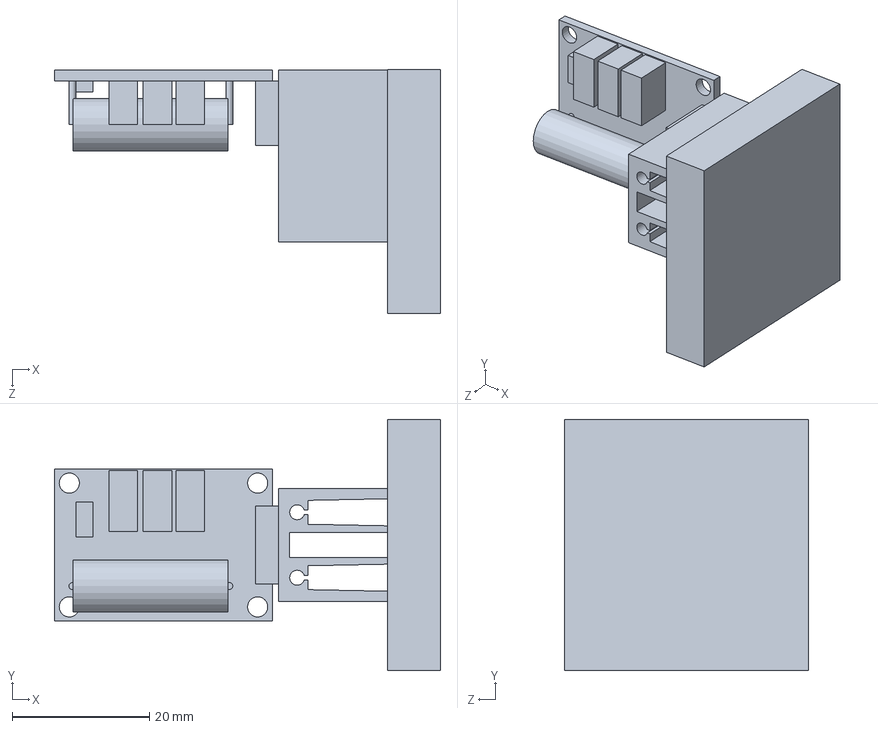
[picture p227: CAD file, 2016-05-03]
Mechanical/PLED_TEAM-4-28/PLED_TEAM-4-28/PLED_FINAL_MECHANICAL_FILES/PLED_TEAM_GANTRY_MODEL/LASER_DRIVER_APPROXIMATE_MODEL.SLDPRT
56.2 x 36.6 x 35.6 mm
