JNCox55/PLED/Mechanical/PLED_TEAM-4-28/PLED_TEAM-4-28/PLED_FINAL_MECHANICAL_FILES/MANUFACTURE/ASSEMBLY_FILES/PLED_TEAM_GANTRY_ASSEMBLY_FILES.pdf

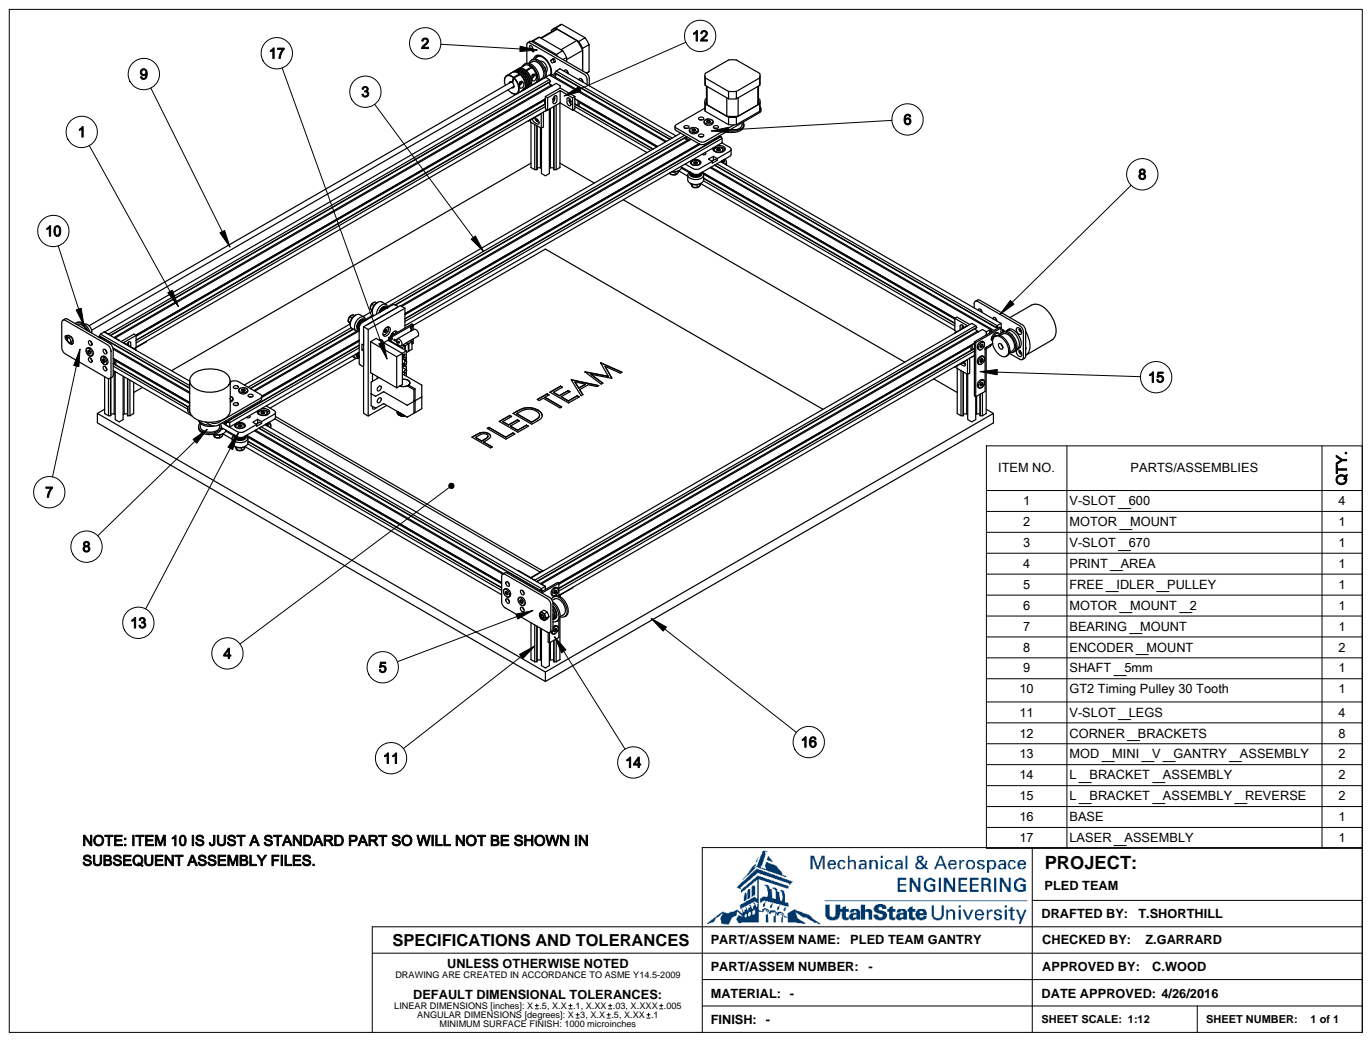
[picture p248: page 1]
PROJECT:; PLED TEAM; DRAFTED BY:; T.SHORTHILL

I D L E R P U L L E Y | 1
M O U N T 2 | 1

SPECIFICATIONS AND TOLERANCES | PART/ASSEM NAME: PLED TEAM GANTRY | CHECKED BY: Z.GARRARD
UNLESS OTHERWISE NOTED DRAWING ARE CREATED IN ACCORDANCE TO ASME Y14.5-2009 DEFAULT DIMENSIONAL TOLERANCES: LINEAR DIMENSIONS [inches]: X .5, X.X .1, X.XX .03, X.XXX .005 ANGULAR DIMENSIONS [degrees]: X 3, X.X .5, X.XX MINIMUM SURFACE FINISH: 1000 microinches | PART/ASSEM NUMBER: - | C.WOOD APPROVED BY:

MATERIAL: | DATE APPROVED: 4/26/2016

FINISH: - | SHEET SCALE: 1:12 | SHEET NUMBER: 1 of 1

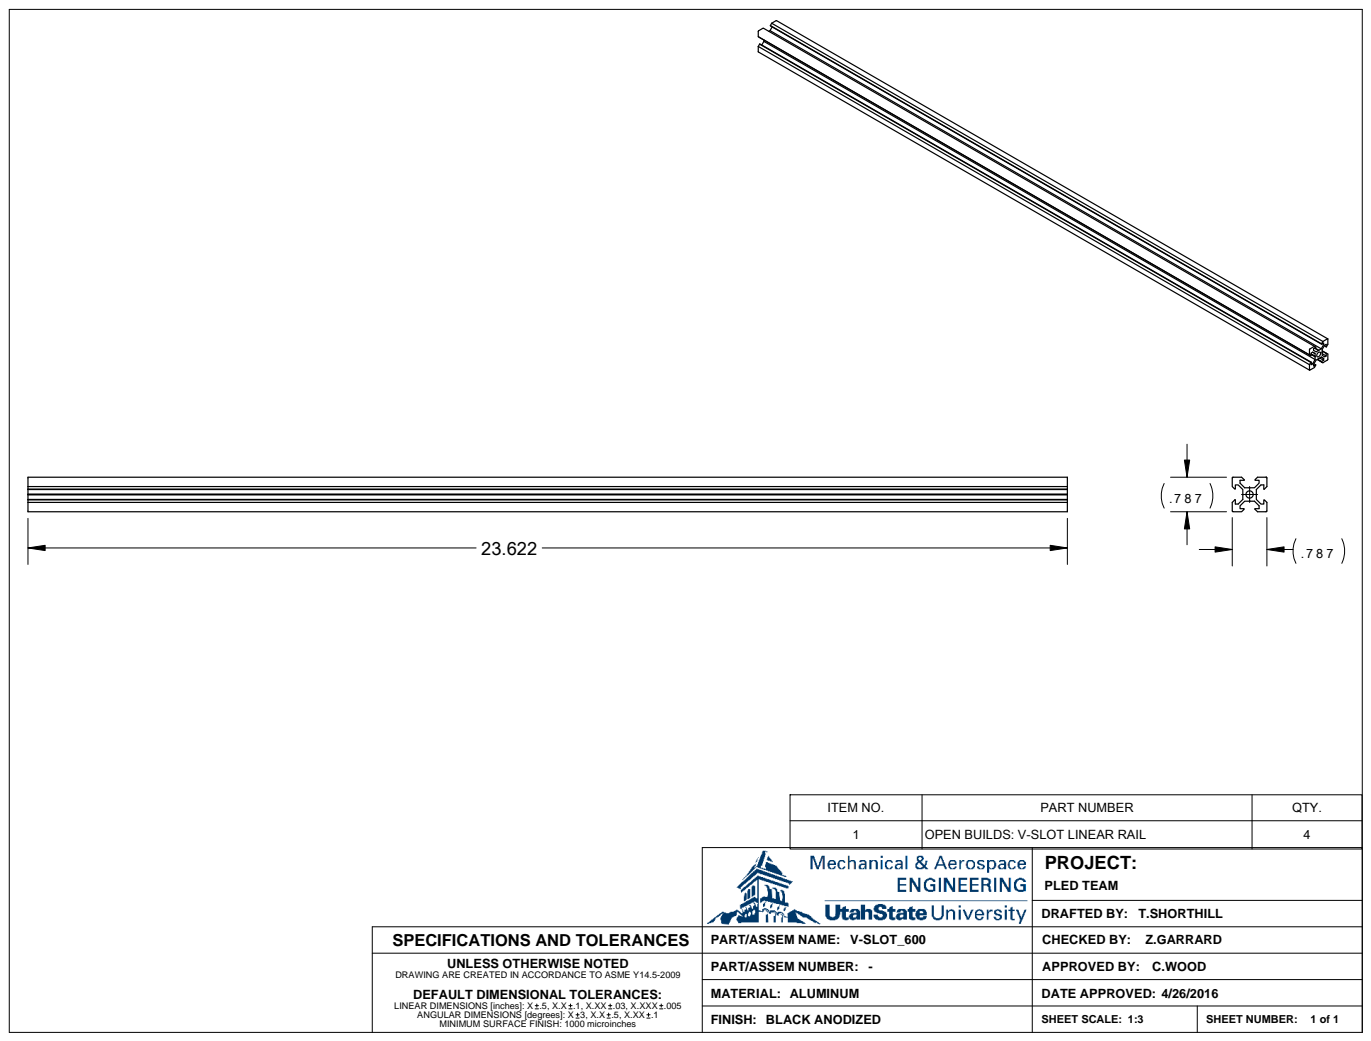
[picture p249: page 2]
PROJECT:; DRAFTED BY:; PLED TEAM; T.SHORTHILL

SPECIFICATIONS AND TOLERANCES | PART/ASSEM NAME: V-SLOT_600 | CHECKED BY: Z.GARRARD

UNLESS OTHERWISE NOTED DRAWING ARE CREATED IN ACCORDANCE TO ASME Y14.5-2009 | PART/ASSEM NUMBER: - | C.WOOD APPROVED BY:

ALUMINUM

BLACK ANODIZED | SHEET SCALE: 1:3 | SHEET NUMBER: 1 of 1

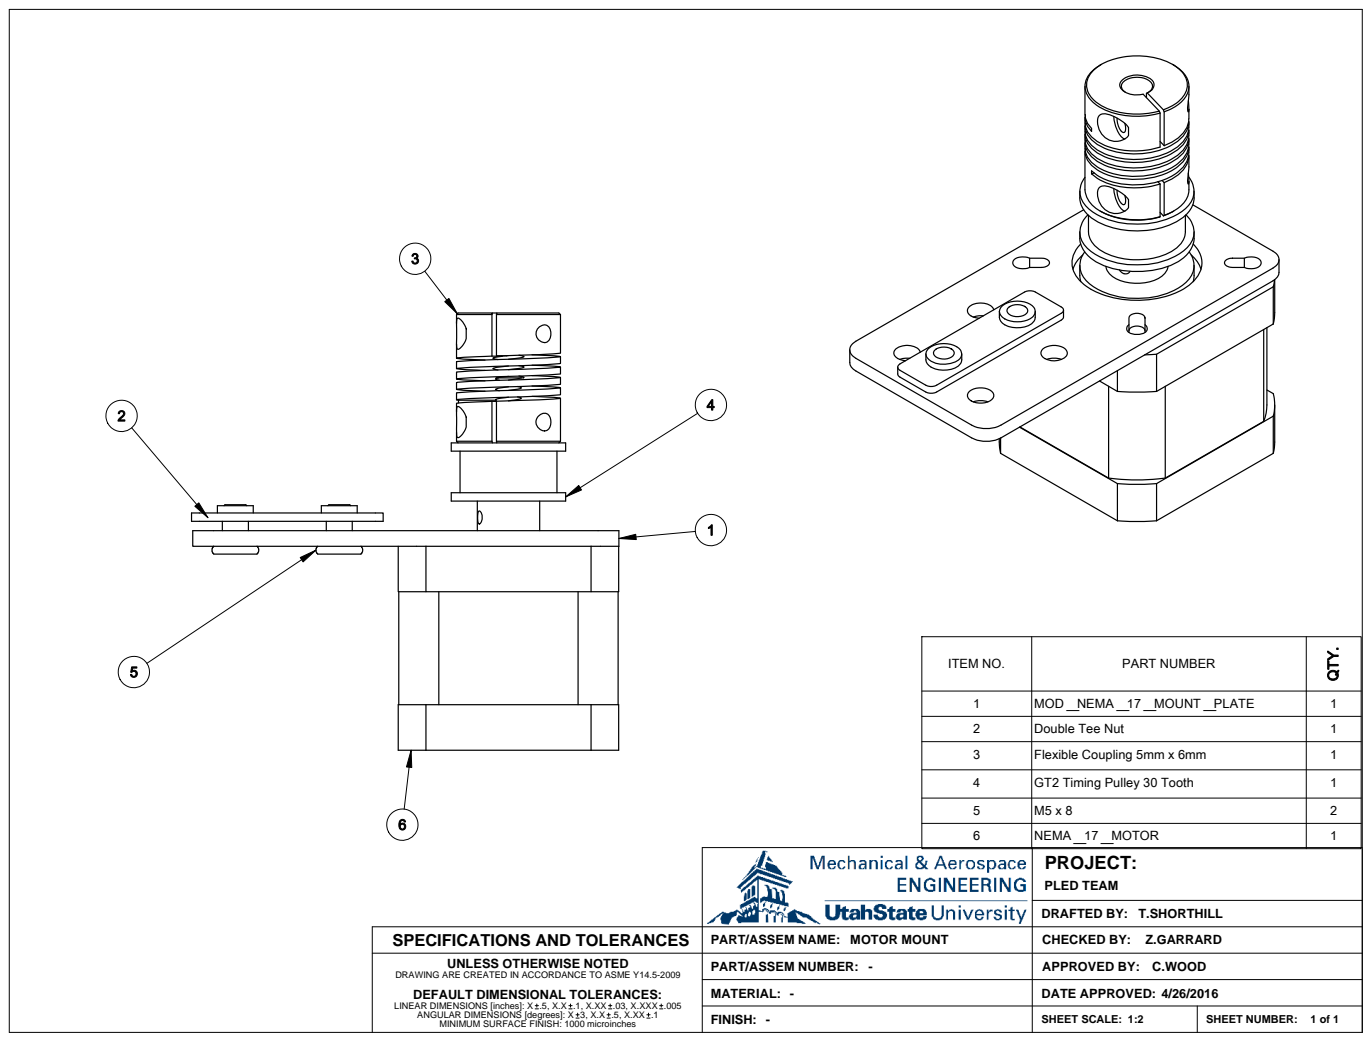
[picture p250: page 3]

PROJECT:
PLED TEAM
DRAFTED BY: T.SHORTHILL

SPECIFICATIONS AND TOLERANCES | PART/ASSEM NAME: MOTOR MOUNT | CHECKED BY: Z.GARRARD

UNLESS OTHERWISE NOTED DRAWING ARE CREATED IN ACCORDANCE TO ASME Y14.5-2009 | PART/ASSEM NUMBER: - | C.WOOD APPROVED BY:

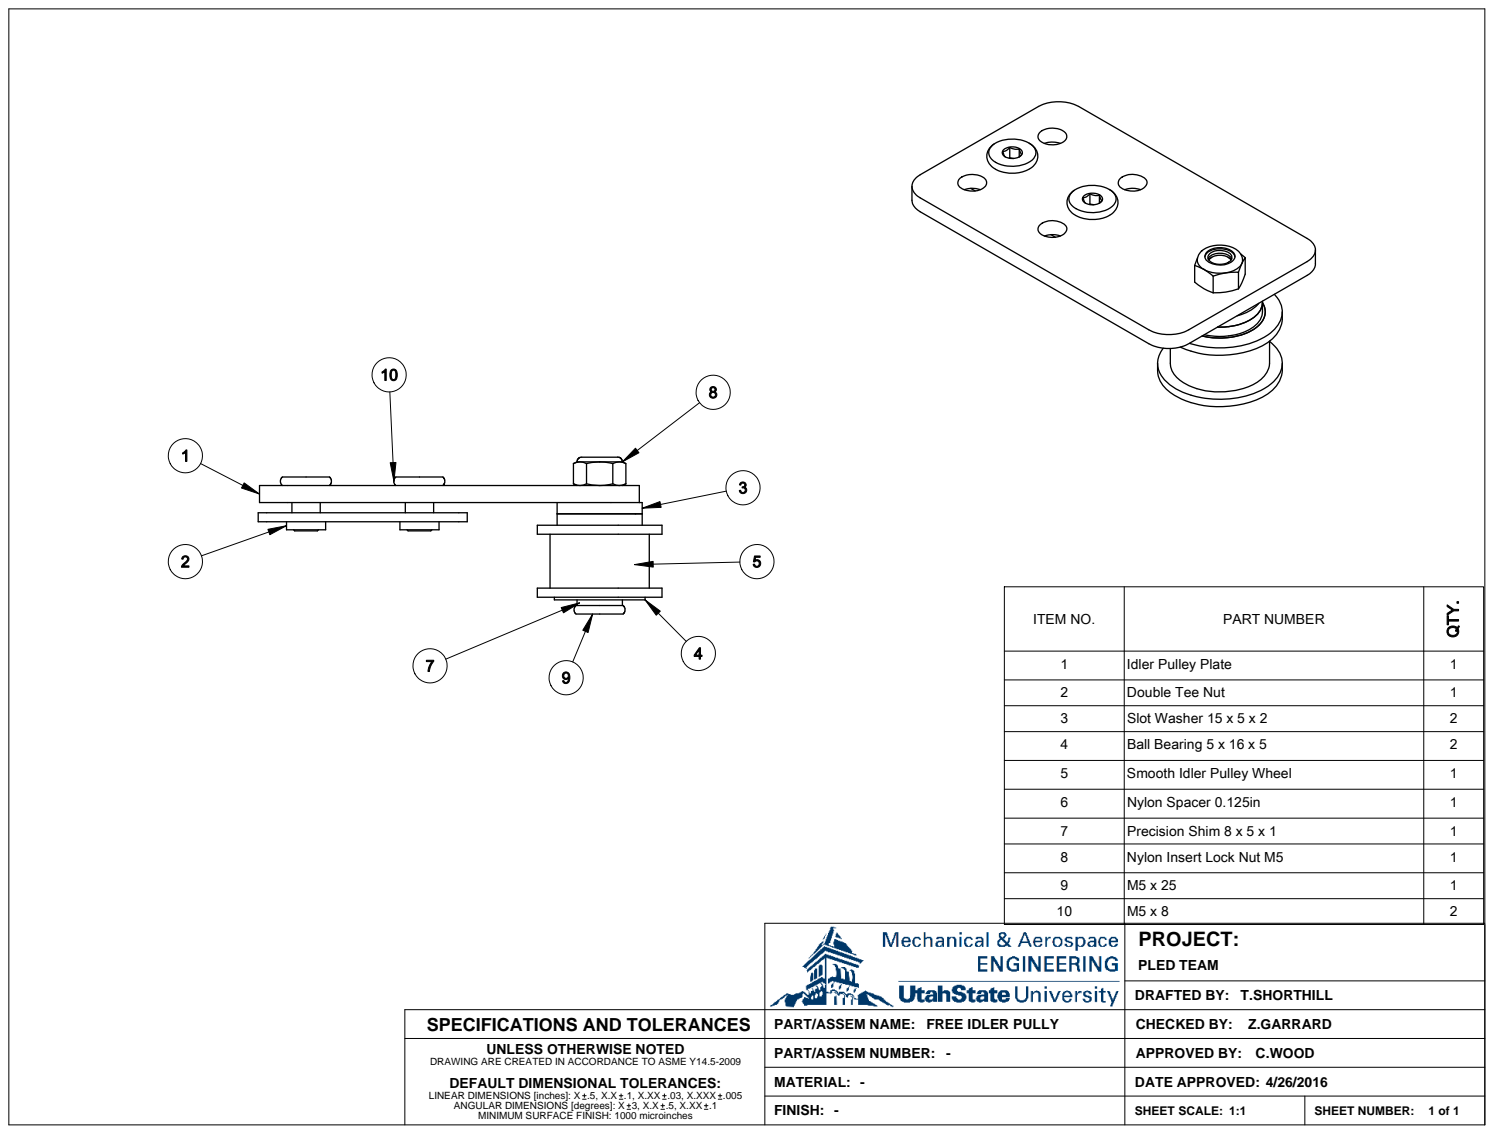
[picture p251: page 4]

PROJECT:
PLED TEAM
DRAFTED BY: T.SHORTHILL

SPECIFICATIONS AND TOLERANCES | PART/ASSEM NAME: FREE IDLER PULLY | CHECKED BY: Z.GARRARD

UNLESS OTHERWISE NOTED DRAWING ARE CREATED IN ACCORDANCE TO ASME Y14.5-2009 | PART/ASSEM NUMBER: - | C.WOOD APPROVED BY:

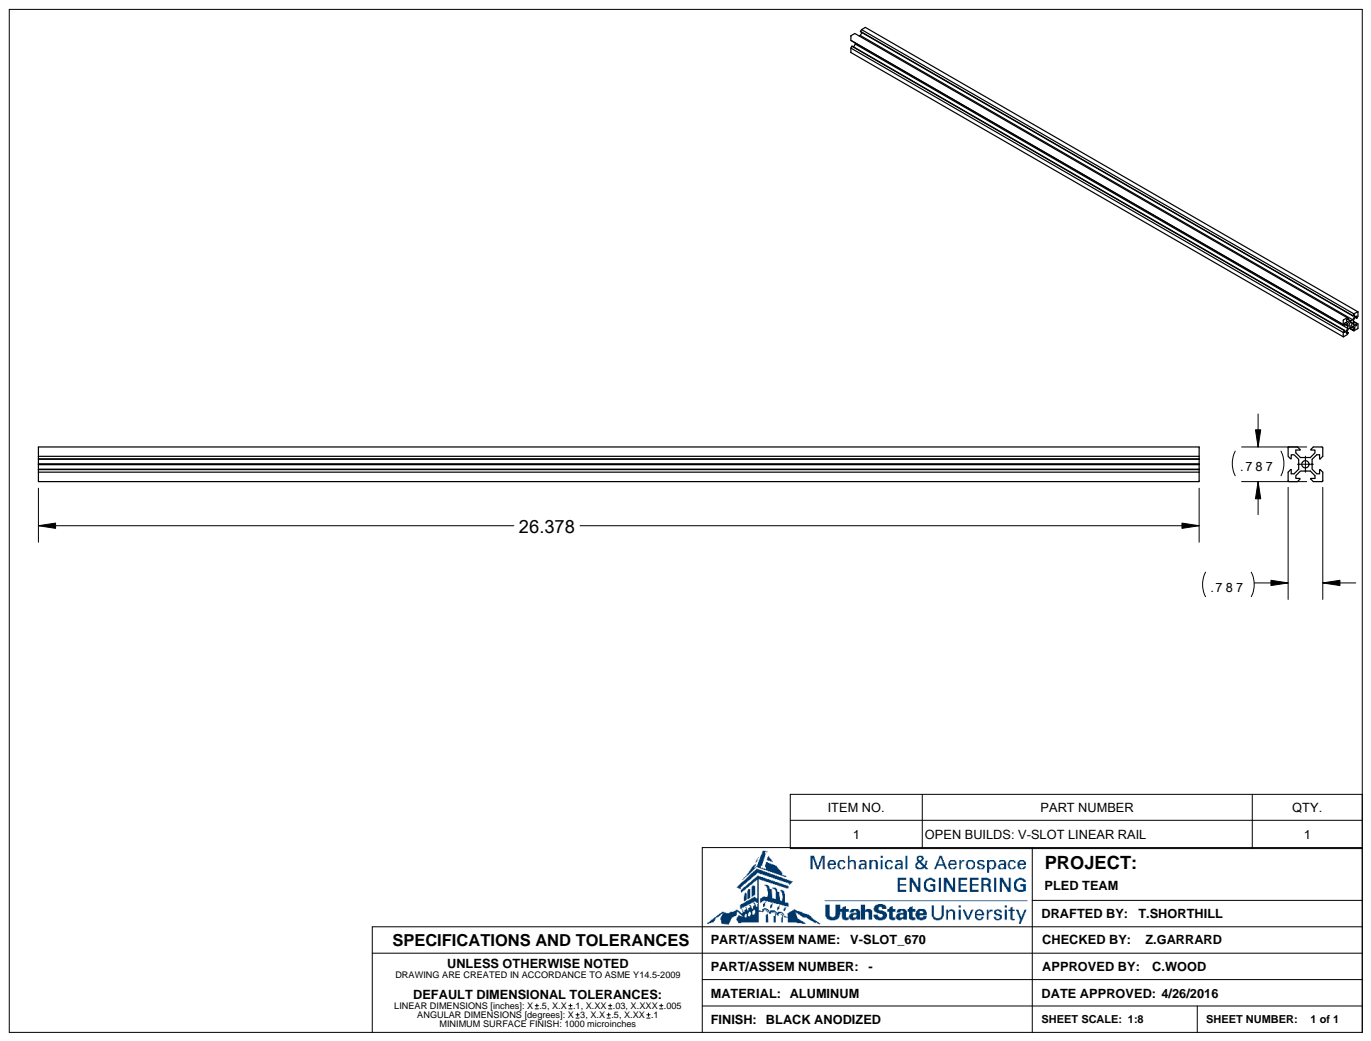
[picture p252: page 5]
PROJECT:; DRAFTED BY:; PLED TEAM; T.SHORTHILL

SPECIFICATIONS AND TOLERANCES | PART/ASSEM NAME: V-SLOT_670 | CHECKED BY: Z.GARRARD

UNLESS OTHERWISE NOTED DRAWING ARE CREATED IN ACCORDANCE TO ASME Y14.5-2009 MINIMUM SURFACE FINISH: 1000 microinches | PART/ASSEM NUMBER: - | C.WOOD APPROVED BY:

ALUMINUM

BLACK ANODIZED | 1:8 | 1 of 1

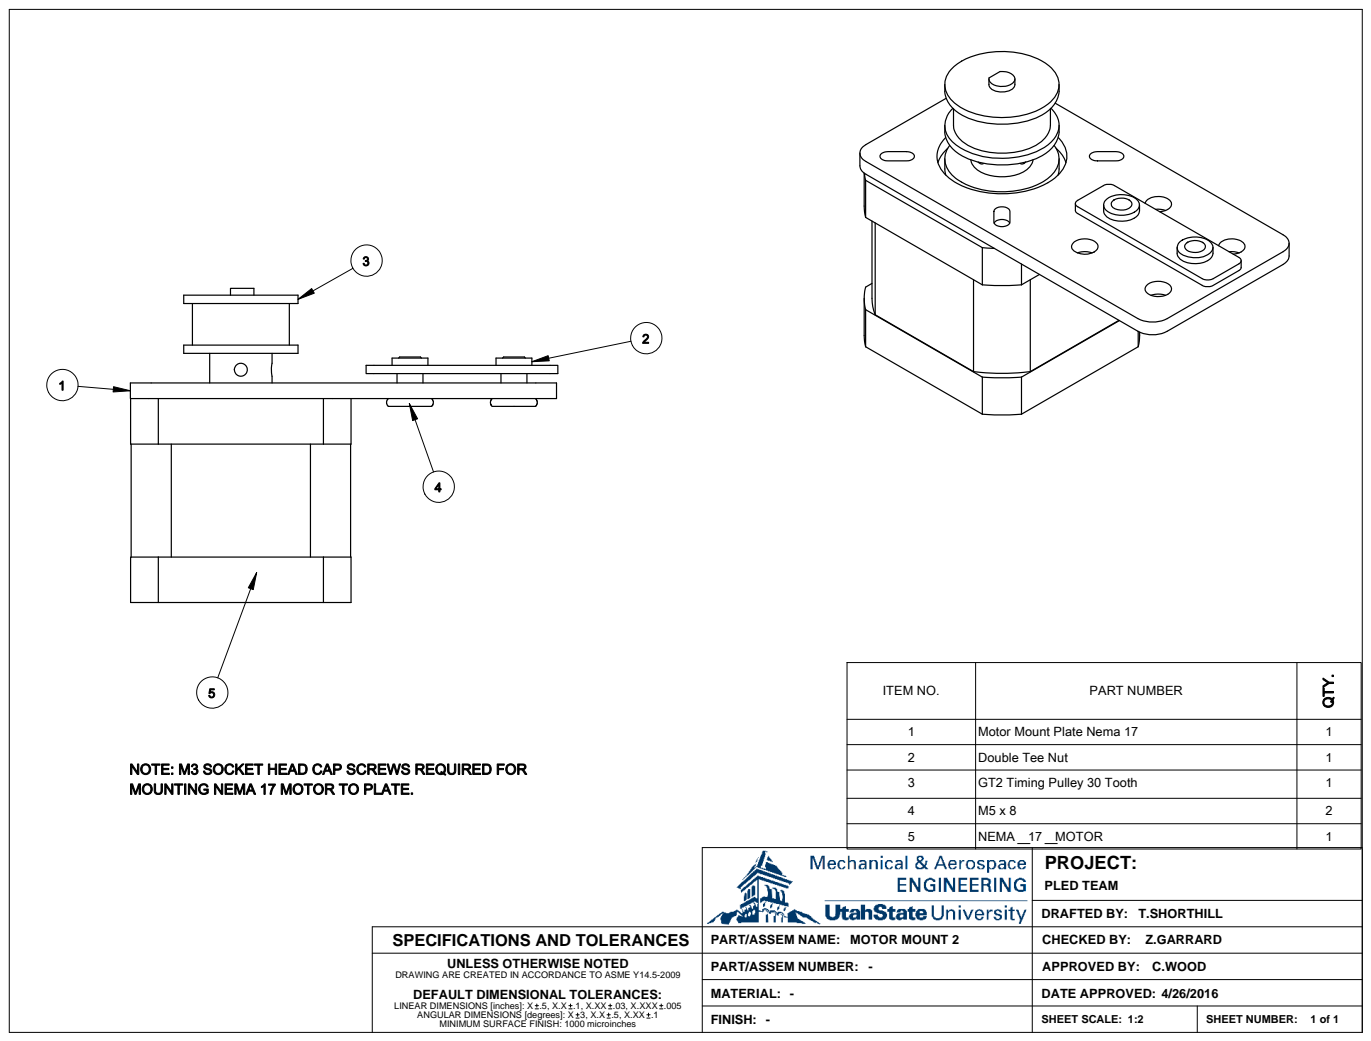
[picture p253: page 6]

PROJECT:
PLED TEAM
DRAFTED BY: T.SHORTHILL

SPECIFICATIONS AND TOLERANCES | PART/ASSEM NAME: MOTOR MOUNT 2 | CHECKED BY: Z.GARRARD

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

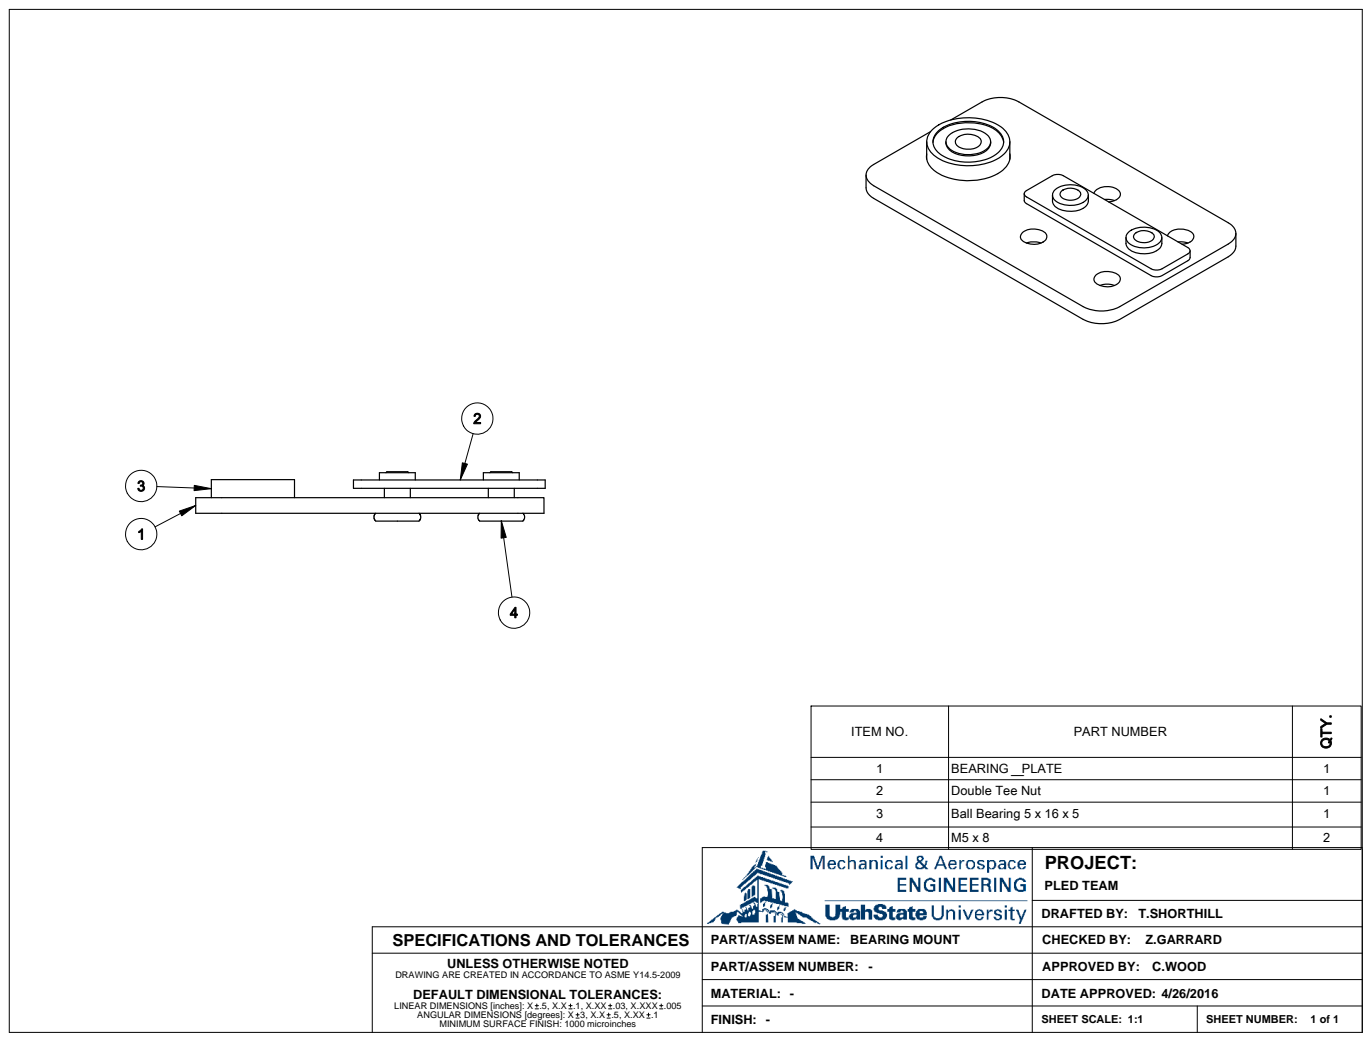
[picture p254: page 7]

PROJECT:
PLED TEAM
DRAFTED BY: T.SHORTHILL

SPECIFICATIONS AND TOLERANCES | PART/ASSEM NAME: BEARING MOUNT | CHECKED BY: Z.GARRARD

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

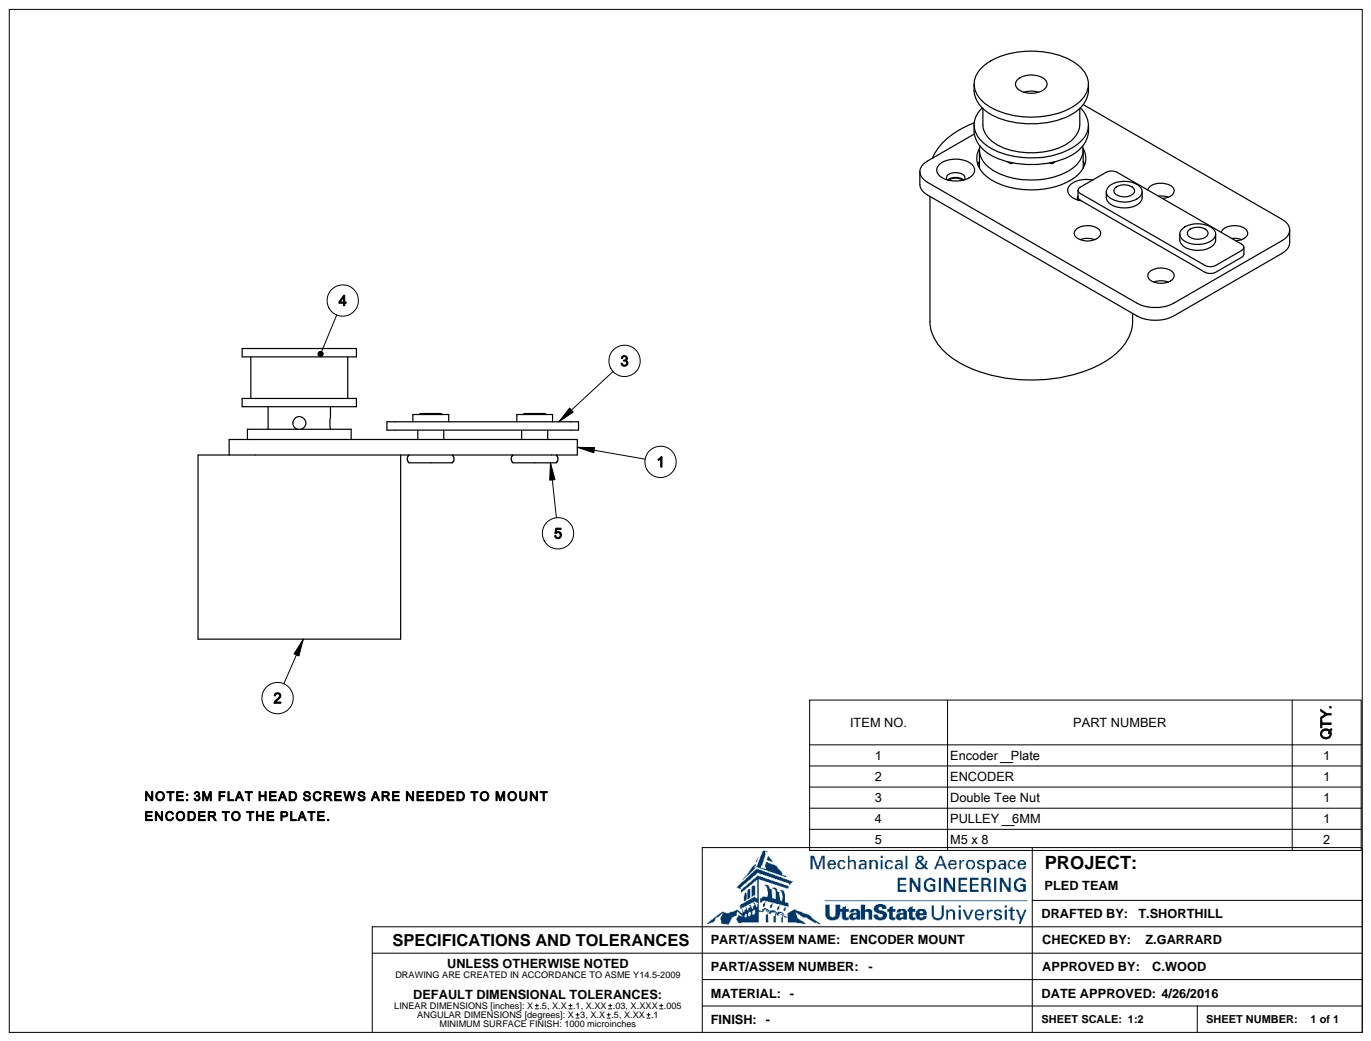
[picture p255: page 8]

PROJECT:
PLED TEAM
DRAFTED BY: T.SHORTHILL

SPECIFICATIONS AND TOLERANCES | PART/ASSEM NAME: ENCODER MOUNT | CHECKED BY: Z.GARRARD

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

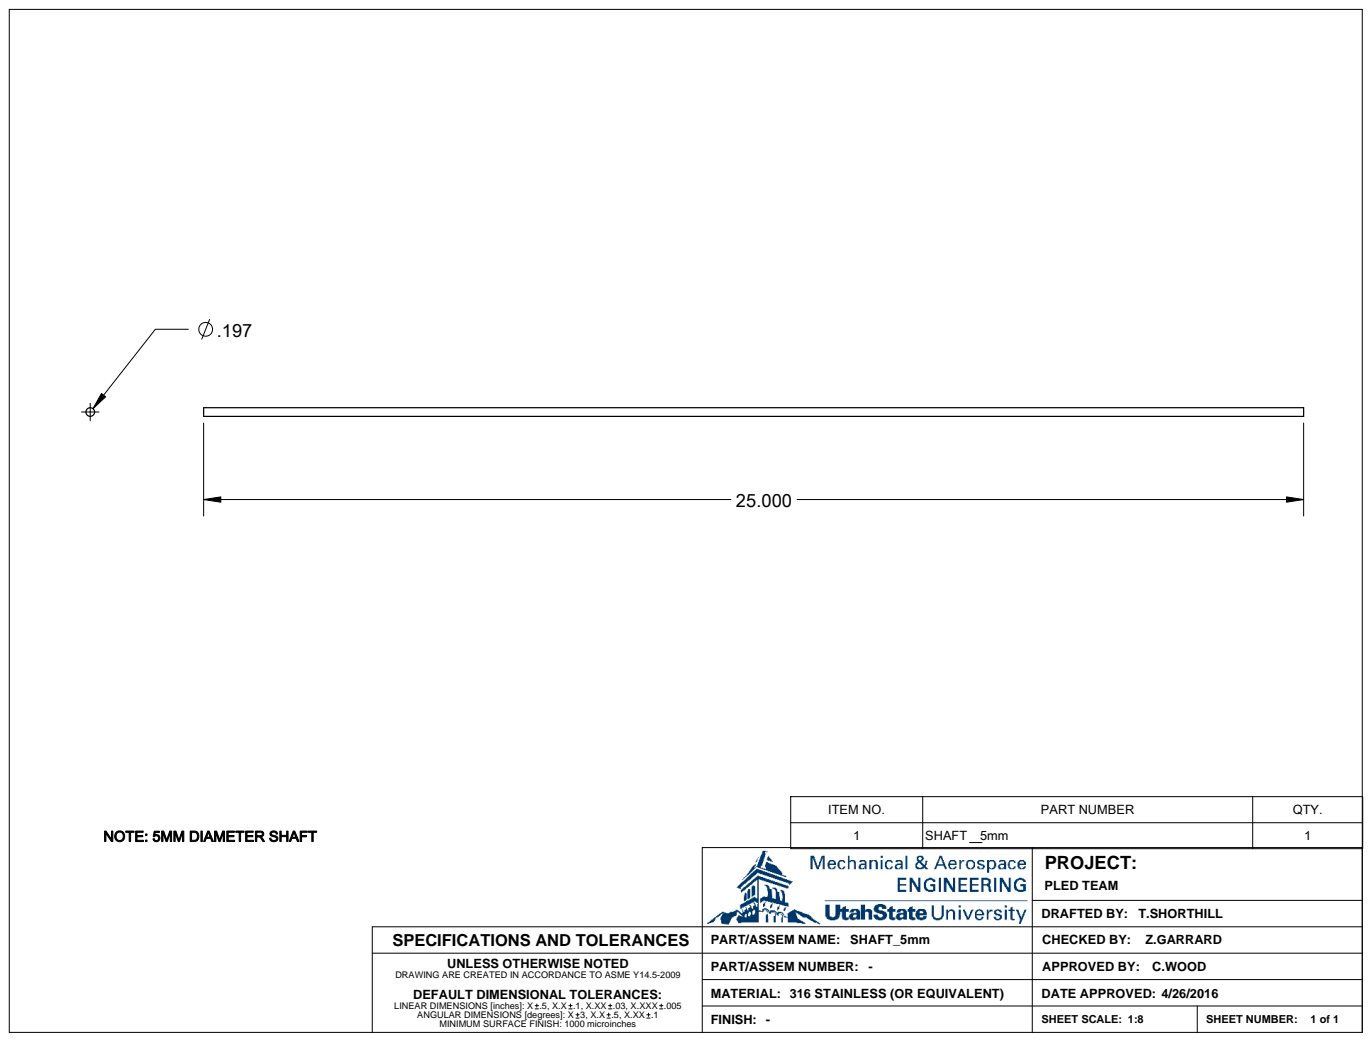
[picture p256: page 9]
PROJECT:; PLED TEAM; DRAFTED BY:; T.SHORTHILL

SPECIFICATIONS AND TOLERANCES | PART/ASSEM NAME: SHAFT_5mm | CHECKED BY: Z.GARRARD
UNLESS OTHERWISE NOTED DRAWING ARE CREATED IN ACCORDANCE TO ASME Y14.5-2009 | PART/ASSEM NUMBER: - | C.WOOD APPROVED BY:

316 STAINLESS (OR EQUIVALENT)

- | 1:8 SHEET SCALE: | SHEET NUMBER: 1 of 1

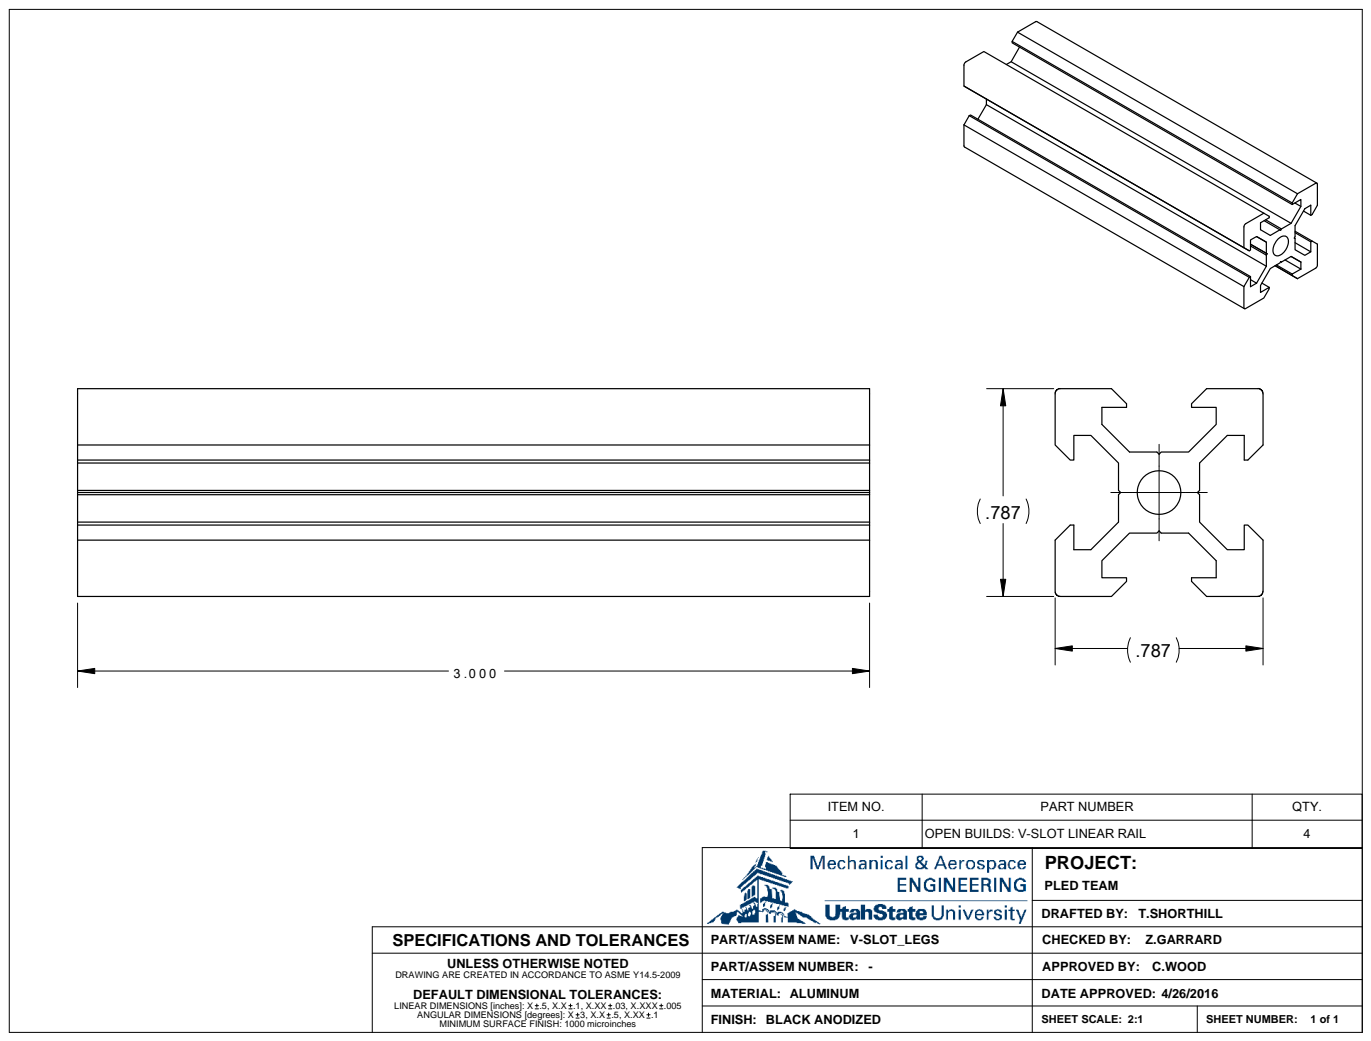
[picture p257: page 10]
PROJECT:; DRAFTED BY:; PLED TEAM; T.SHORTHILL

SPECIFICATIONS AND TOLERANCES | PART/ASSEM NAME: V-SLOT_LEGS | CHECKED BY: Z.GARRARD

UNLESS OTHERWISE NOTED DRAWING ARE CREATED IN ACCORDANCE TO ASME Y14.5-2009 MINIMUM SURFACE FINISH: 1000 microinches | PART/ASSEM NUMBER: - | C.WOOD APPROVED BY:

ALUMINUM

BLACK ANODIZED | 2:1 | 1 of 1

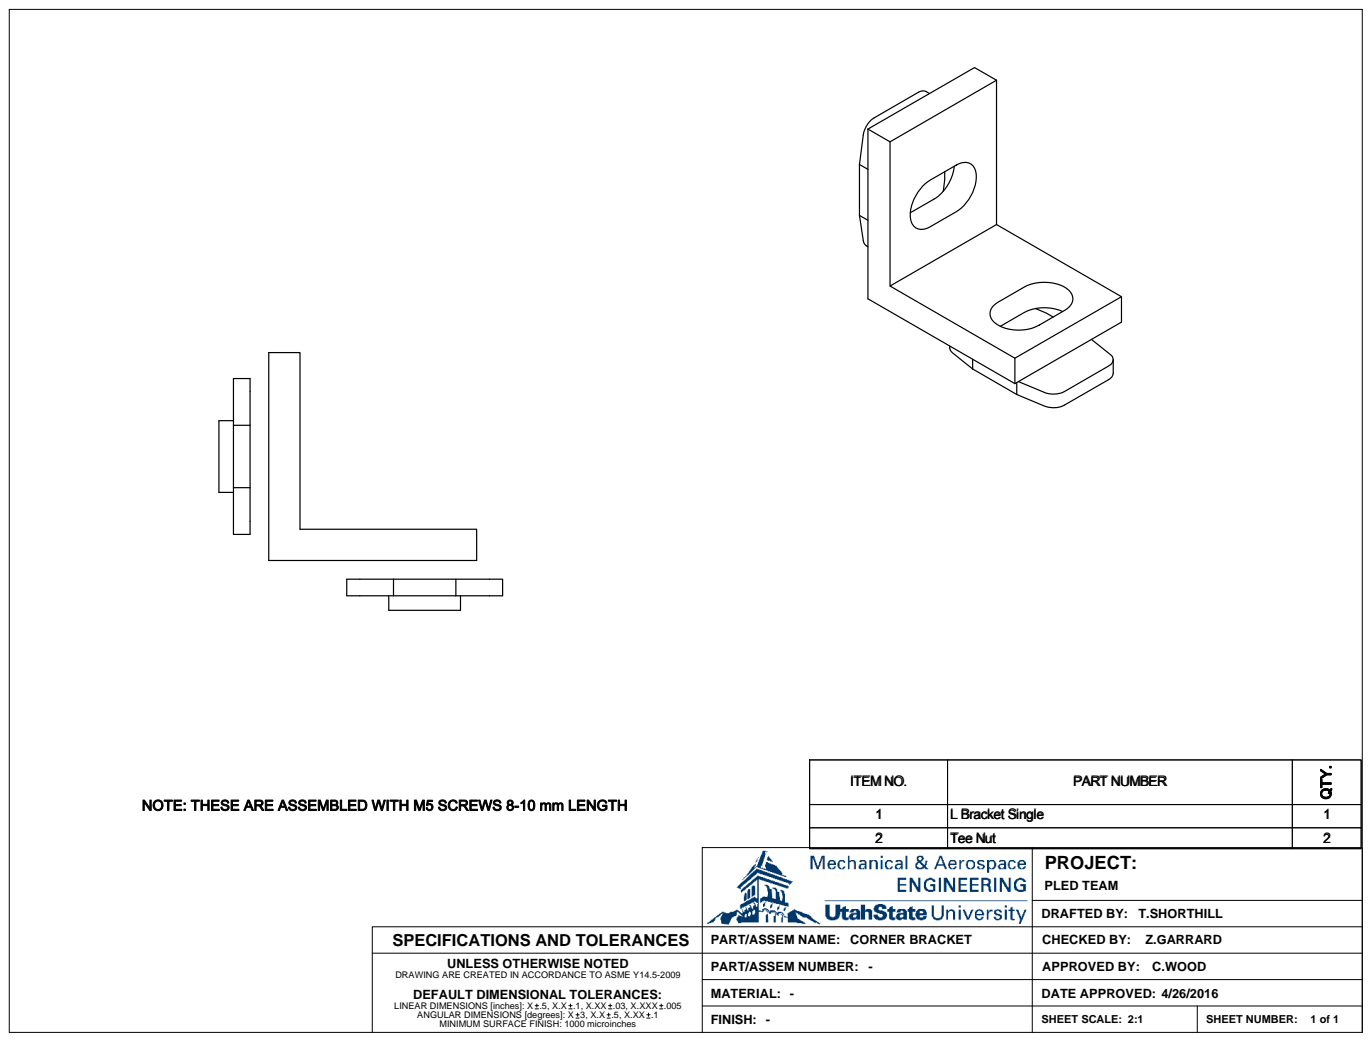
[picture p258: page 11]
PROJECT:; PLED TEAM; APPROVED BY:; CHECKED BY:; Z.GARRARD; DRAFTED BY:; T.SHORTHILL; MINIMUM SURFACE FINISH: 1000 microinches; UNLESS OTHERWISE NOTED; C.WOOD

SPECIFICATIONS AND TOLERANCES

PART/ASSEM NAME: CORNER BRACKET
PART/ASSEM NUMBER:

DRAWING ARE CREATED IN ACCORDANCE TO ASME Y14.5-2009

SHEET SCALE: | SHEET NUMBER: 1 of 1

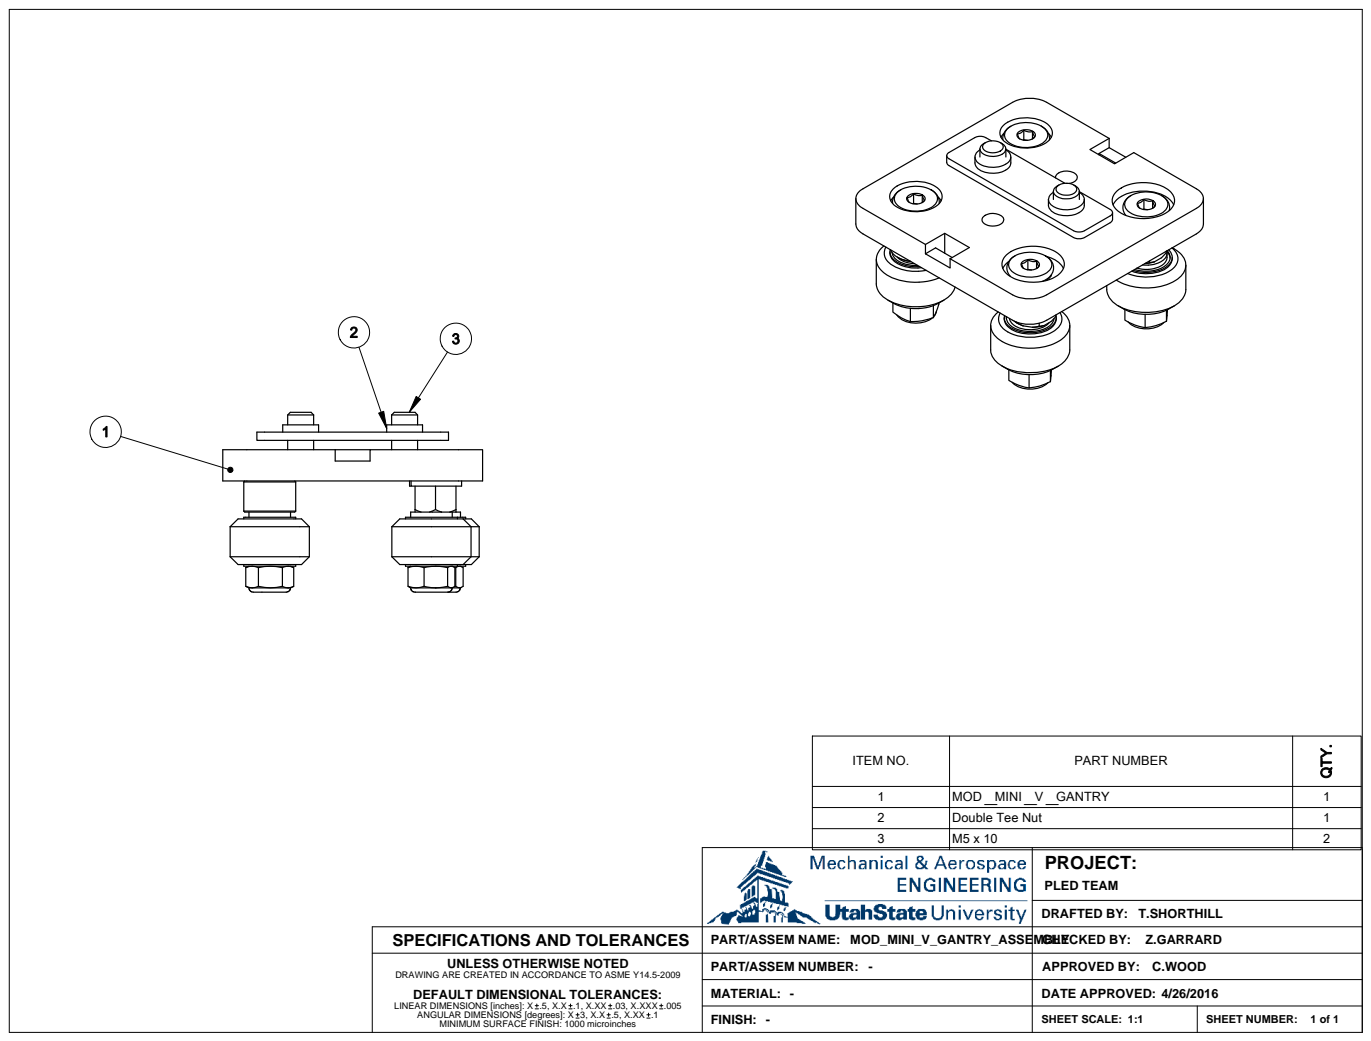
[picture p259: page 12]

PROJECT:
PLED TEAM
DRAFTED BY: T.SHORTHILL

SPECIFICATIONS AND TOLERANCES | PART/ASSEM NAME: MOD_MINI_V_GANTRY_ASSEMBLY | CHECKED BY: Z.GARRARD

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

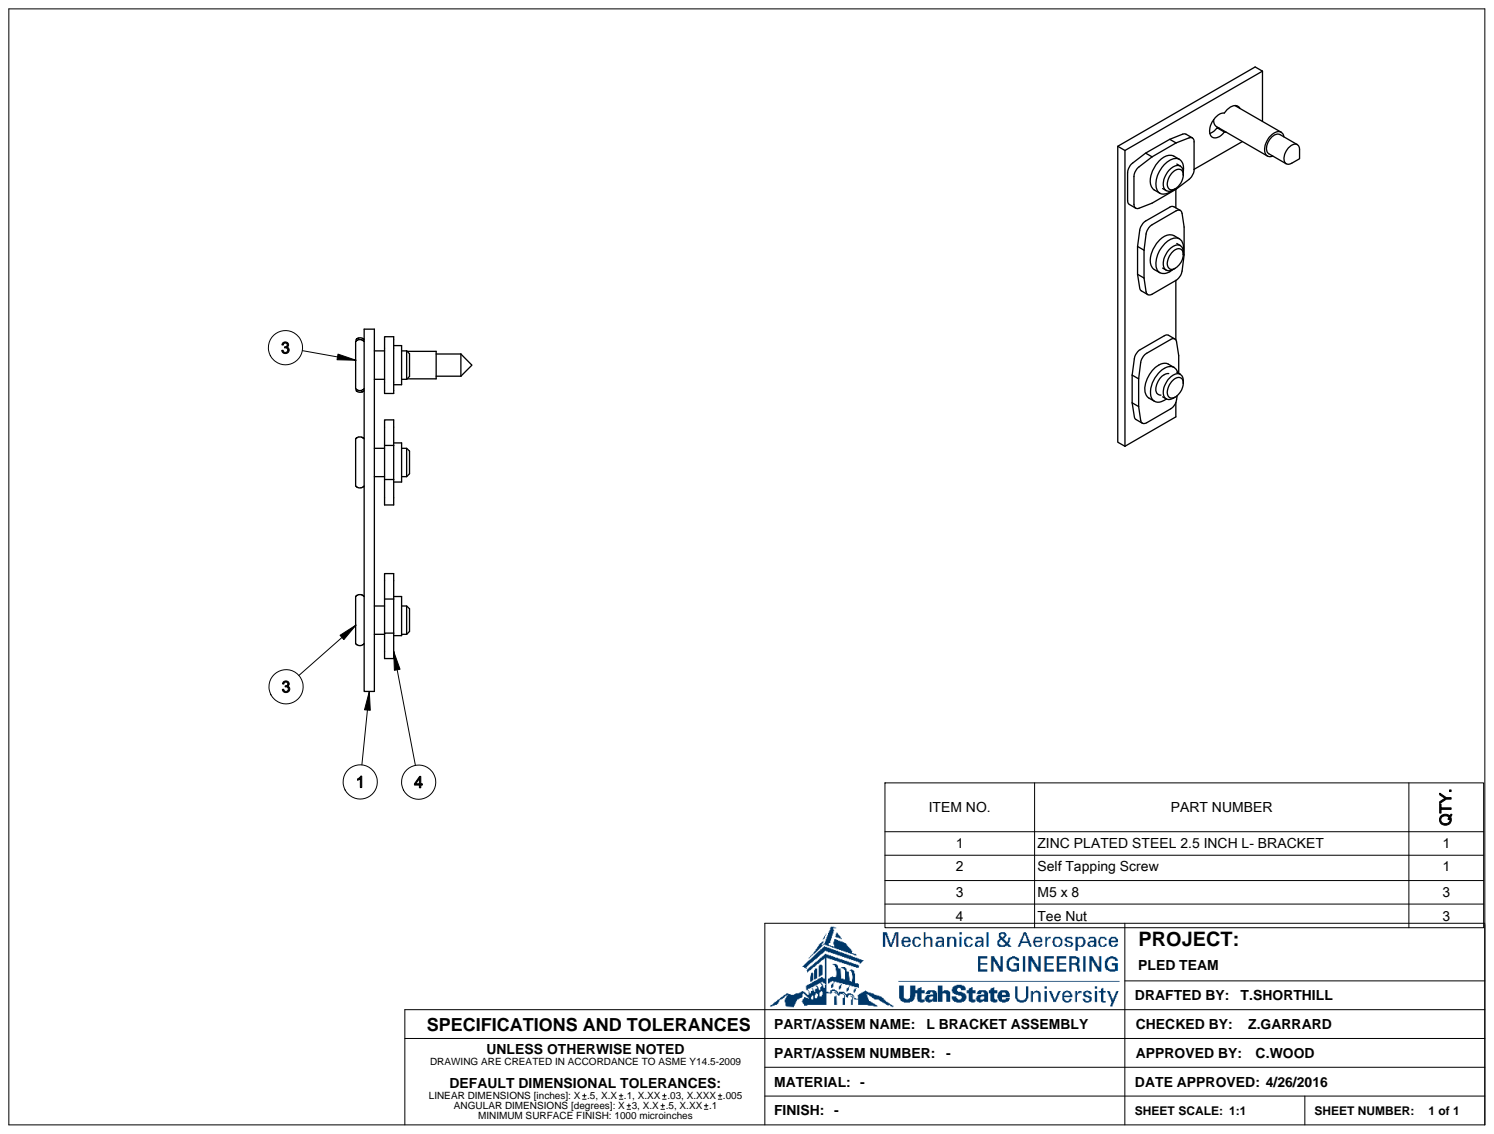
[picture p260: page 13]

PROJECT:
PLED TEAM
DRAFTED BY: T.SHORTHILL

SPECIFICATIONS AND TOLERANCES | PART/ASSEM NAME: L BRACKET ASSEMBLY | CHECKED BY: Z.GARRARD

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

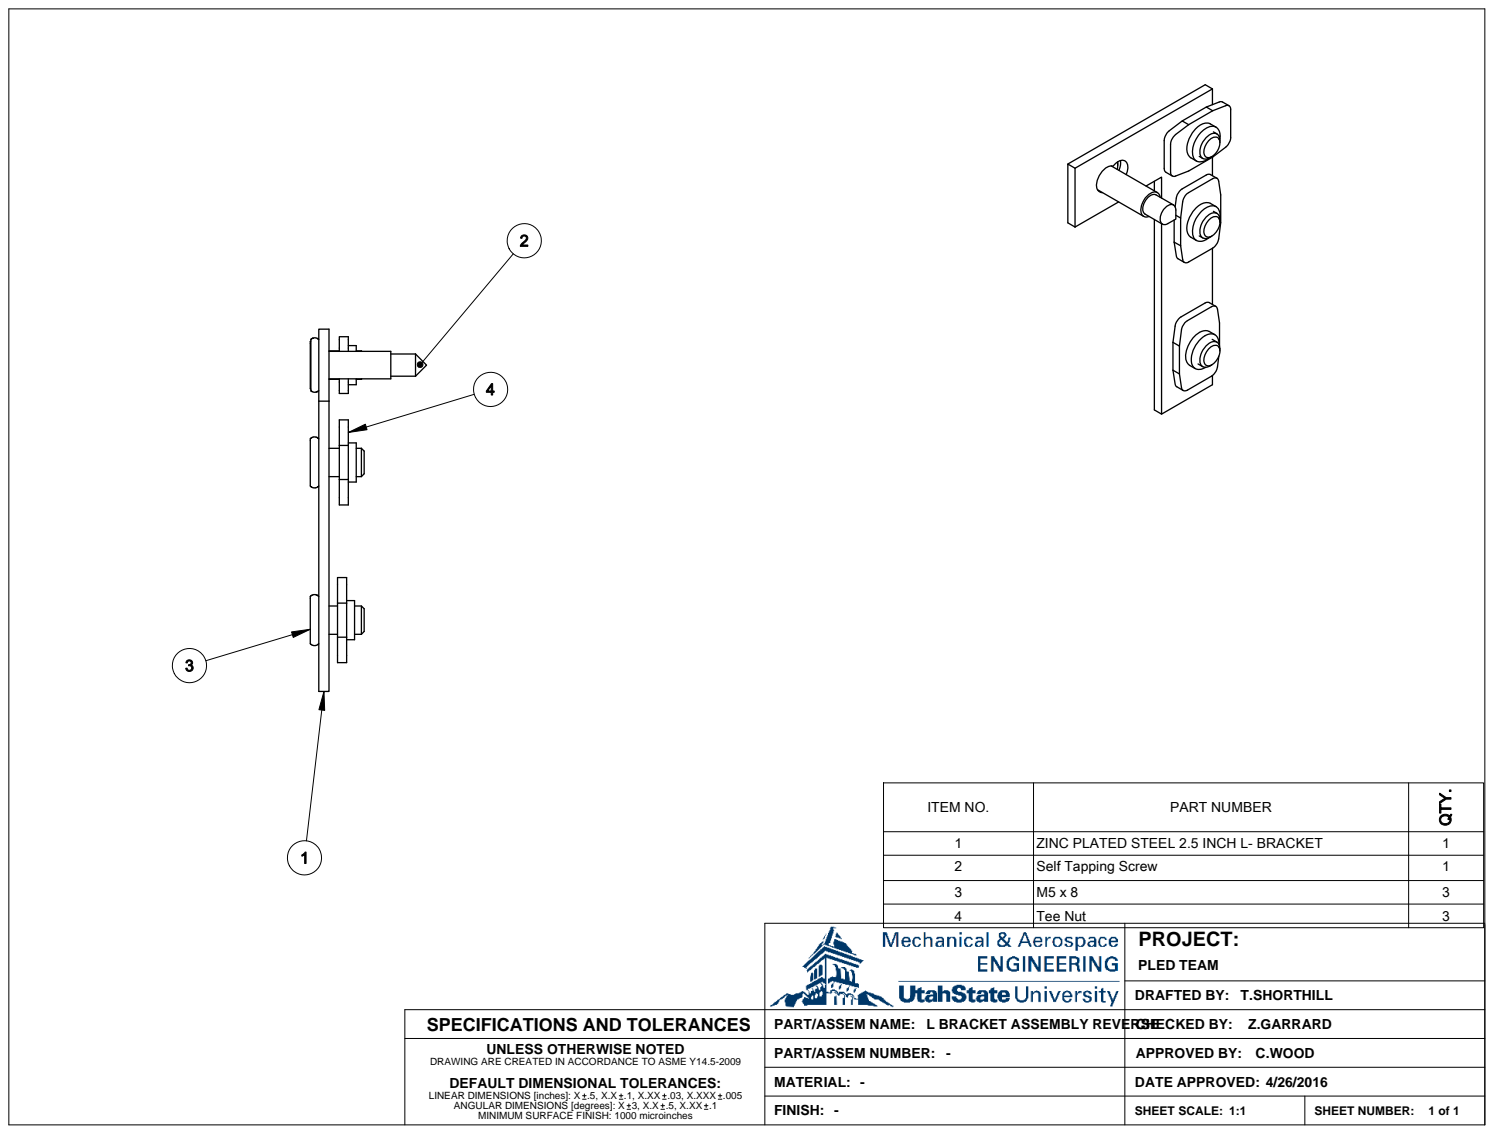
[picture p261: page 14]

PROJECT:
PLED TEAM
DRAFTED BY: T.SHORTHILL

SPECIFICATIONS AND TOLERANCES | PART/ASSEM NAME: L BRACKET ASSEMBLY REVERSE | CHECKED BY: Z.GARRARD

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

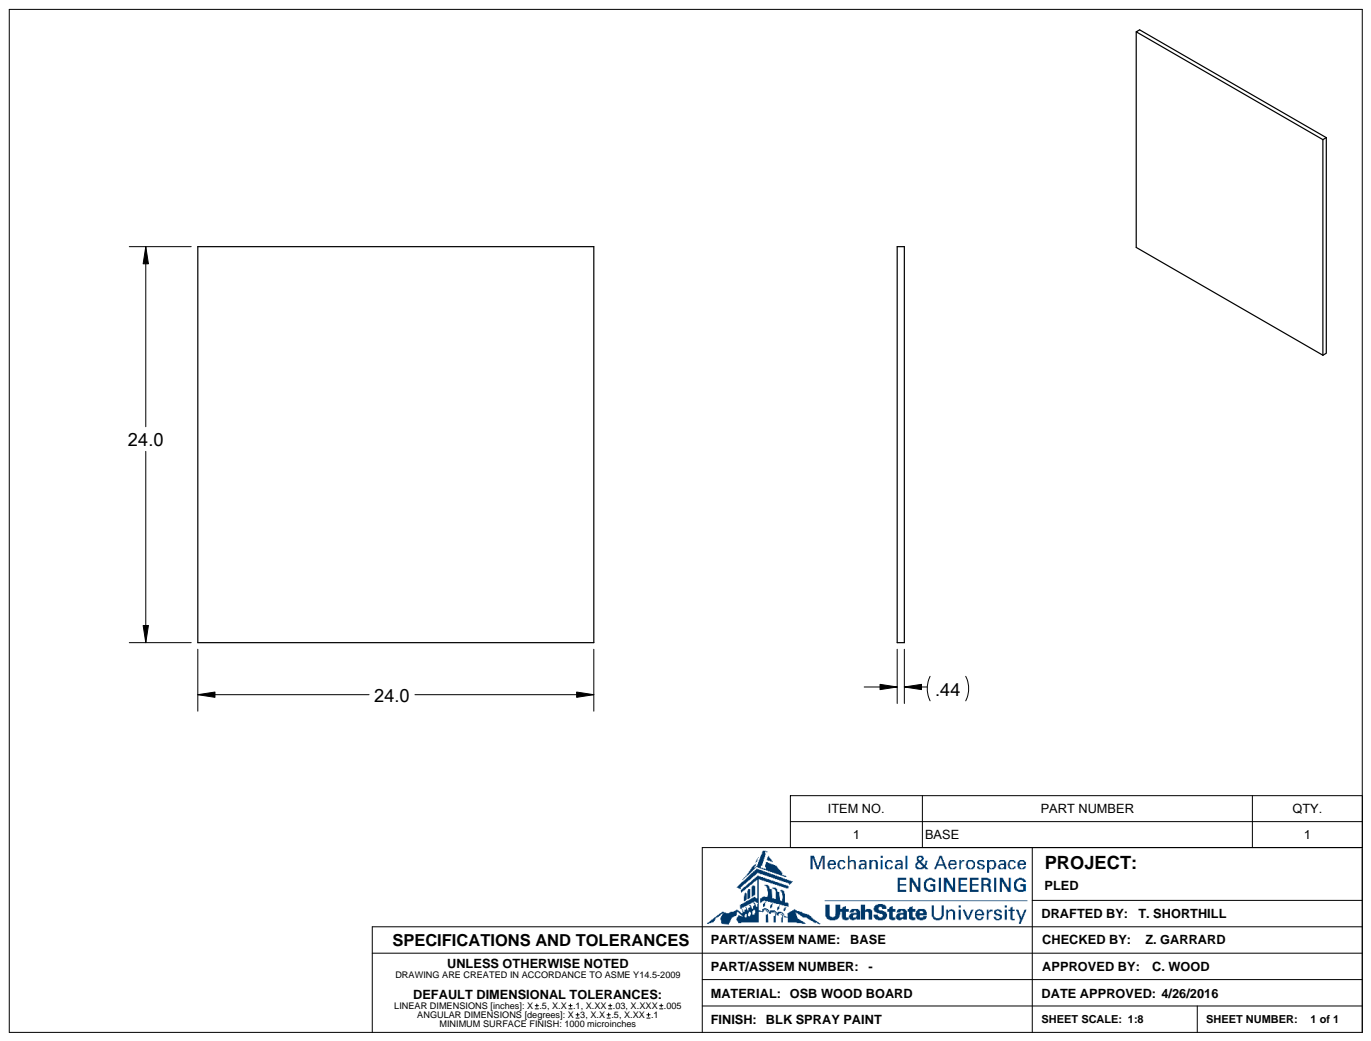
[picture p262: page 15]

PROJECT:
PLED
DRAFTED BY: T. SHORTHILL

SPECIFICATIONS AND TOLERANCES | PART/ASSEM NAME: BASE | CHECKED BY: Z. GARRARD

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

OSB WOOD BOARD
BLK SPRAY PAINT | 1:8 | 1 of 1

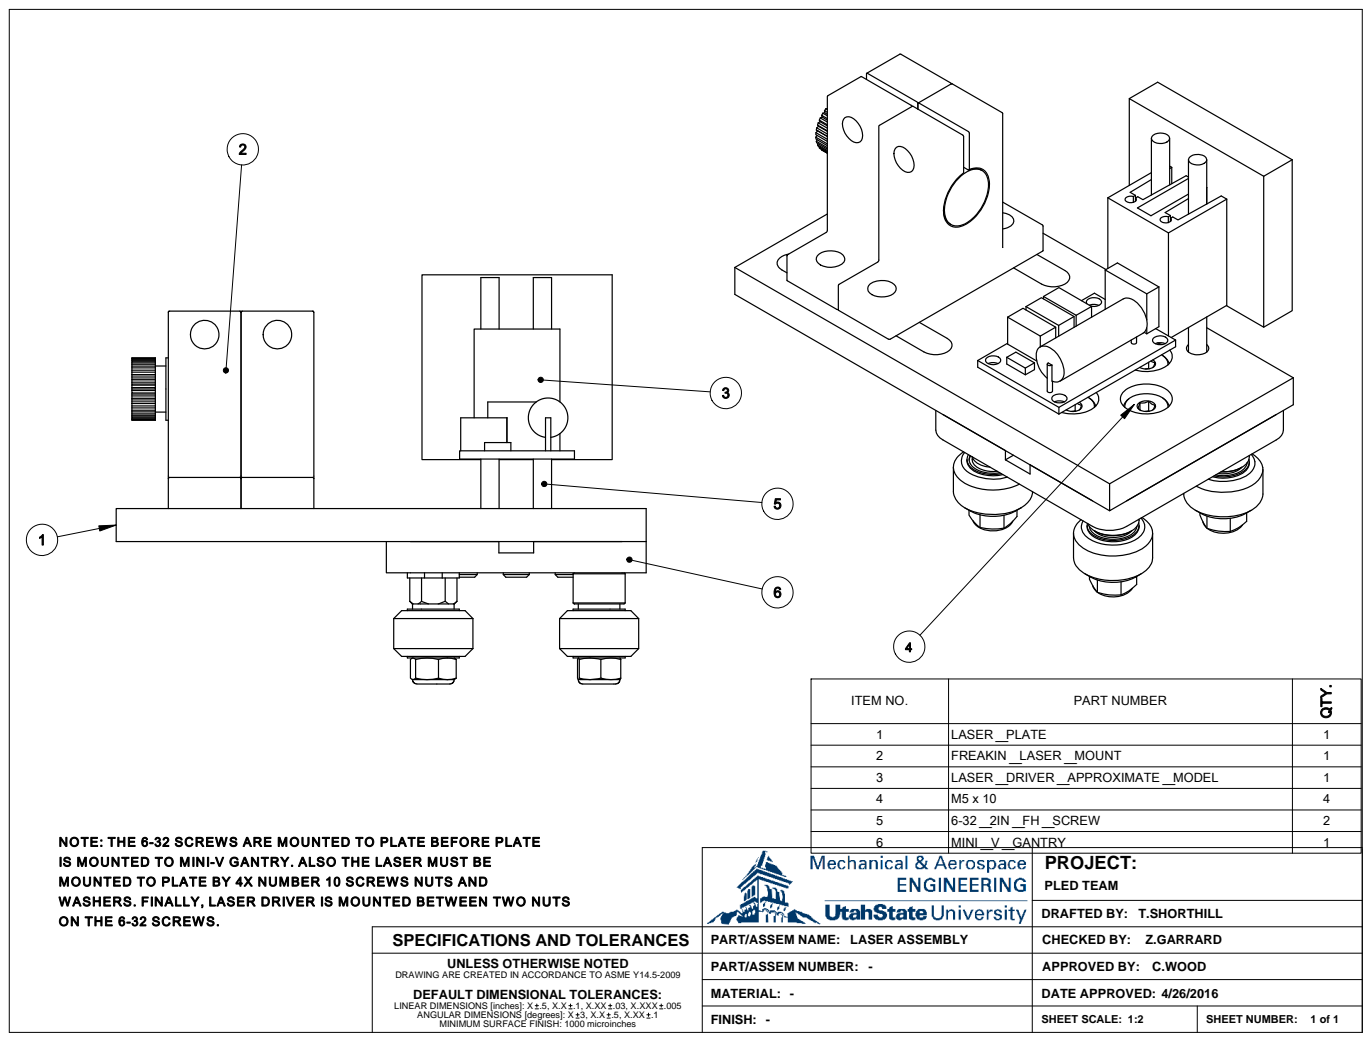
[picture p263: page 16]
PROJECT:; SHEET NUMBER:; PLED TEAM; SHEET SCALE:; DRAFTED BY:; T.SHORTHILL

SPECIFICATIONS AND TOLERANCES | PART/ASSEM NAME: LASER ASSEMBLY | CHECKED BY: Z.GARRARD
UNLESS OTHERWISE NOTED DRAWING ARE CREATED IN ACCORDANCE TO ASME Y14.5-2009 | PART/ASSEM NUMBER: - | C.WOOD APPROVED BY:

ITEM NO. | PART NUMBER | Q T Y
1 | V-SLOT_600 | 4
2 | Motor Mount Plate Nema 17 | 1
3 | Double Tee Nut | 8
4 | Flexible Coupling 5mm x 6mm | 1
5 | GT2 Timing Pulley 30 Tooth | 3
6 | MOD_NEMA_17_MOUNT_PLATE | 1
7 | NEMA_17_MOTOR | 2
8 | V-SLOT_670 | 1
9 | PRINT_AREA | 1
10 | Idler Pulley Plate | 1
11 | Slot Washer 15 x 5 x 2 | 2
12 | Ball Bearing 5 x 16 x 5 | 3
13 | Smooth Idler Pulley Wheel | 1
14 | Nylon Spacer 0.125in | 1
15 | Precision Shim 8 x 5 x 1 | 25
16 | Nylon Insert Lock Nut M5 | 13
17 | M5 x 8 | 24
18 | BEARING_PLATE | 1
19 | Encoder_Plate | 2
20 | ENCODER | 2
21 | PULLEY_6MM | 2
22 | M5 x 10 | 8
23 | SHAFT_5mm | 1
24 | V-SLOT_LEGS | 4
25 | L Bracket Single | 8
26 | Tee Nut | 28
27 | M5 x 25 | 13
28 | Delrin Mini V Wheel | 12
29 | Ball Bearing 5 x 10 x 4.2 | 24
30 | Mini Eccentric Spacer 6mm | 6
31 | Aluminum Spacer 6mm | 6
32 | MOD_MINI_V_PLATE | 2
33 | ZINC PLATED STEEL 2.5 INCH L- BRACKET | 4
34 | Self Tapping Screw | 4
35 | BASE | 1
36 | LASER_PLATE | 1
37 | LASER_MOUNT | 2
38 | FREAKIN_LASER | 1
39 | LASER_DRIVER_APPROXIMATE_MODEL | 1
40 | 6-32_2IN_FH_SCREW | 2
41 | Mini V Wheel Plate | 1
42 | M3 FLAT HEAD SCREWS (ENCODERS) | 6
43 | M3 SHC SCREW (MOTORS) | 8
44 | 10-32 SCREWS (LASER MOUNT) | 4
45 | 10-32 NUTS/ WASHERS | 4
46 | 10-32 SELF TAPPING SCREWS 1 INCH LONG | 4

### THIS SHEET INCLUDES THE TOTAL PARTS LIST. (PARTS ORDERED INCLUDE SUB-PARTS WHICH ARE ALSO INCLUDED IN THIS LIST. EXAMPLE: WE ORDERED A WHEEL BUT EACH WHEEL INCLUDED BEARINGS, SHIMS AND WASHERS.)

ITEM NO. | PART NAME | QTY
1 V-SLOT_600 | 4
2 MOTOR_MOUNT | 1
MOD_NEMA_17_MOUNT_PLATE | 1
Double Tee Nut | 1
Flexible Coupling 5mm x 6mm | 1
GT2 Timing Pulley 30 Tooth | 1
M5 x 8 | 2
NEMA_17_MOTOR | 1
3 V-SLOT_670 | 1
4 PRINT_AREA | 1
5 FREE_IDLER_PULLEY | 1
Idler Pulley Plate | 1
Double Tee Nut | 1
Slot Washer 15 x 5 x 2 | 2
Ball Bearing 5 x 16 x 5 | 2
Smooth Idler Pulley Wheel | 1
Nylon Spacer 0.125in | 1
Precision Shim 8 x 5 x 1 | 1
Nylon Insert Lock Nut M5 | 1
M5 x 25 | 1
M5 x 8 | 2
6 MOTOR_MOUNT_2 | 1
Motor Mount Plate Nema 17 | 1
Double Tee Nut | 1
GT2 Timing Pulley 30 Tooth | 1
M5 x 8 | 2
NEMA_17_MOTOR | 1
7 BEARING_MOUNT | 1
BEARING_PLATE | 1
Double Tee Nut | 1
Ball Bearing 5 x 16 x 5 | 1
M5 x 8 | 2
8 ENCODER_MOUNT | 2
Encoder_Plate | 1
ENCODER | 1
Double Tee Nut | 1
PULLEY_6MM | 1
M5 x 8 | 2
9 SHAFT_5mm | 1
10 GT2 Timing Pulley 30 Tooth | 1
11 V-SLOT_LEGS | 4
12 CORNER_BRACKETS | 8
L Bracket Single | 1
Tee Nut | 2
13 MOD_MINI_V_GANTRY_ASSEMBLY | 2
MOD_MINI_V_GANTRY | 1
M5 x 25 | 4
Delrin Mini V Wheel | 2
Delrin Mini V Wheel | 1
Ball Bearing 5 x 10 x 4.2 | 2
Precision Shim 8 x 5 x 1 | 2

### THIS SHEET SHOWS ALL THE PARTS WITHIN EACH ITEM OR SUB-ASSEMBLY

### Nylon Insert Lock Nut M5 Aluminum Spacer 6mm

1

### Delrin Mini V Wheel

2

### Delrin Mini V Wheel

1

### Ball Bearing 5 x 10 x 4.2

2

### Precision Shim 8 x 5 x 1

2

### Nylon Insert Lock Nut M5

1

### Mini Eccentric Spacer 6mm

1

### MOD_MINI_V_PLATE

1

### Double Tee Nut

1
M5 x 10

2

### 14 L_BRACKET_ASSEMBLY

2

### ZINC PLATED STEEL 2.5 INCH L- BRACKET

1

### Self Tapping Screw

1

### Tee Nut

3
M5 x 8

3

### 15 L_BRACKET_ASSEMBLY_REVERSE

2

### ZINC PLATED STEEL 2.5 INCH L- BRACKET

1

### Self Tapping Screw

1

### Tee Nut

3
M5 x 8

3

### 16 BASE

1

### 17 LASER_ASSEMBLY

1

### LASER_PLATE

1

### FREAKIN_LASER_MOUNT

1

### LASER_MOUNT

2

### FREAKIN_LASER

1

### LASER_DRIVER_APPROXIMATE_MODEL

1

### 6-32_2IN_FH_SCREW

2

### MINI_V_GANTRY

1
M5 x 25

4

### Mini V Wheel Plate

1

### Delrin Mini V Wheel

2

### Delrin Mini V Wheel

1

### Ball Bearing 5 x 10 x 4.2

2

### Precision Shim 8 x 5 x 1

2

### Nylon Insert Lock Nut M5

1

### Aluminum Spacer 6mm

1

### Delrin Mini V Wheel

2

### Delrin Mini V Wheel

1

### Ball Bearing 5 x 10 x 4.2

2

### Precision Shim 8 x 5 x 1

2

### Nylon Insert Lock Nut M5

1

### Mini Eccentric Spacer 6mm

1
M5 x 10

4
