JNCox55/PLED/Documentation/Schematic/Schematic.pdf

## TB6560 DRIVER

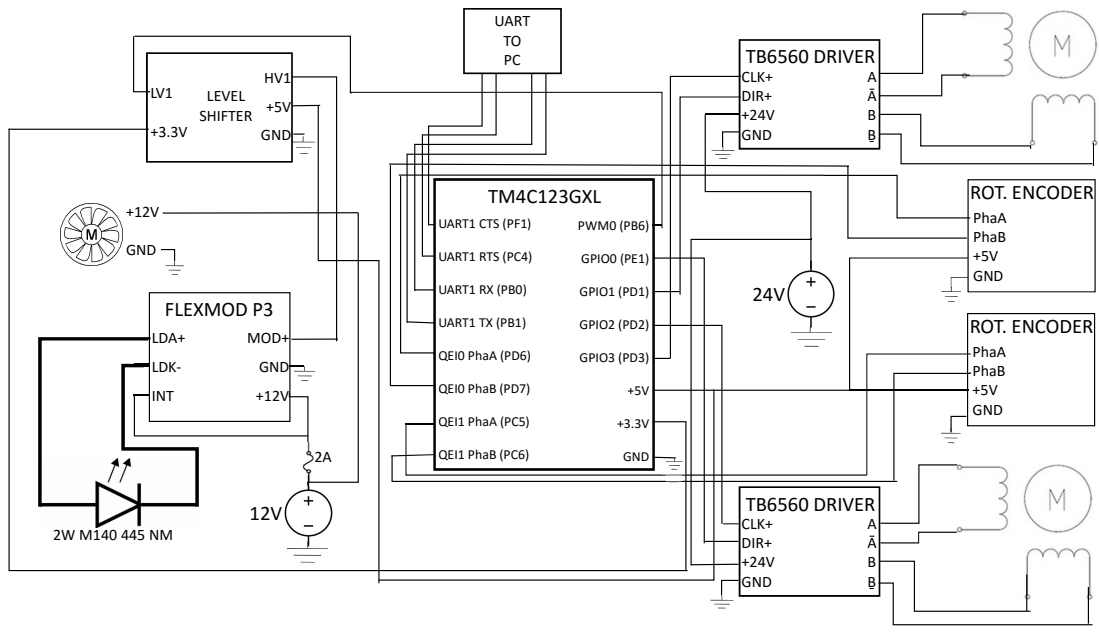
[picture p264: page 1]
CLK+ DIR+ +24V GND; TB6560 DRIVER A Ā B Ḇ; TM4C123GXL PWM0 (PB6) GPIO0 (PE1) GPIO1 (PD1) GPIO2 (PD2) GPIO3 (PD3) +5V +3.3V GND; UART1 CTS (PF1) UART1 RTS (PC4) UART1 RX (PB0) UART1 TX (PB1) QEI0 PhaA (PD6) QEI0 PhaB (PD7) QEI1 PhaA (PC5) QEI1 PhaB (PC6); ROT. ENCODER PhaA PhaB +5V GND ROT. ENCODER PhaA PhaB +5V GND; UART TO PC; FLEXMOD P3 MOD+ GND +12V; LDA+ LDK- INT; LEVEL SHIFTER; HV1 +5V GND; +12V GND
