JNCox55/PLED/Mechanical/PLED_TEAM-4-28/PLED_TEAM-4-28/PLED_FINAL_MECHANICAL_FILES/MANUFACTURE/MANUFACTURED_PARTS_PDFs/DRW_BASE.pdf

PROJECT:
PLED
DRAFTED BY: T. SHORTHILL

SPECIFICATIONS AND TOLERANCES | PART/ASSEM NAME: BASE | CHECKED BY: Z. GARRARD

UNLESS OTHERWISE NOTED DRAWING ARE CREATED IN ACCORDANCE TO ASME Y14.5-2009 DEFAULT DIMENSIONAL TOLERANCES: LINEAR DIMENSIONS [inches]: X .5, X.X .1, X.XX .03, X.XXX .005 ANGULAR DIMENSIONS [degrees]: X 3, X.X .5, X.XX .1 MINIMUM SURFACE FINISH: 1000 microinches | PART/ASSEM NUMBER: - | C. WOOD APPROVED BY:

MATERIAL: OSB WOOD BOARD | DATE APPROVED: 4/26/2016
FINISH: BLK SPRAY PAINT | SHEET SCALE: 1:8 | SHEET NUMBER: 1 of 1
