JNCox55/PLED/Mechanical/PLED_TEAM-4-28/PLED_TEAM-4-28/PLED_FINAL_MECHANICAL_FILES/MANUFACTURE/MANUFACTURED_PARTS_PDFs/DRW_BEARING_PLATE.pdf

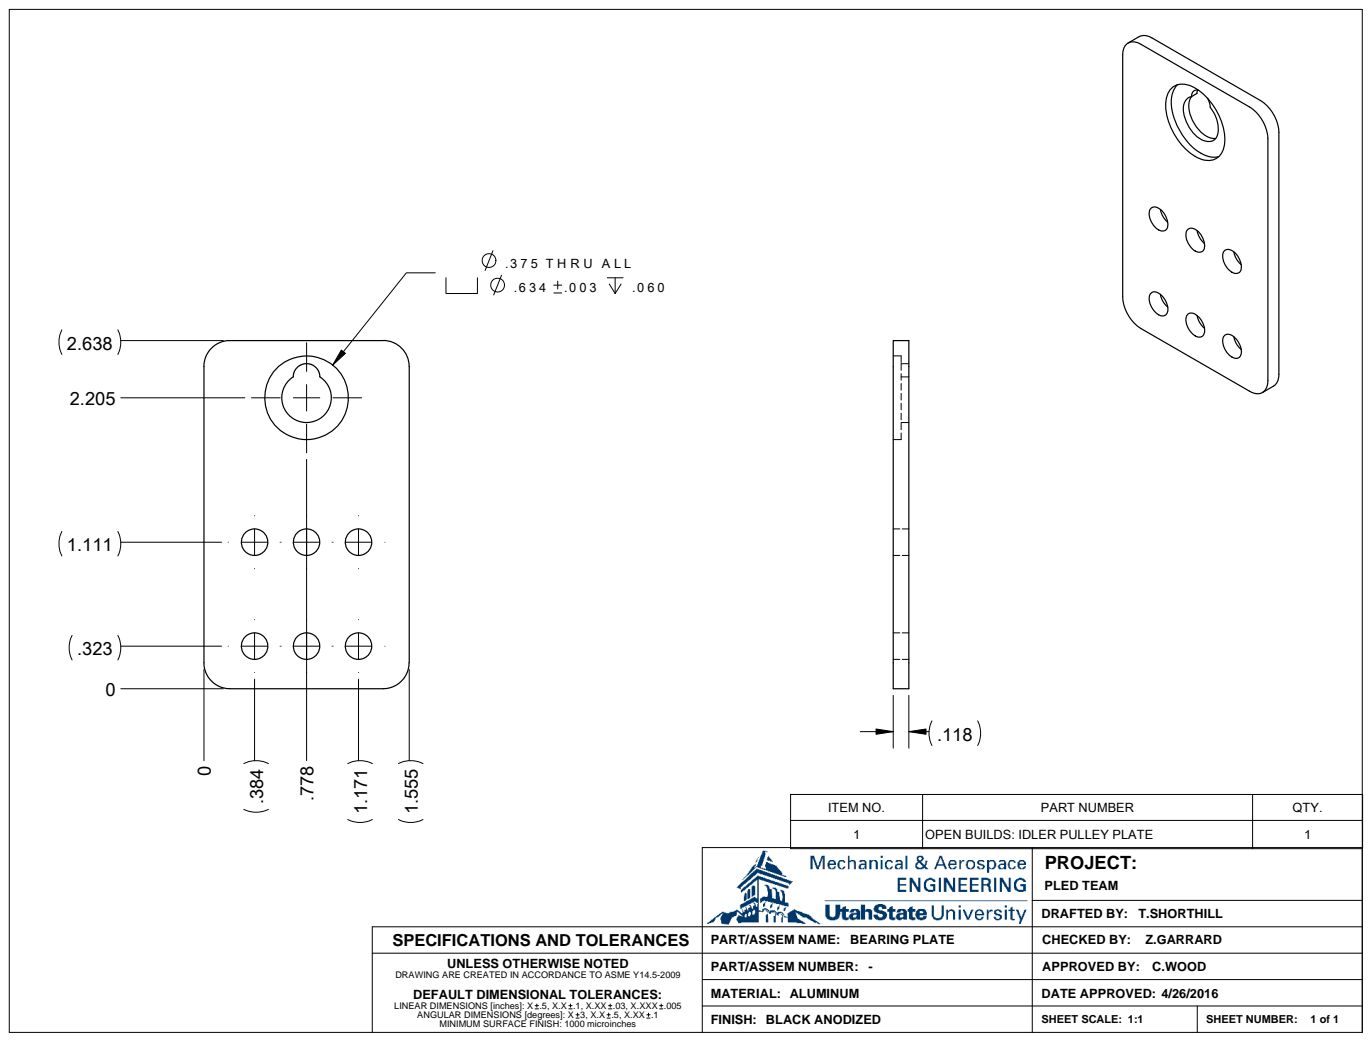
[picture p265: page 1]
PROJECT:; DRAFTED BY:; PLED TEAM; T.SHORTHILL

SPECIFICATIONS AND TOLERANCES | PART/ASSEM NAME: BEARING PLATE | CHECKED BY: Z.GARRARD

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

MATERIAL: ALUMINUM | DATE APPROVED: 4/26/2016

FINISH: BLACK ANODIZED | SHEET SCALE: 1:1 | SHEET NUMBER: 1 of 1
