JNCox55/PLED/Mechanical/PLED_TEAM-4-28/PLED_TEAM-4-28/PLED_FINAL_MECHANICAL_FILES/SolidWorks_OpenBuilds2/PDF Drawings/8mm Acme Nut Block.PDF

Tr 8X8-2 THRU ALL

TITLE: 8mm Acme Nut Block

PART# 740 | MATERIAL: PTFE filled Delrin
