JNCox55/PLED/Mechanical/PLED_TEAM-4-28/PLED_TEAM-4-28/PLED_FINAL_MECHANICAL_FILES/SolidWorks_OpenBuilds2/PDF Drawings/8mm Acme Nut Plate.PDF

TITLE: 8mm Acme Nut Plate

PART# 855 | MATERIAL: PTFE Filled Delrin

Tr 8X8-2 THRU ALL
