JNCox55/PLED/Mechanical/PLED_TEAM-4-28/PLED_TEAM-4-28/PLED_FINAL_MECHANICAL_FILES/SolidWorks_OpenBuilds2/PDF Drawings/Aluminum Spacers.PDF

Length | Part#
1/8" | 825
1/4" | 15
1-1/2" | 80
3mm | 175
6mm | 90
9mm | 225
20mm | 65
35mm | 1040
40mm | 95

TITLE: Aluminum Spacers

PART# | MATERIAL: Aluminum
