JNCox55/PLED/Mechanical/PLED_TEAM-4-28/PLED_TEAM-4-28/PLED_FINAL_MECHANICAL_FILES/SolidWorks_OpenBuilds2/PDF Drawings/C-Beam Gantry Plate.PDF

8X M5X0.8 THRU ALL; 17X 5.10 THRU; SECTION A-A

TITLE: C-Beam Gantry Plate

PART# 970 | MATERIAL: Aluminum
