JNCox55/PLED/Mechanical/PLED_TEAM-4-28/PLED_TEAM-4-28/PLED_FINAL_MECHANICAL_FILES/SolidWorks_OpenBuilds2/PDF Drawings/Eccentric Spacer 0.25in.PDF

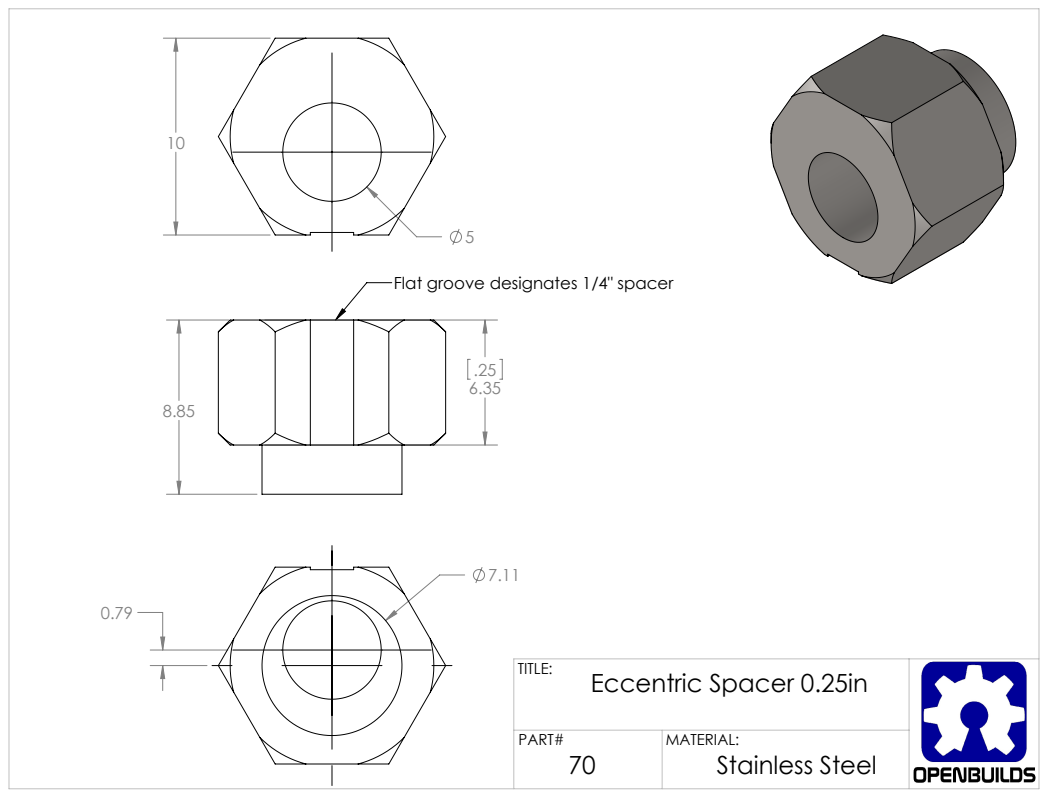
[picture p271: page 1]

Flat groove designates 1/4" spacer

TITLE: Eccentric Spacer 0.25in

PART# 70 | MATERIAL: Stainless Steel
