JNCox55/PLED/Mechanical/PLED_TEAM-4-28/PLED_TEAM-4-28/PLED_FINAL_MECHANICAL_FILES/SolidWorks_OpenBuilds2/PDF Drawings/Eccentric Spacer 6mm.PDF

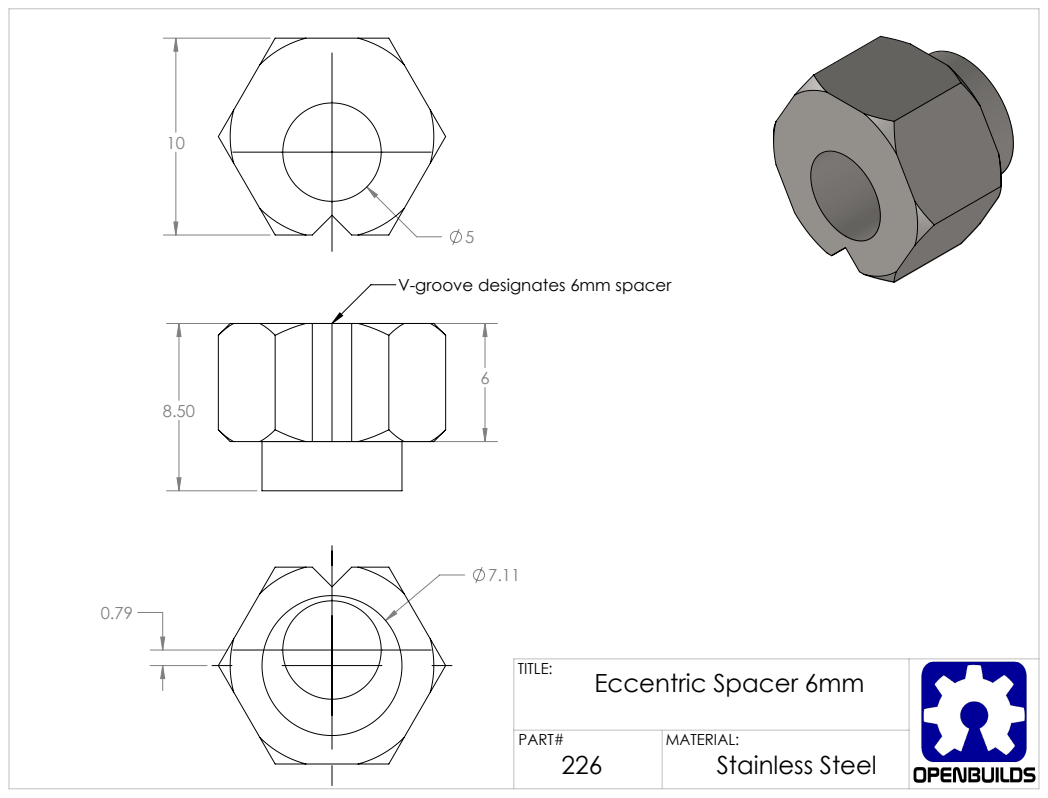
[picture p272: page 1]

V-groove designates 6mm spacer

TITLE: Eccentric Spacer 6mm

PART# 226 | MATERIAL: Stainless Steel
