JNCox55/PLED/Mechanical/PLED_TEAM-4-28/PLED_TEAM-4-28/PLED_FINAL_MECHANICAL_FILES/SolidWorks_OpenBuilds2/PDF Drawings/Idler Pulley Plate.PDF

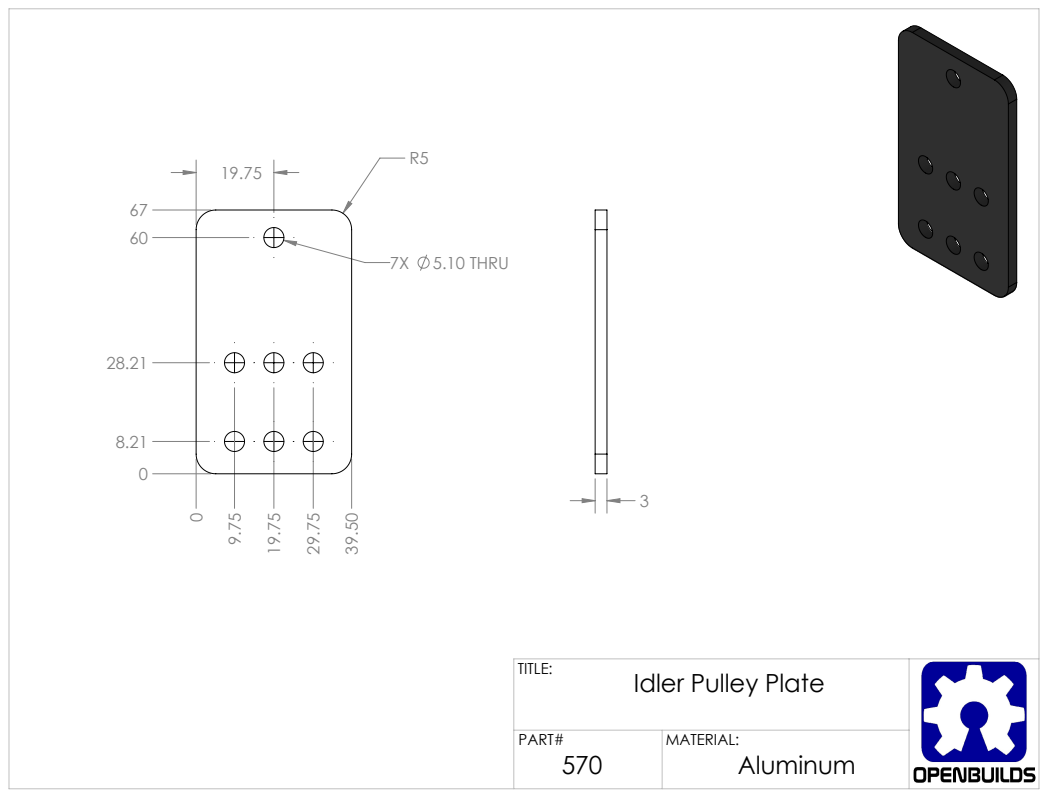
[picture p273: page 1]
7X 5.10 THRU

TITLE: Idler Pulley Plate

PART# 570 | MATERIAL: Aluminum
