JNCox55/PLED/Mechanical/PLED_TEAM-4-28/PLED_TEAM-4-28/PLED_FINAL_MECHANICAL_FILES/SolidWorks_OpenBuilds2/PDF Drawings/Joining Strip Plate 2 Hole.PDF

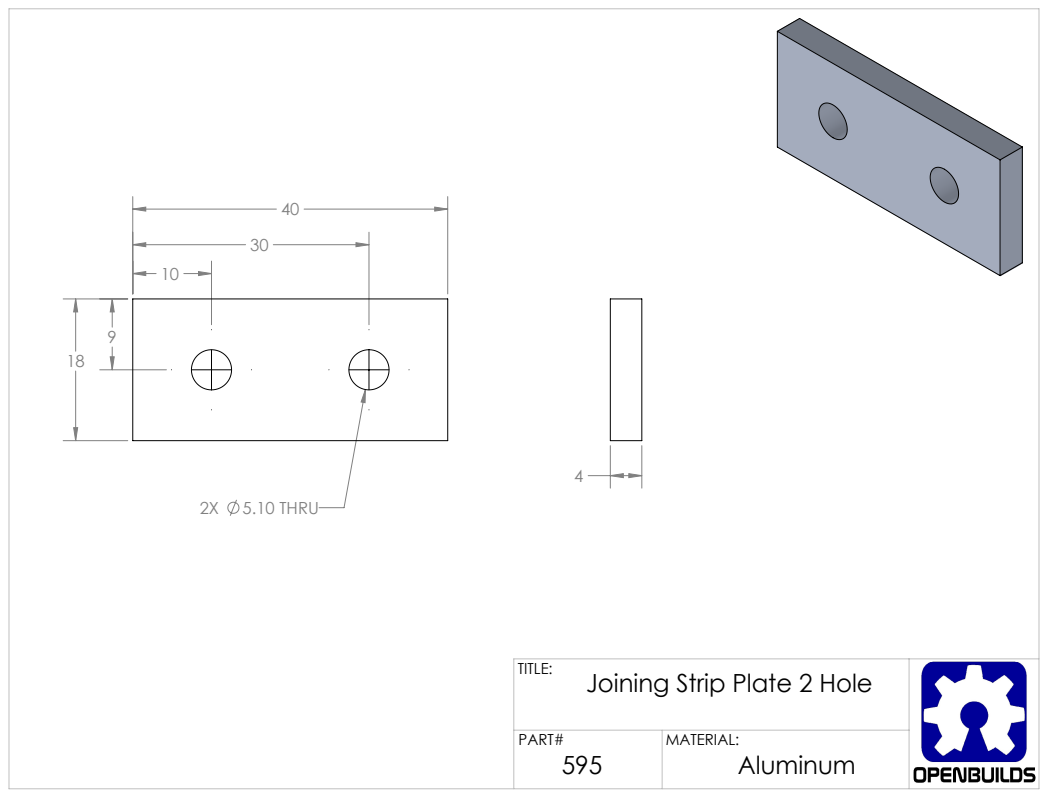
[picture p274: page 1]
2X 5.10 THRU

TITLE: Joining Strip Plate 2 Hole

PART# 595 | MATERIAL: Aluminum
