JNCox55/PLED/Mechanical/PLED_TEAM-4-28/PLED_TEAM-4-28/PLED_FINAL_MECHANICAL_FILES/SolidWorks_OpenBuilds2/PDF Drawings/Joining Strip Plate 3 Hole.PDF

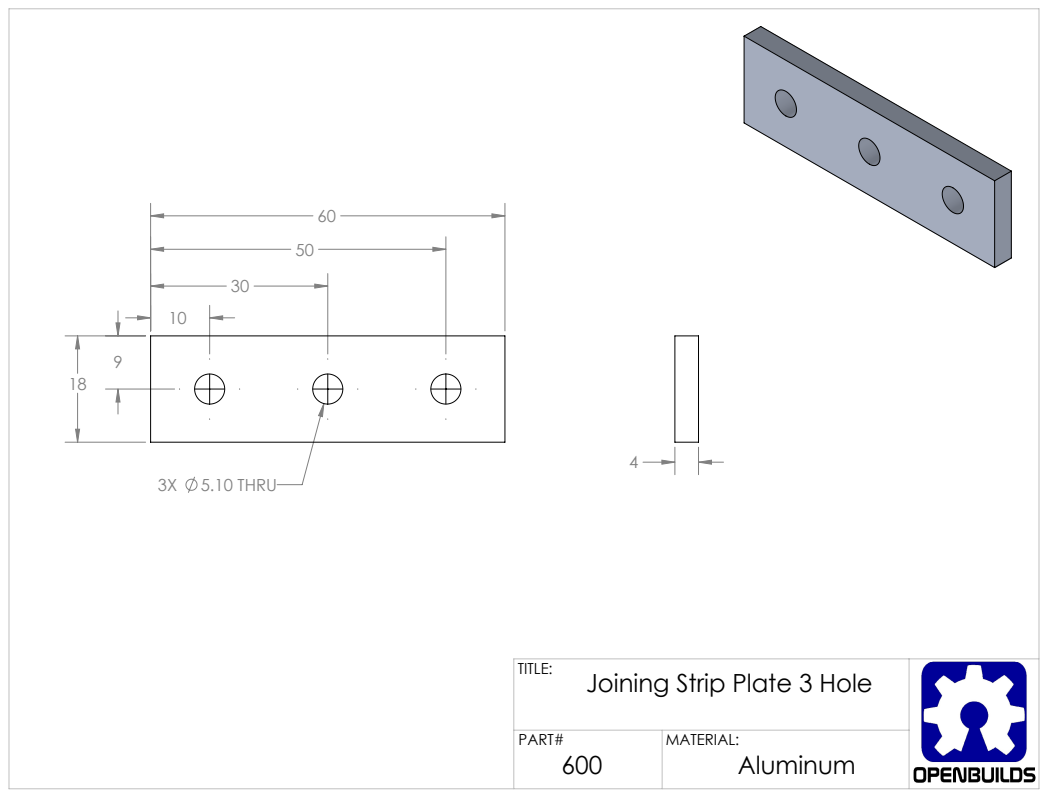
[picture p275: page 1]
3X 5.10 THRU

TITLE: Joining Strip Plate 3 Hole

PART# 600 | MATERIAL: Aluminum
