JNCox55/PLED/Mechanical/PLED_TEAM-4-28/PLED_TEAM-4-28/PLED_FINAL_MECHANICAL_FILES/SolidWorks_OpenBuilds2/PDF Drawings/Linear Actuator End Mount.PDF

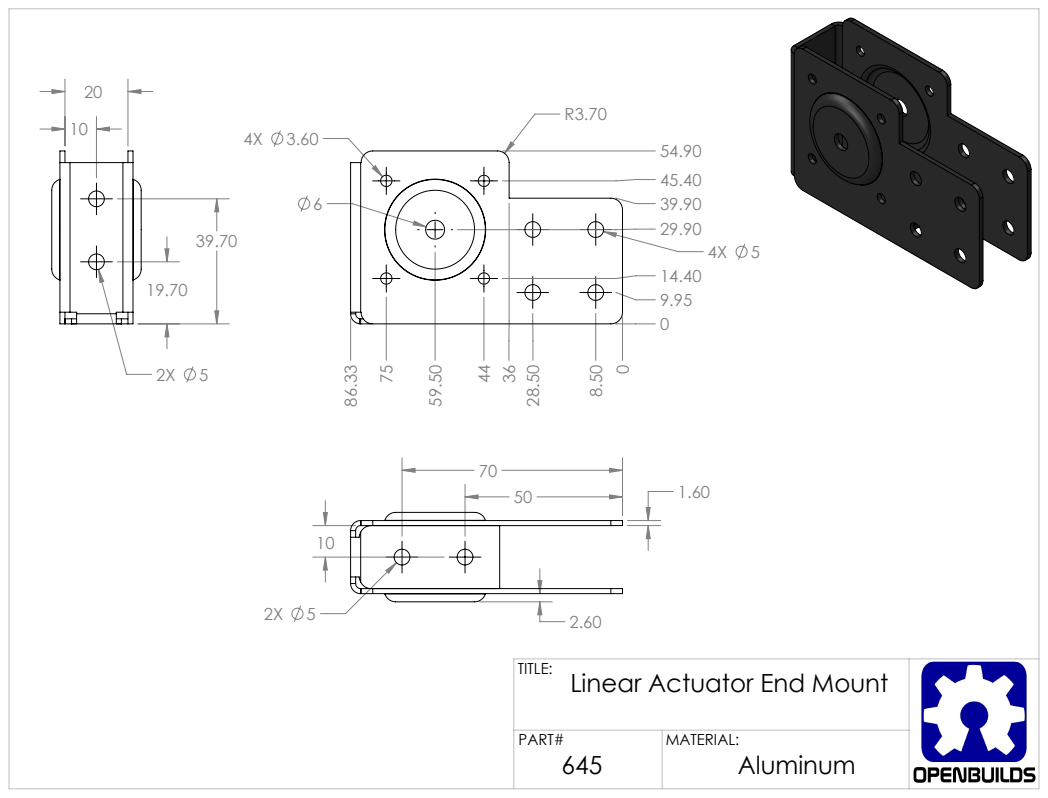
[picture p276: page 1]

TITLE: Linear Actuator End Mount

PART# 645 | MATERIAL: Aluminum
