JNCox55/PLED/Mechanical/PLED_TEAM-4-28/PLED_TEAM-4-28/PLED_FINAL_MECHANICAL_FILES/SolidWorks_OpenBuilds2/PDF Drawings/Micro Limit Switch Plate.PDF

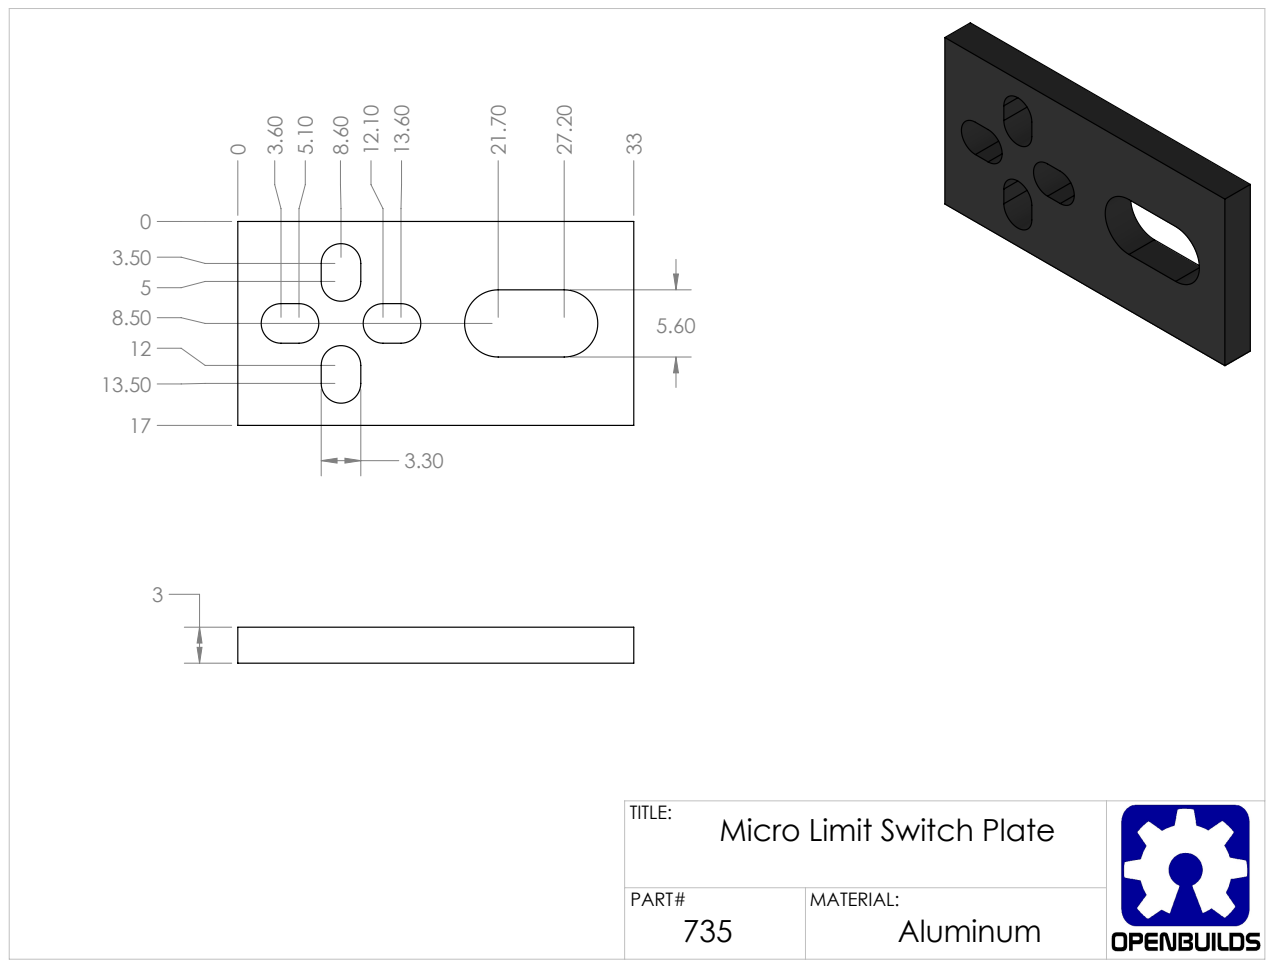
[picture p277: page 1]

TITLE: Micro Limit Switch Plate

PART# 735 | MATERIAL: Aluminum
