JNCox55/PLED/Mechanical/PLED_TEAM-4-28/PLED_TEAM-4-28/PLED_FINAL_MECHANICAL_FILES/SolidWorks_OpenBuilds2/PDF Drawings/Mini Eccentric Spacer 0.25in.PDF

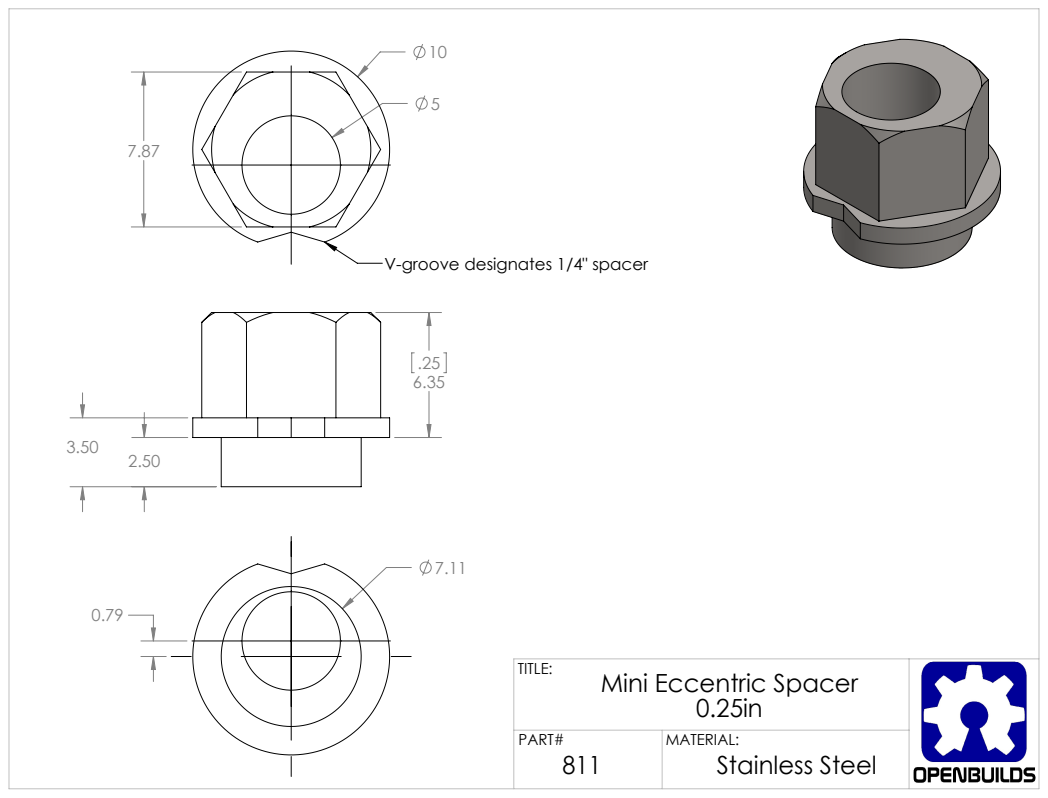
[picture p278: page 1]

V-groove designates 1/4" spacer

TITLE: Mini Eccentric Spacer 0.25in

PART# 811 | MATERIAL: Stainless Steel
