JNCox55/PLED/Mechanical/PLED_TEAM-4-28/PLED_TEAM-4-28/PLED_FINAL_MECHANICAL_FILES/SolidWorks_OpenBuilds2/PDF Drawings/Mini Eccentric Spacer 6mm.PDF

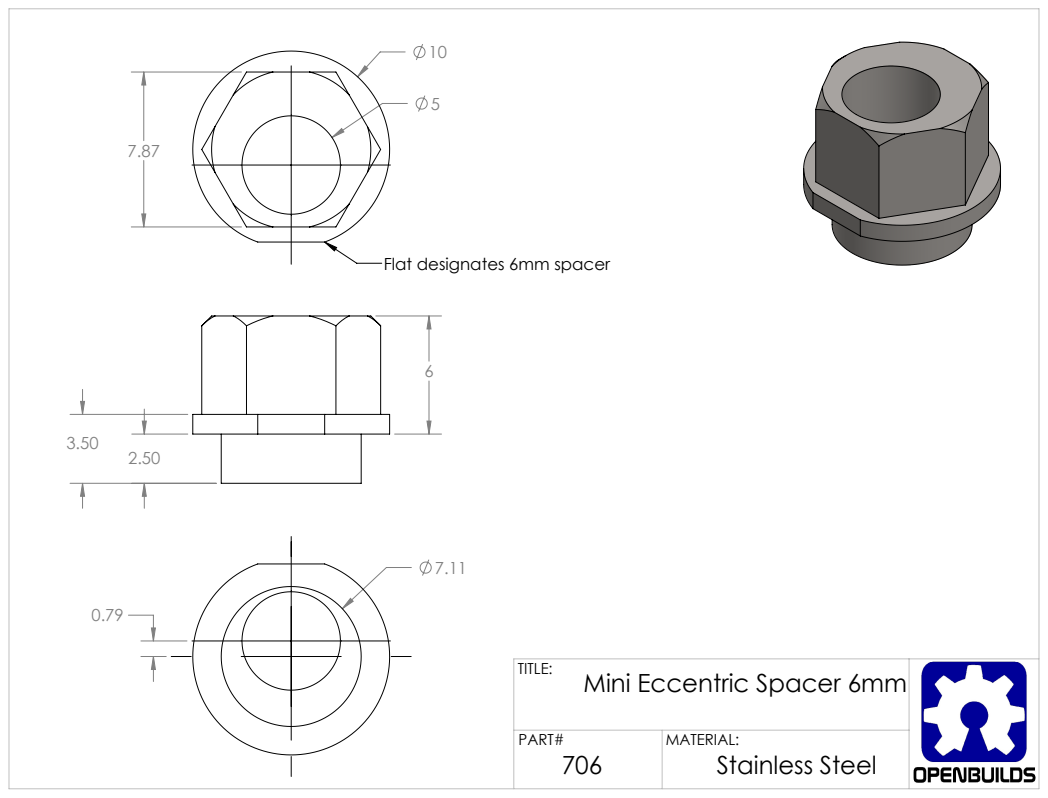
[picture p279: page 1]

Flat designates 6mm spacer

TITLE: Mini Eccentric Spacer 6mm

PART# 706 | MATERIAL: Stainless Steel
