JNCox55/PLED/Mechanical/PLED_TEAM-4-28/PLED_TEAM-4-28/PLED_FINAL_MECHANICAL_FILES/SolidWorks_OpenBuilds2/PDF Drawings/Mini V Wheel Plate.PDF

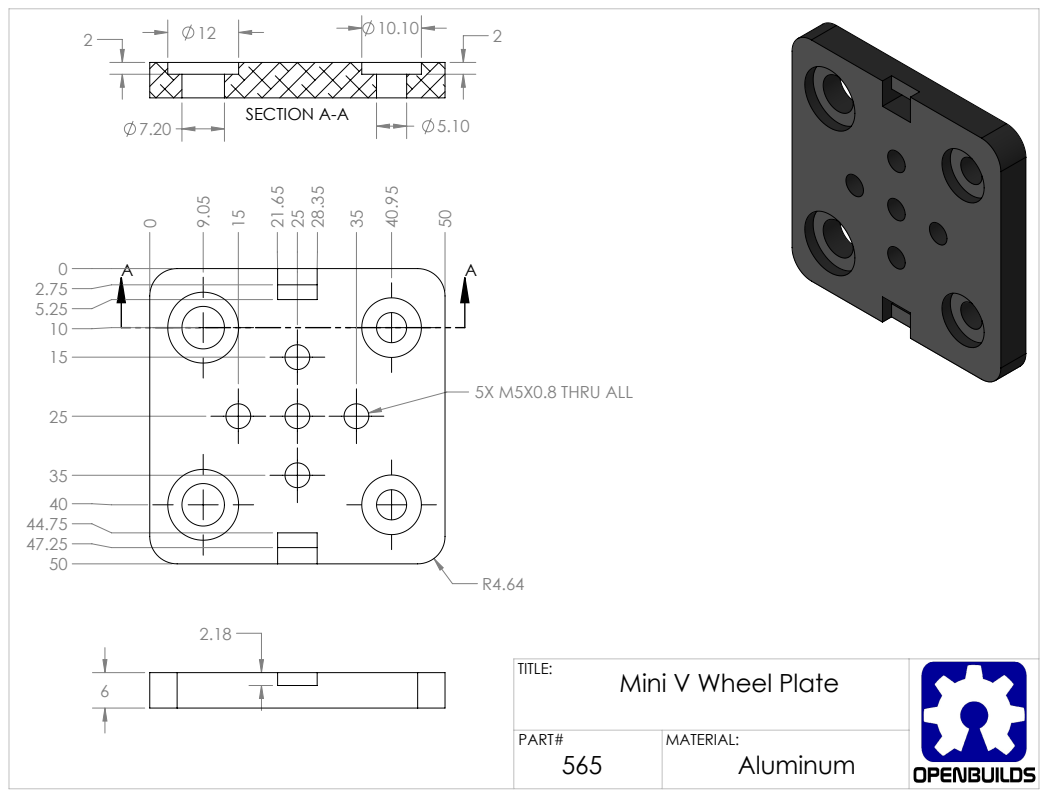
[picture p280: page 1]
5X M5X0.8 THRU ALL; 5.10 SECTION A-A

TITLE: Mini V Wheel Plate

PART# 565 | MATERIAL: Aluminum
