JNCox55/PLED/Mechanical/PLED_TEAM-4-28/PLED_TEAM-4-28/PLED_FINAL_MECHANICAL_FILES/SolidWorks_OpenBuilds2/PDF Drawings/Mini V Wheel.PDF

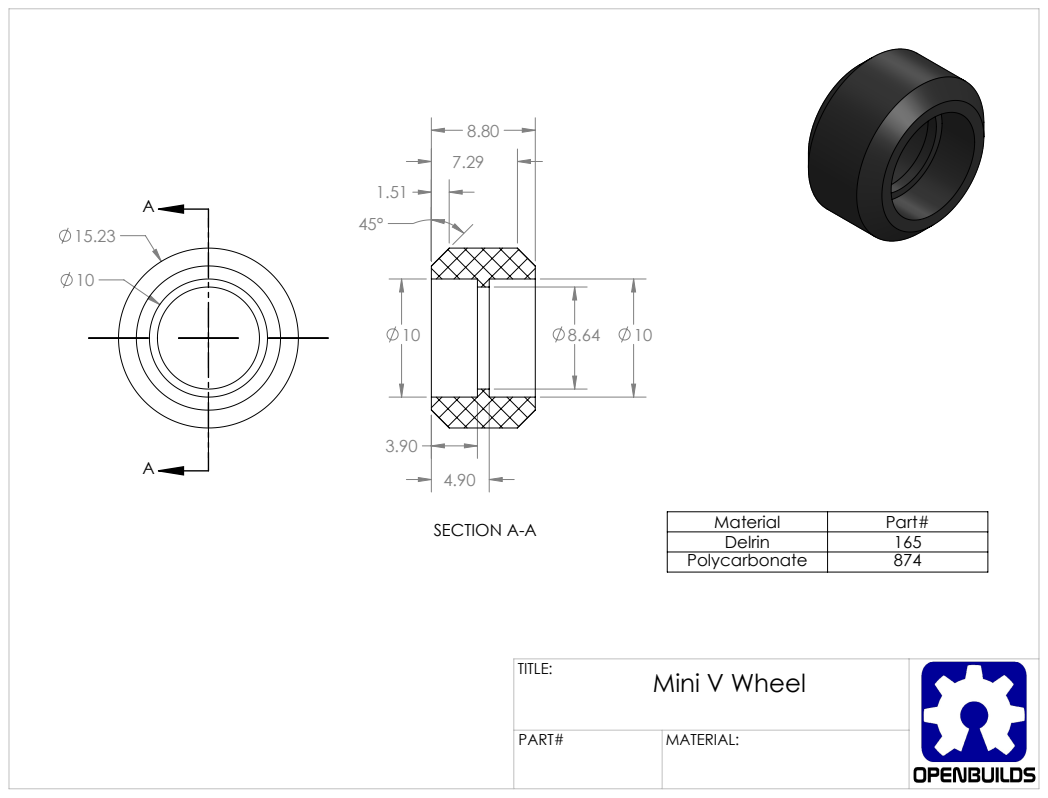
[picture p281: page 1]
SECTION A-A; Material; Part#

Delrin | 165
Polycarbonate | 874

TITLE: Mini V Wheel

PART# | MATERIAL:
