JNCox55/PLED/Mechanical/PLED_TEAM-4-28/PLED_TEAM-4-28/PLED_FINAL_MECHANICAL_FILES/SolidWorks_OpenBuilds2/PDF Drawings/Motor Mount Plate Nema 17.PDF

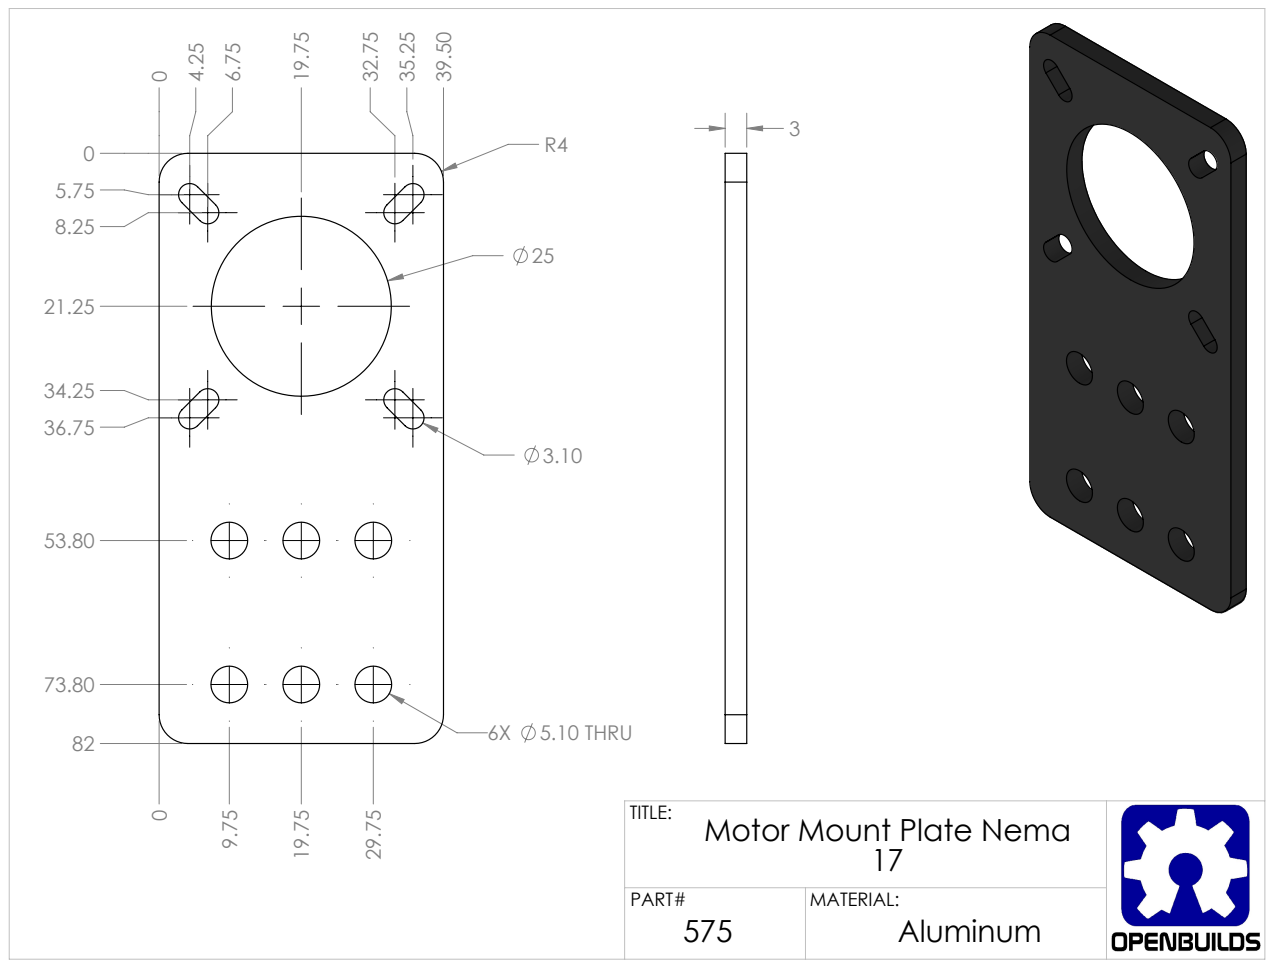
[picture p282: page 1]
6X 5.10 THRU

TITLE: Motor Mount Plate Nema 17

PART# 575 | MATERIAL: Aluminum
