JNCox55/PLED/Mechanical/PLED_TEAM-4-28/PLED_TEAM-4-28/PLED_FINAL_MECHANICAL_FILES/SolidWorks_OpenBuilds2/PDF Drawings/Motor Mount Plate Nema 23.PDF

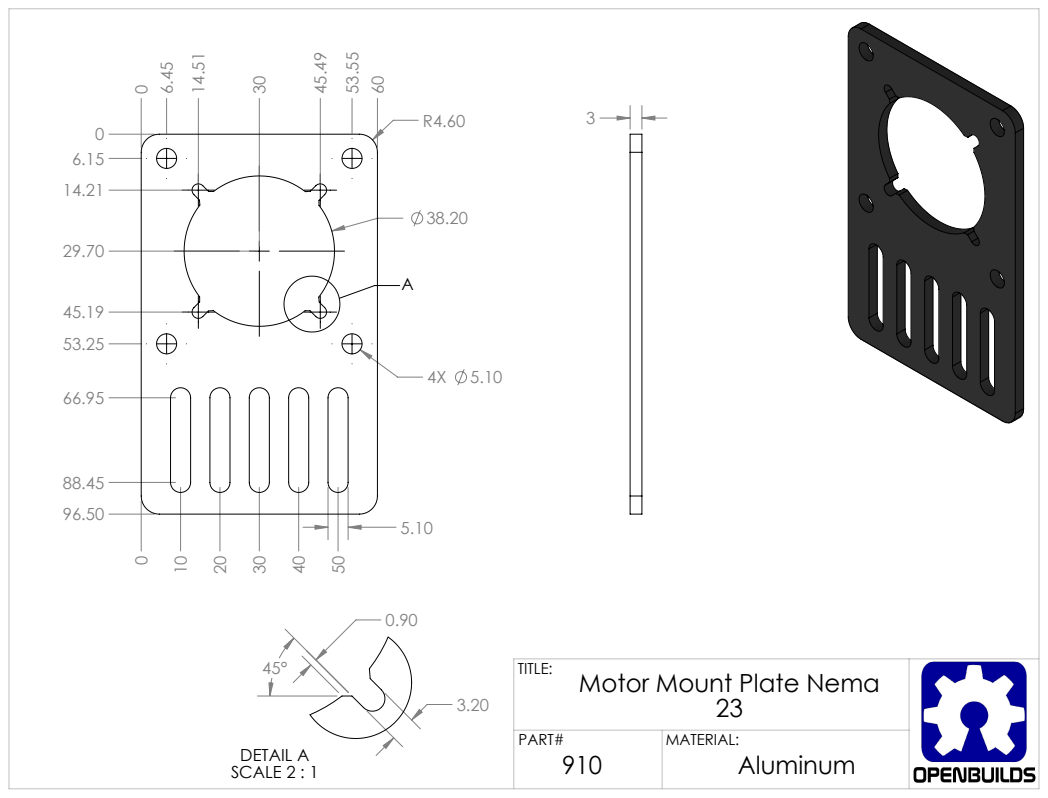
[picture p283: page 1]
DETAIL A SCALE 2 : 1

TITLE: Motor Mount Plate Nema 23

PART# 910 | MATERIAL: Aluminum
