JNCox55/PLED/Mechanical/PLED_TEAM-4-28/PLED_TEAM-4-28/PLED_FINAL_MECHANICAL_FILES/SolidWorks_OpenBuilds2/PDF Drawings/Mounting Hub 5mm.PDF

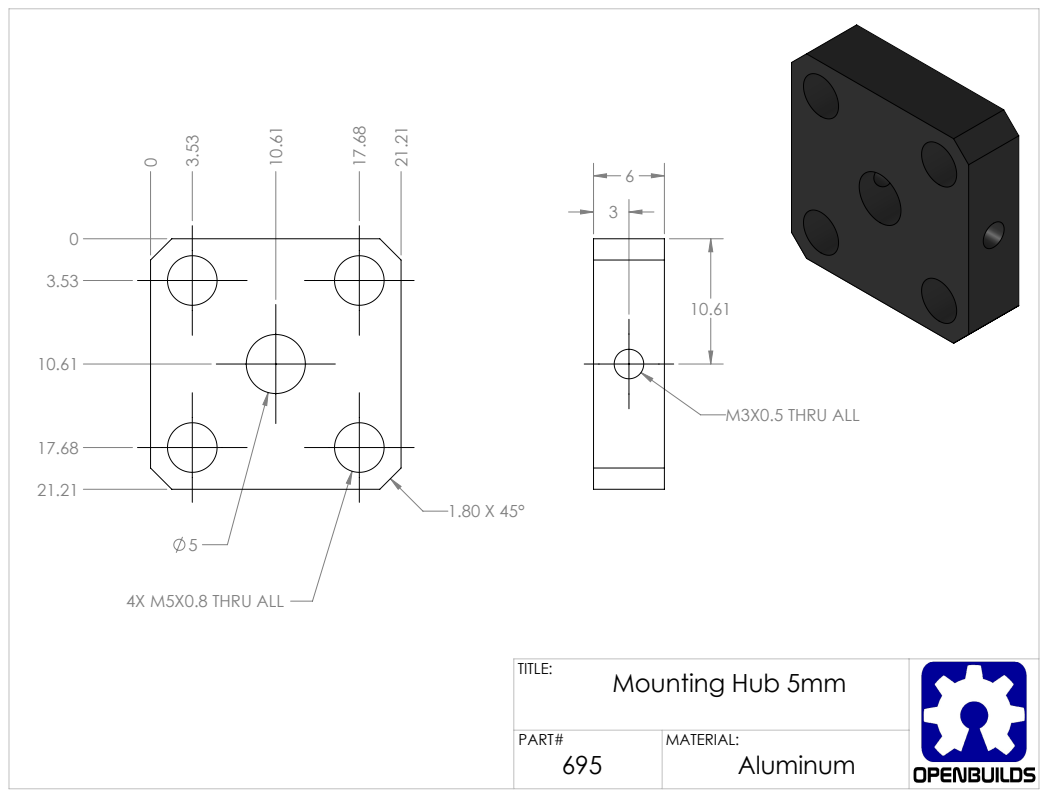
[picture p284: page 1]
4X M5X0.8 THRU ALL; M3X0.5 THRU ALL

TITLE: Mounting Hub 5mm

PART# 695 | MATERIAL: Aluminum
