JNCox55/PLED/Mechanical/PLED_TEAM-4-28/PLED_TEAM-4-28/PLED_FINAL_MECHANICAL_FILES/SolidWorks_OpenBuilds2/PDF Drawings/Open Rail Gantry Plate 40mm.PDF

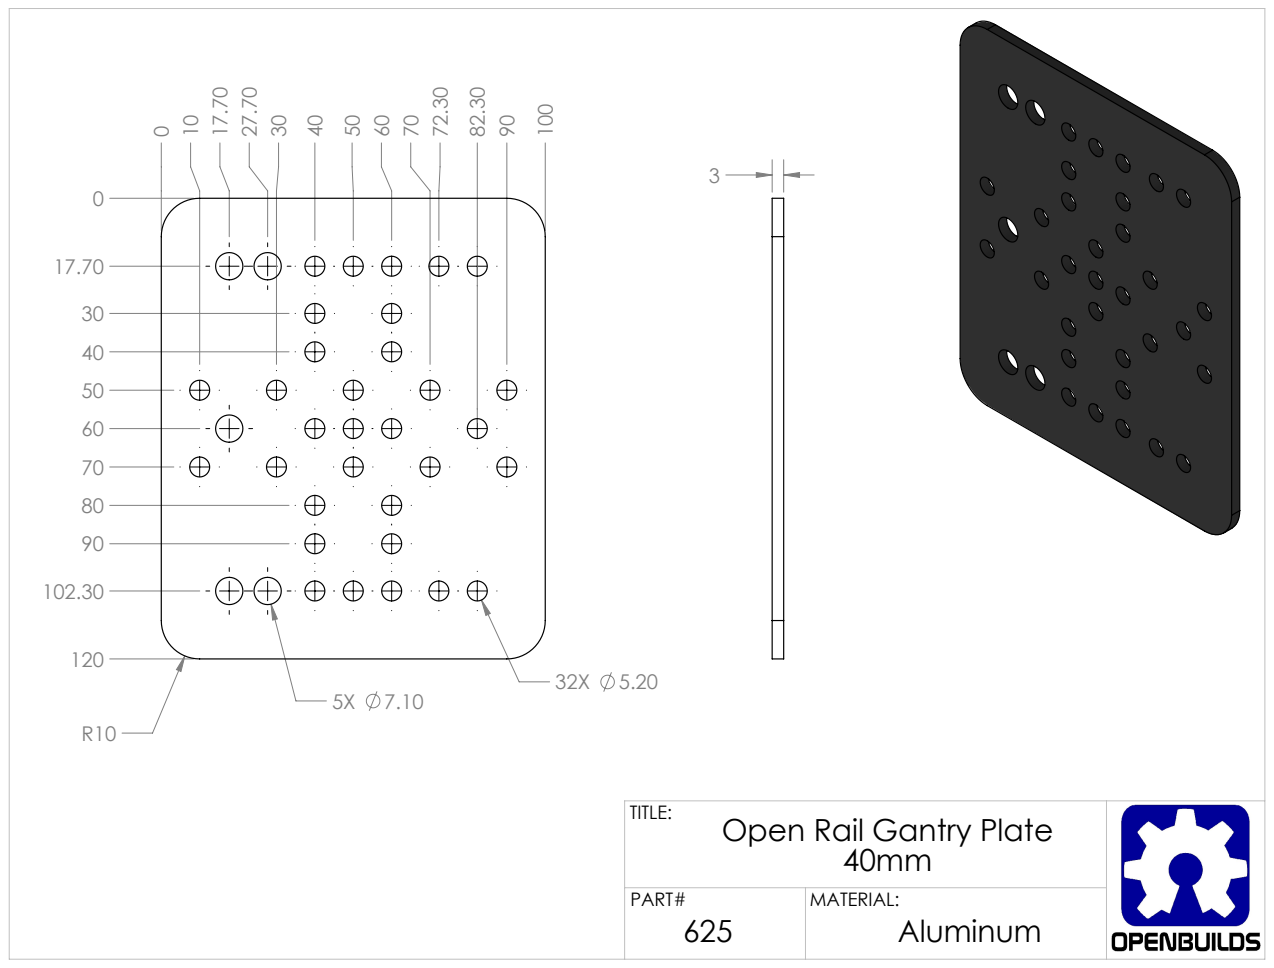
[picture p286: page 1]

TITLE: Open Rail Gantry Plate 40mm

PART# 625 | MATERIAL: Aluminum
