JNCox55/PLED/Mechanical/PLED_TEAM-4-28/PLED_TEAM-4-28/PLED_FINAL_MECHANICAL_FILES/SolidWorks_OpenBuilds2/PDF Drawings/Open Rail Gantry Plate 60mm.PDF

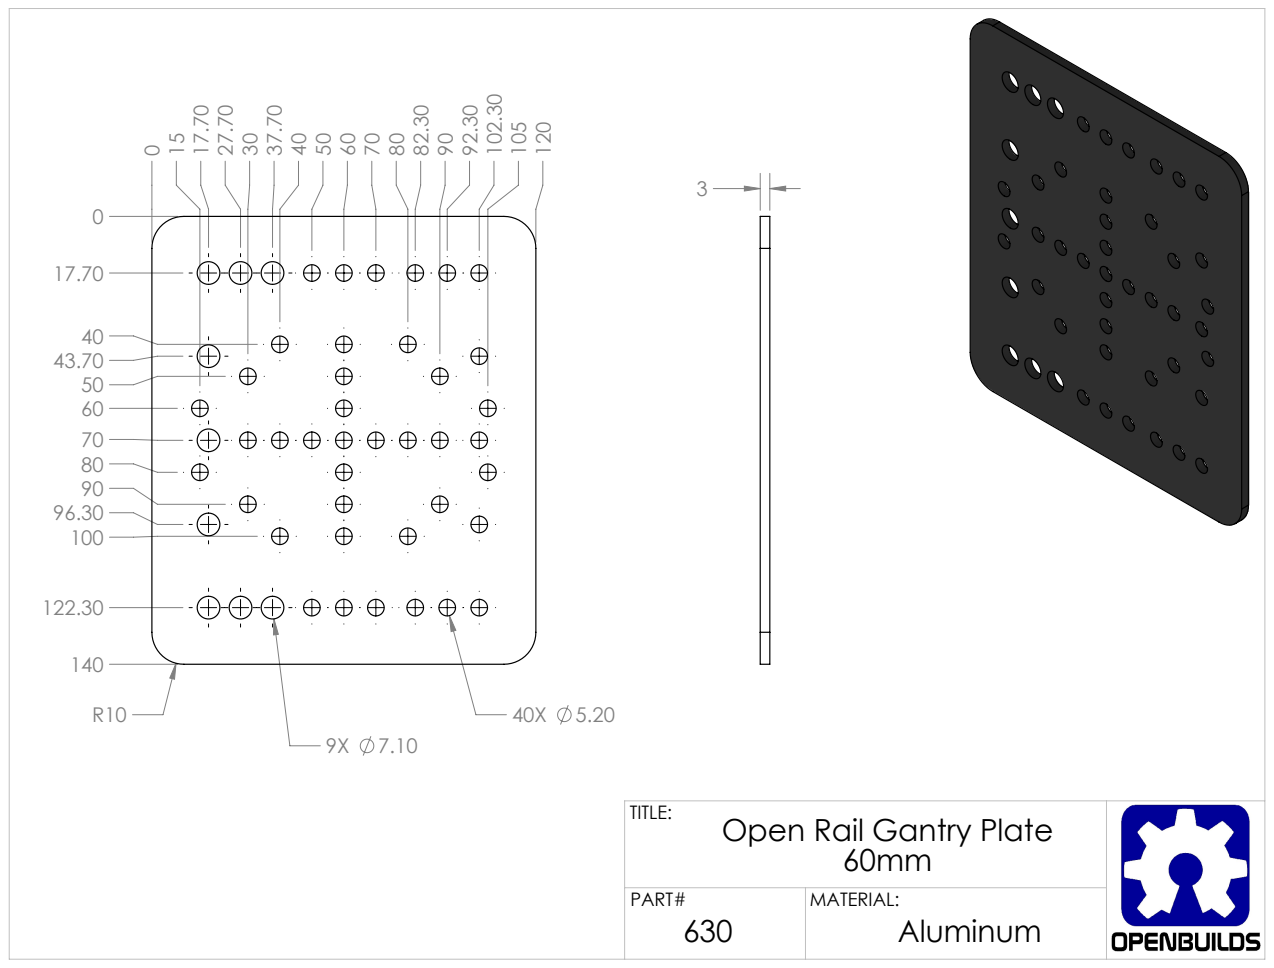
[picture p287: page 1]

TITLE: Open Rail Gantry Plate 60mm

PART# 630 | MATERIAL: Aluminum
