JNCox55/PLED/Mechanical/PLED_TEAM-4-28/PLED_TEAM-4-28/PLED_FINAL_MECHANICAL_FILES/SolidWorks_OpenBuilds2/PDF Drawings/Router Spindle Mount.PDF

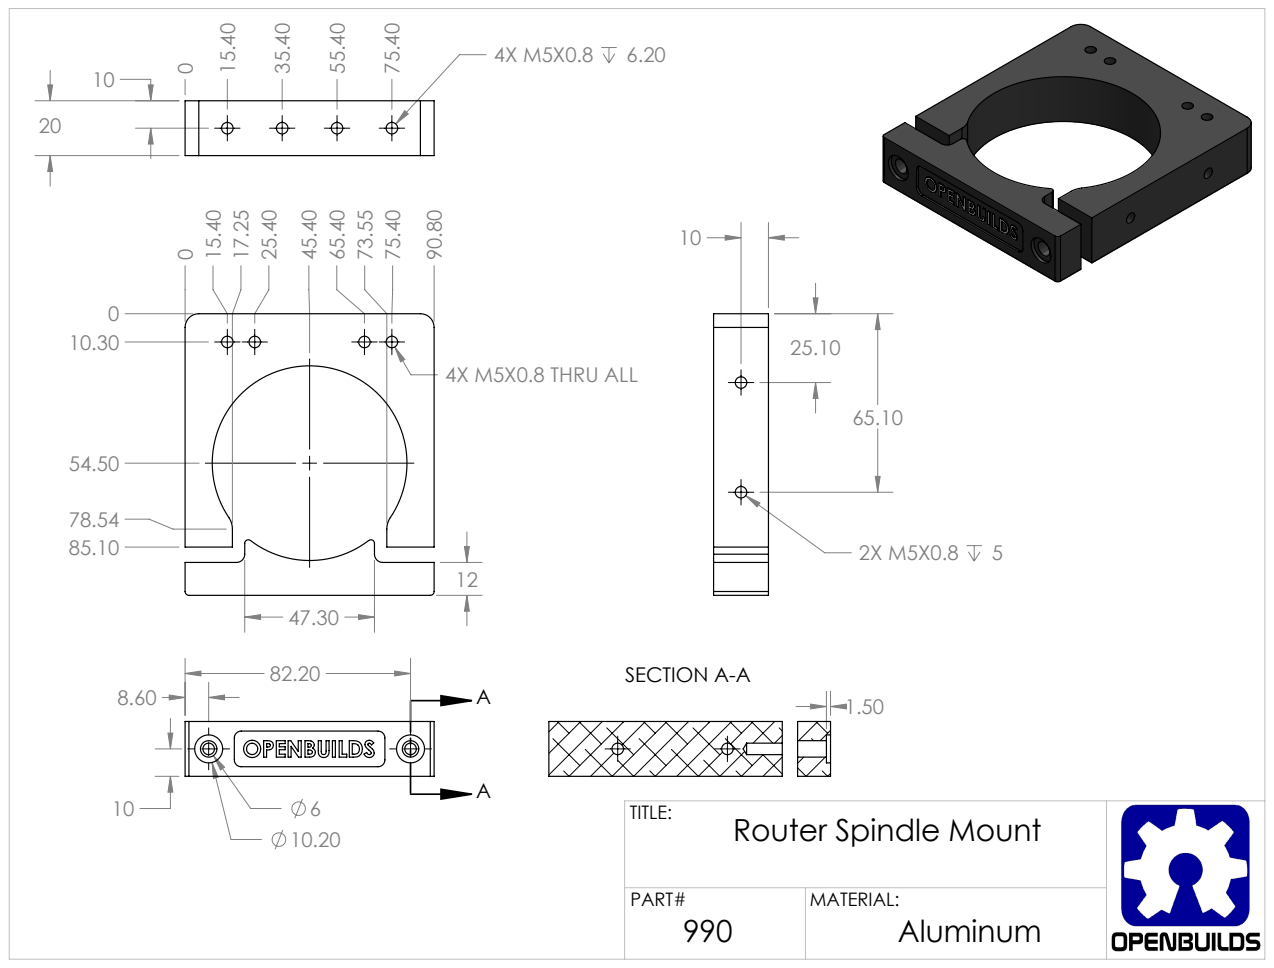
[picture p289: page 1]
4X M5X0.8 THRU ALL; SECTION A-A

TITLE: Router Spindle Mount

PART# 990 | MATERIAL: Aluminum
