JNCox55/PLED/Microcontroller Files./usblib/host/usbhostenum.c

//*****************************************************************************
//
// usbhostenum.c - Device enumeration code for the USB host library.
//
// Copyright (c) 2008-2015 Texas Instruments Incorporated.  All rights reserved.
// Software License Agreement
// 
// Texas Instruments (TI) is supplying this software for use solely and
// exclusively on TI's microcontroller products. The software is owned by
// TI and/or its suppliers, and is protected under applicable copyright
// laws. You may not combine this software with "viral" open-source
// software in order to form a larger program.
// 
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
// This is part of revision 2.1.1.71 of the Tiva USB Library.
//
//*****************************************************************************

#include <stdbool.h>
#include <stdint.h>
#include "inc/hw_ints.h"
#include "inc/hw_memmap.h"
#include "inc/hw_sysctl.h"
#include "inc/hw_types.h"
#include "driverlib/rom.h"
#include "driverlib/rom_map.h"
#include "driverlib/debug.h"
#include "driverlib/interrupt.h"
#include "driverlib/sysctl.h"
#include "driverlib/usb.h"
#include "driverlib/rtos_bindings.h"
#include "usblib/usblib.h"
#include "usblib/usblibpriv.h"
#include "usblib/usbulpi.h"
#include "usblib/host/usbhost.h"
#include "usblib/host/usbhostpriv.h"
#include "usblib/host/usbhhub.h"

#ifdef INCLUDE_DEBUG_OUTPUT
#include "utils/uartstdio.h"
#define DEBUG_OUTPUT UARTprintf
#else
#define DEBUG_OUTPUT while(0)((int32_t (*)(char *, ...))0)
#endif

//*****************************************************************************
//
//! \addtogroup usblib_hcd
//! @{
//
//*****************************************************************************

//*****************************************************************************
//
// External prototypes.
//
//*****************************************************************************
extern tUSBMode g_iUSBMode;

extern void OTGDeviceDisconnect(uint32_t ui32Index);

//*****************************************************************************
//
// Internal function prototypes.
//
//*****************************************************************************
static void USBHCDEP0StateTx(void);
static void USBHCDEnumHandler(void);
static void USBHCDClearFeature(uint32_t ui32DevAddress, uint32_t ui32Endpoint,
                               uint32_t ui32Feature);

//*****************************************************************************
//
// Automatic power enable.
//
//*****************************************************************************
#define USB_HOST_PWREN_AUTO     0x00000002
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
