JNCox55/PLED/(commit log)

2016-03-03 added all mechanical stuff
    [.125 Inch Aluminum Spacer.SLDPRT, .125 Inch Aluminum Spacer.igs, .125 Inch Aluminum Spacer.step, .125 Inch Nylon Spacer.SLDPRT, .125 Inch Nylon Spacer.igs, .125 Inch Nylon Spacer.step, .25 Inch Aluminum Spacer.SLDPRT, .25 Inch Aluminum Spacer.igs]
2016-03-15 updated costing and receipt information
    [Casey Costs.xlsx, Zach Costs.xlsx]
2016-03-20 Added step routine to move the stepper motors
2016-03-20 added home depot receipt
    [Casey Costs.xlsx]
2016-03-21 added documentation stuff
    [PLED Gantt.xlsx]
2016-03-28 Added fixes to the multiple sending of rows
    [main.c, main.cpp]
2016-04-01 Fixed serial communication errors
    [Serial.cpp, Serial.h, main.c, main.cpp, new 1.c]
2016-04-05 Fixed the GO bug
    [main.c]
2016-04-05 updated receipts
    [Casey Costs.xlsx, PLED Gantt.xlsx, Zach Costs.xlsx]
2016-04-09 update financial stuff
    [Casey Costs.xlsx]
2016-04-09 Fixed remaining merge errors
    [main.c]
2016-04-14 updated costing
    [Casey Costs.xlsx, Zach Costs.xlsx]
2016-04-14 updated serial to include COM line, reduced burn duration
    [main.cpp]
2016-04-14 updated schematic
2016-04-15 Finished Schematic
2016-04-15 tweaked encoders
2016-04-18 Added new burning process
    [main.c]
2016-04-18 implemented new burning process
    [main.c]
2016-04-19 adjusted burn time per pixel.
    [Casey Costs.xlsx]
2016-04-19 wrote most of final report
    [Budget.xlsx, PLED Gantt.xlsx]
2016-04-25 updated GUI slightly, receipts
    [Casey Costs.xlsx]
2016-05-03 finished documentation, added mechanical files
    [.125 Inch Aluminum Spacer.SLDPRT, .125 Inch Aluminum Spacer.igs, .125 Inch Aluminum Spacer.step, .125 Inch Nylon Spacer.SLDPRT, .125 Inch Nylon Spacer.igs, .125 Inch Nylon Spacer.step, .25 Inch Aluminum Spacer.SLDPRT, .25 Inch Aluminum Spacer.igs]
2016-05-05 added receipts, appeased baker...
    [Casey Costs.xlsx, Zach Costs.xlsx]
2016-05-05 updated all reimbursement stuff
    [Reimbursement request.xlsx]
